lpm97/BA_MagicTrick/6_Fotos/PXL_20210323_134111129.jpg

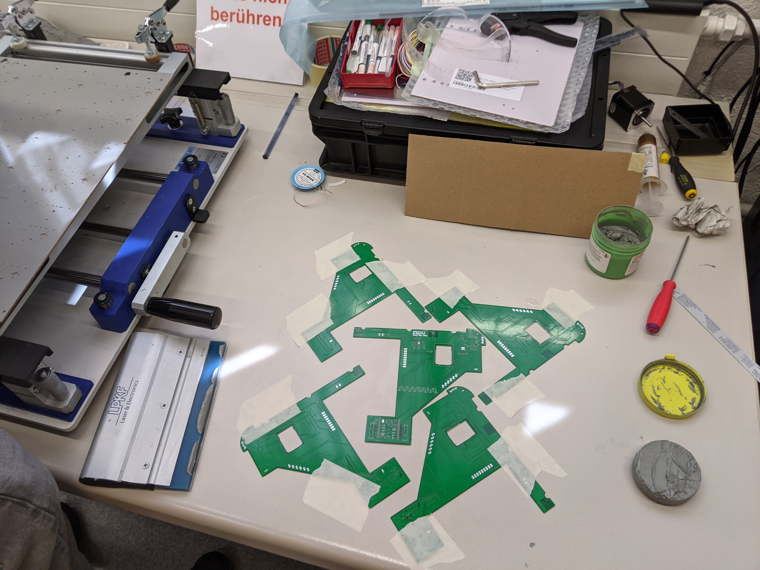
6_Fotos/PXL_20210323_134111129.jpg
