lpm97/BA_MagicTrick/6_Fotos/20210529_131418.jpg

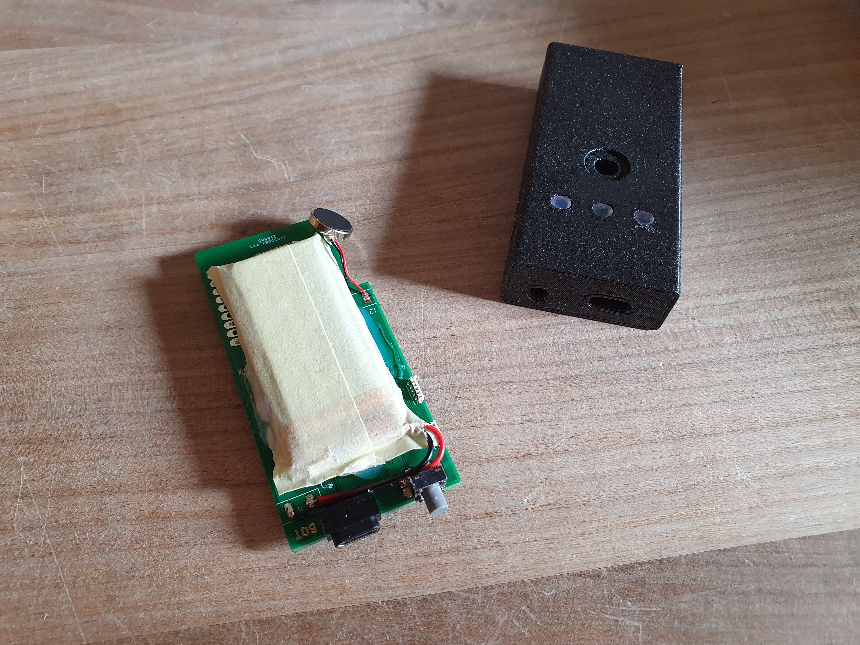
6_Fotos/20210529_131418.jpg
