lpm97/BA_MagicTrick/Ordnerstruktur.pdf

Ordnerstruktur

### Ordnerstruktur

### 0 BA wuem 05 Bericht

### 1 Reader

CAD-Files

Eagle-Projekt

Reader Code

### 2 Whiteboard

CAD-Files

Eagle-Projekt

WB2 Code

### 3 Puzzlerahmen

CAD-Files

Eagle-Projekt

Puzzle Code

### 4 Fernbedienung

CAD-Files

Eagle-Projekt

Remote Code

### 5 Eagle Library

Step-Files

### 6 Fotos

### 7 Bestellungen

11.06.2021 / Marco Mathys, Louis Muntwyler | 1 / 1
