lpm97/BA_MagicTrick/7_Bestellungen/4_Bestellung_BA_Magic_DigiKey_03_25.pdf

ARTIKELNUMMER | BEZEICHNUNG | Anzahl Einzelpreis
336-1160-1-ND | IC USB-TO-UART BRIDGE 28VQFN | 3 | 2.97
1144-1320-ND | SOLENOID PULL PULSE 5V | 1 | 9.14
1543-1001-ND | RFID TAG R/W 860-960MHZ INLAY | 25 | 0.35
1543-1002-ND | RFID TAG R/W 860-960MHZ INLAY | 25 | 0.35
1543-1011-ND | RFID TAG R/W 860-960MHZ INLAY | 25 | 0.35
1460-1159-ND | STEPPER MOTOR DRIVER BRD TMC2100 | 2 | 7.18
| | | 58.66
