lpm97/BA_MagicTrick/7_Bestellungen/5_Bestellung_BA_Magic_Conrad_04_13.pdf

ARTIKELNUMMER | BEZEICHNUNG | Anzahl Einzelpreis
802243954 - 62 | Pololu DRV8834 Low-Voltage Stepper Motortreiber Carrier | 4 | 5.66

22.64
