lpm97/BA_MagicTrick/2_Whiteboard/Eagle-Projekt/Bestückung_WB2.pdf

U5

# TCS40DPR

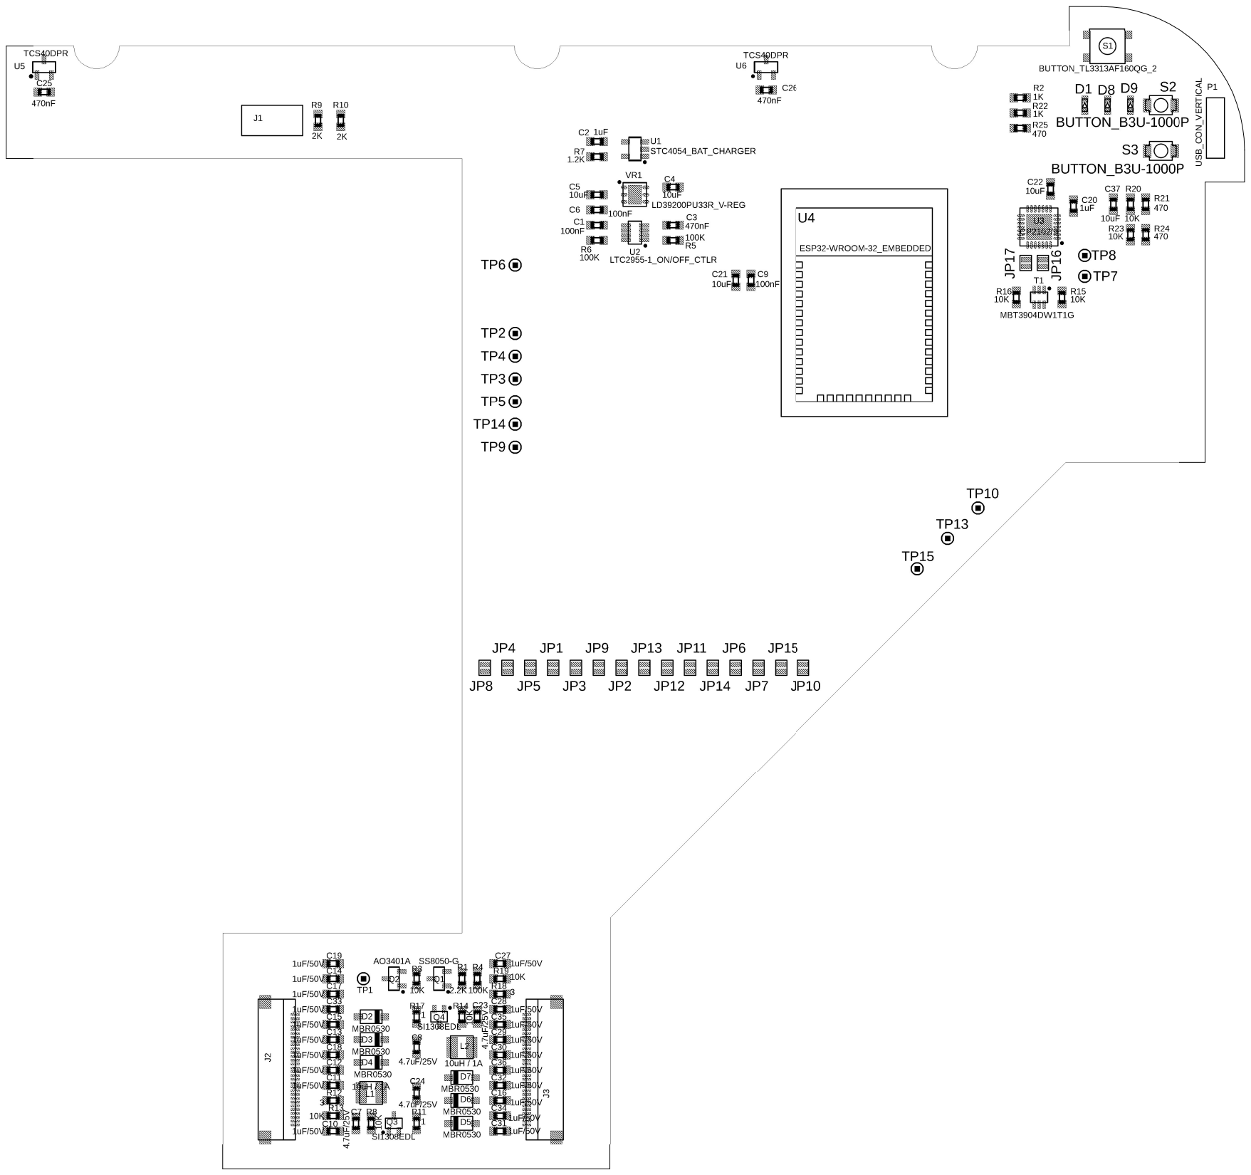
[picture p3: page 1]

P1 4.7uF/25V

470nF | USB_CON_VERTICAL
