lpm97/BA_MagicTrick/7_Bestellungen/8_Bestellung_BA_Magic_JLCPCB_05_05.pdf

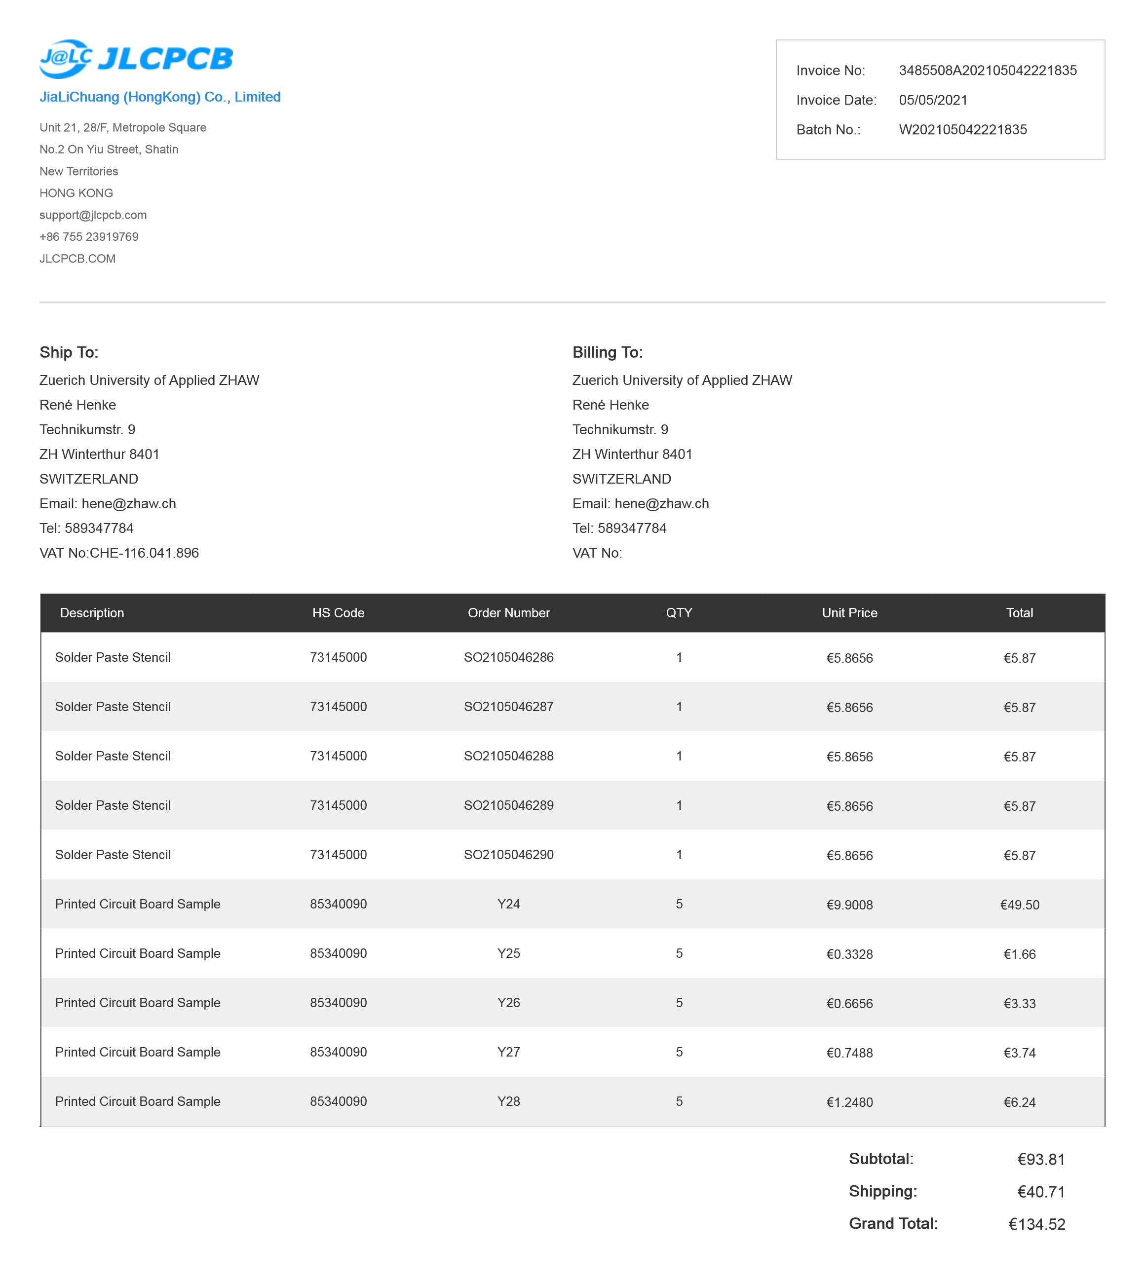
[picture p4: page 1]
