lpm97/BA_MagicTrick/6_Fotos/20210429_133818.jpg

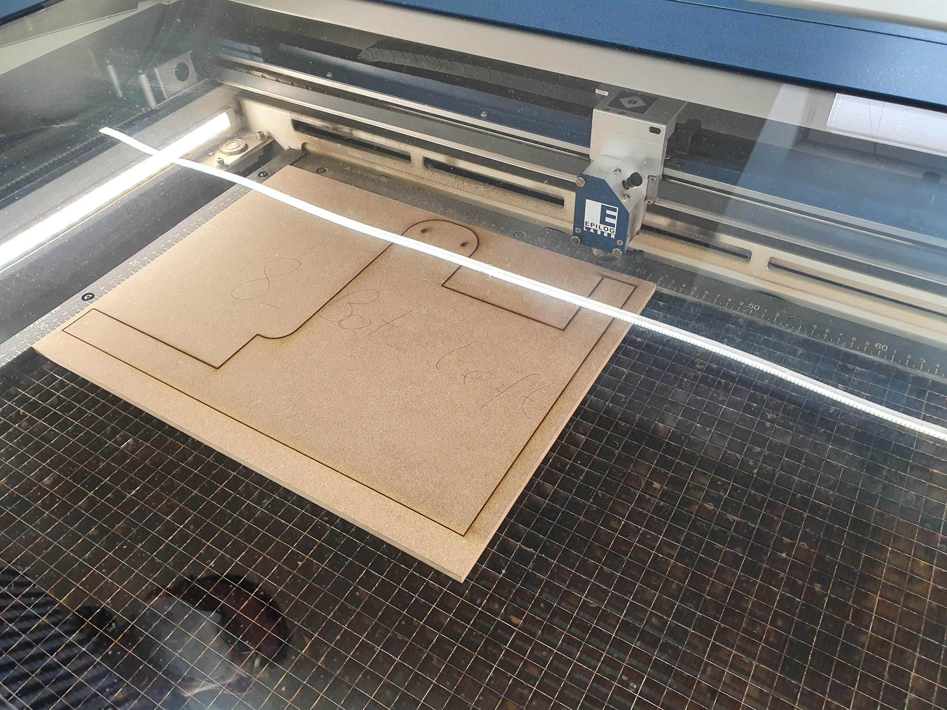
6_Fotos/20210429_133818.jpg
