lpm97/BA_MagicTrick/6_Fotos/20210510_140635.jpg

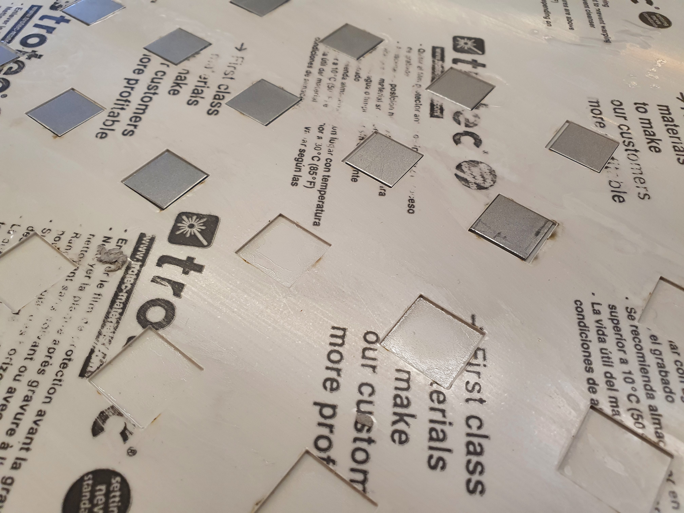
6_Fotos/20210510_140635.jpg
