lpm97/BA_MagicTrick/6_Fotos/20210518_130427.jpg

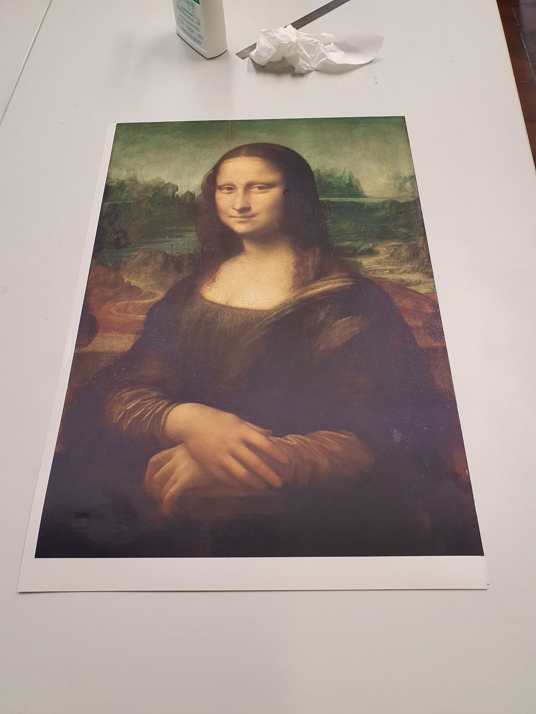
6_Fotos/20210518_130427.jpg
