lpm97/BA_MagicTrick/6_Fotos/20210529_162816 (2).jpg

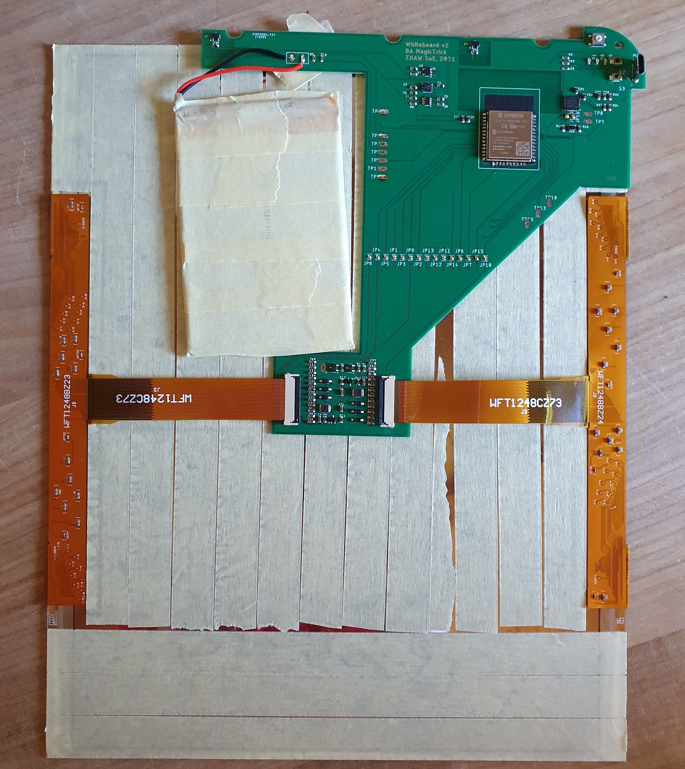
6_Fotos/20210529_162816 (2).jpg
