lpm97/BA_MagicTrick/6_Fotos/20210606_123722.jpg

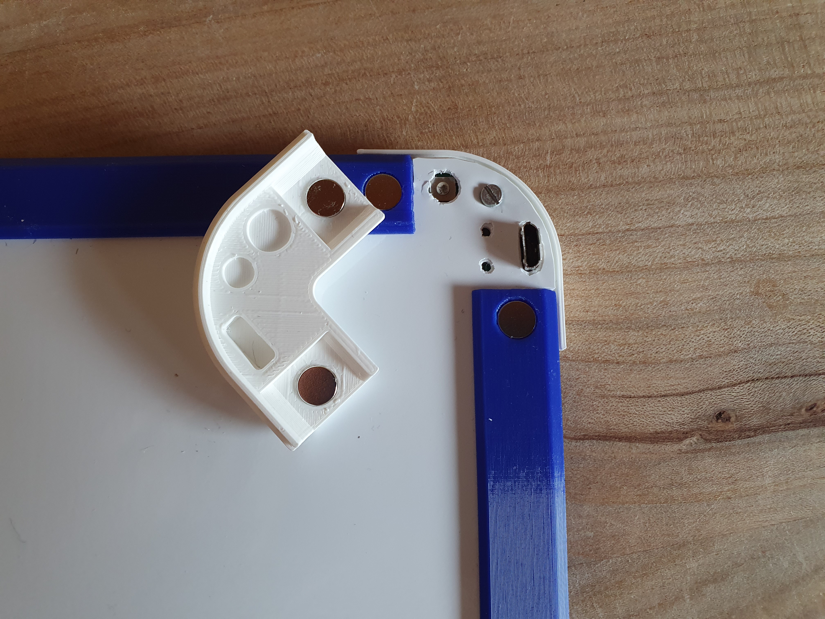
6_Fotos/20210606_123722.jpg
