lpm97/BA_MagicTrick/6_Fotos/20210608_213959.jpg

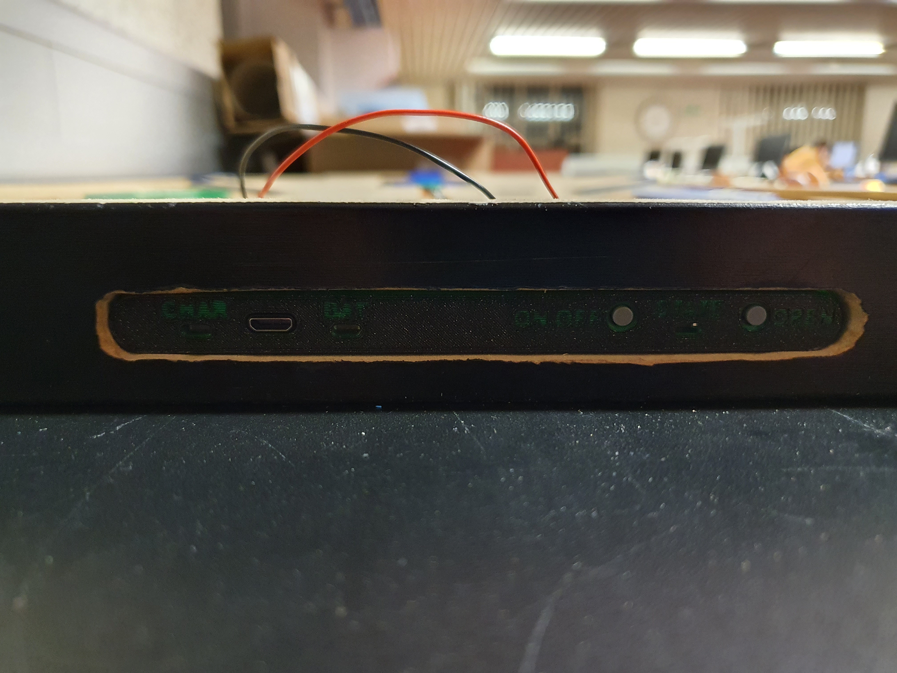
6_Fotos/20210608_213959.jpg
