lpm97/BA_MagicTrick/6_Fotos/20210609_110846.jpg

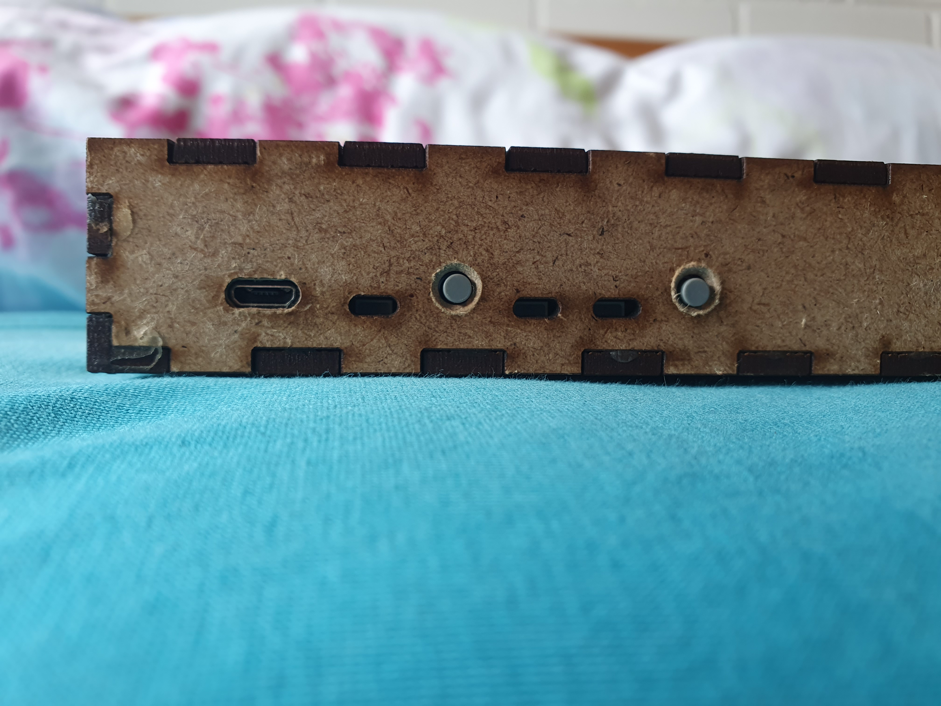
6_Fotos/20210609_110846.jpg
