lpm97/BA_MagicTrick/6_Fotos/20210609_110910.jpg

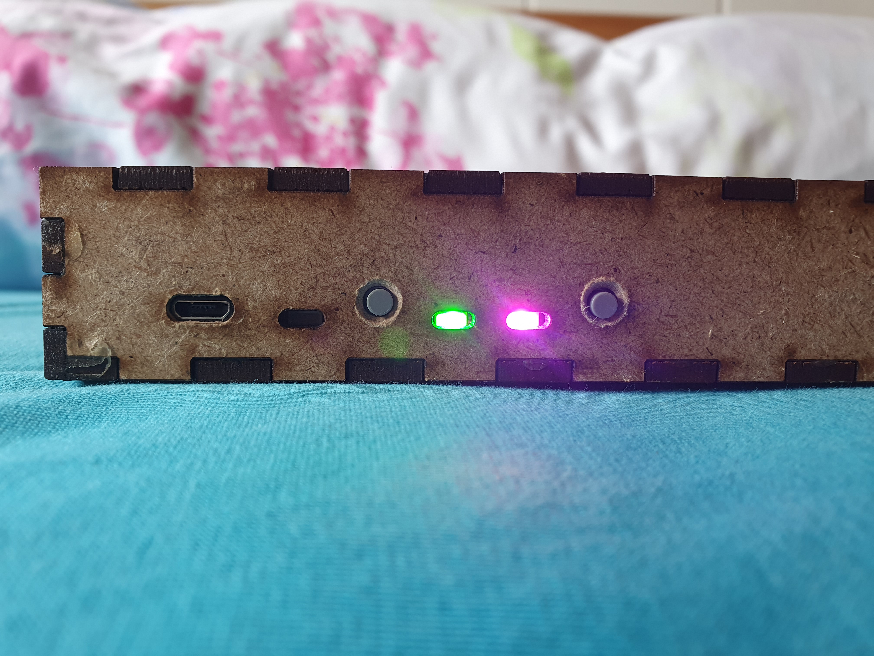
6_Fotos/20210609_110910.jpg
