lpm97/BA_MagicTrick/6_Fotos/PXL_20210330_091742719.jpg

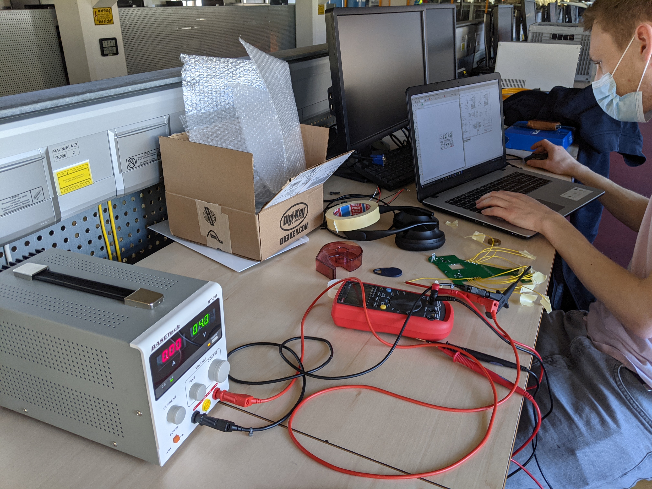
6_Fotos/PXL_20210330_091742719.jpg
