lpm97/BA_MagicTrick/6_Fotos/PXL_20210408_143214023.jpg

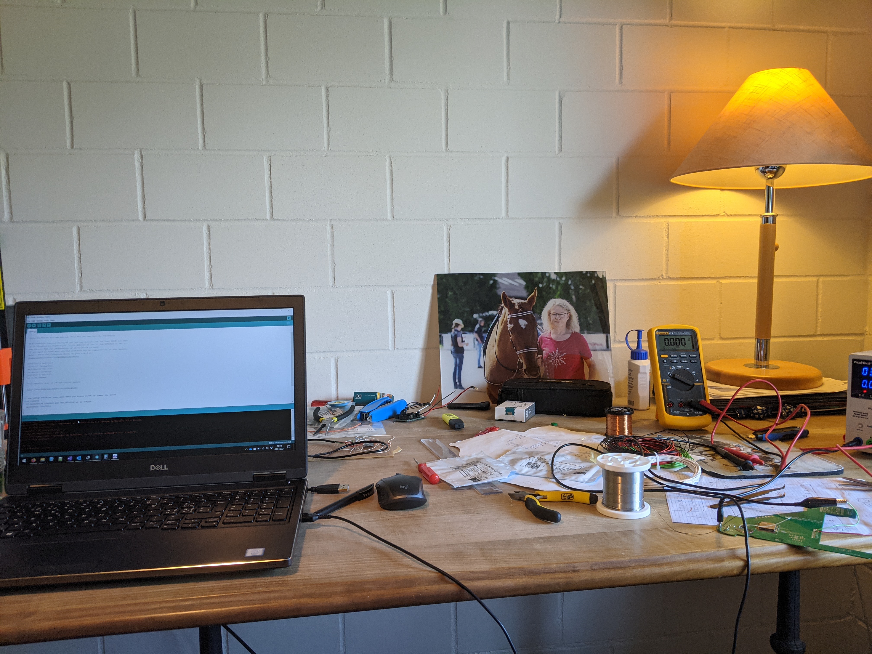
6_Fotos/PXL_20210408_143214023.jpg
