lpm97/BA_MagicTrick/6_Fotos/PXL_20210414_161440249.jpg

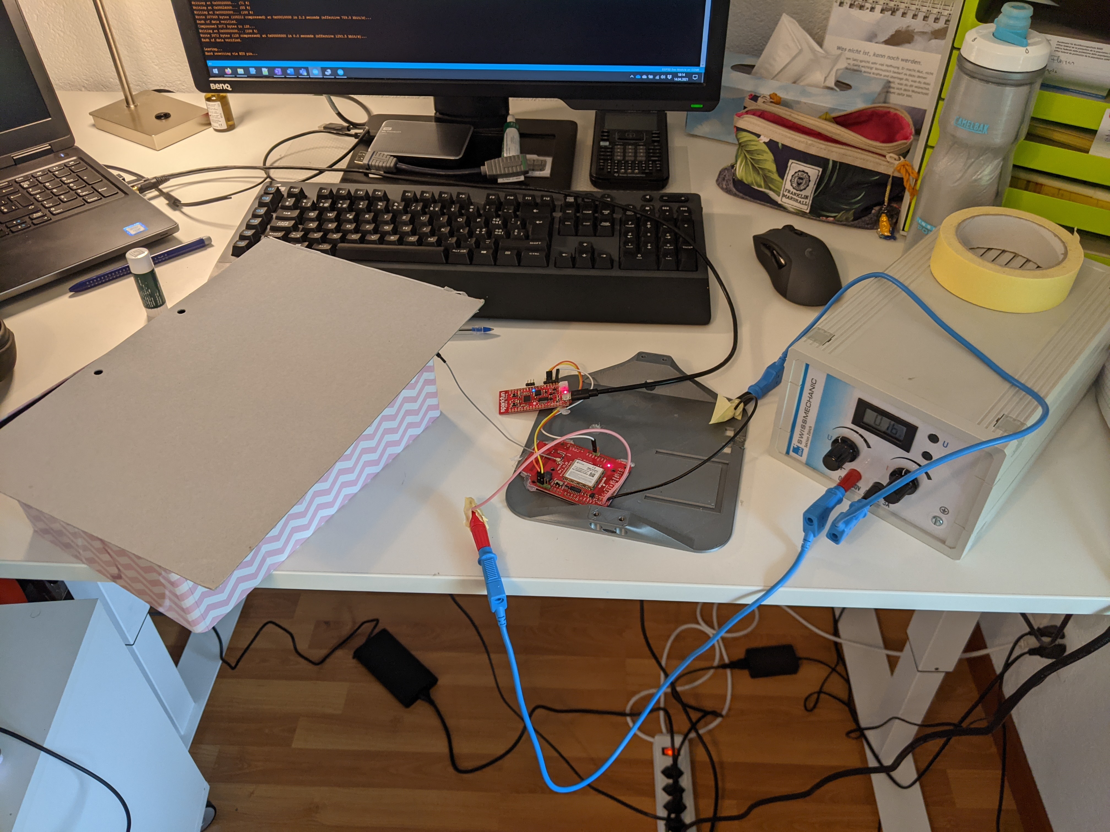
6_Fotos/PXL_20210414_161440249.jpg
