lpm97/BA_MagicTrick/6_Fotos/PXL_20210429_111400722.jpg

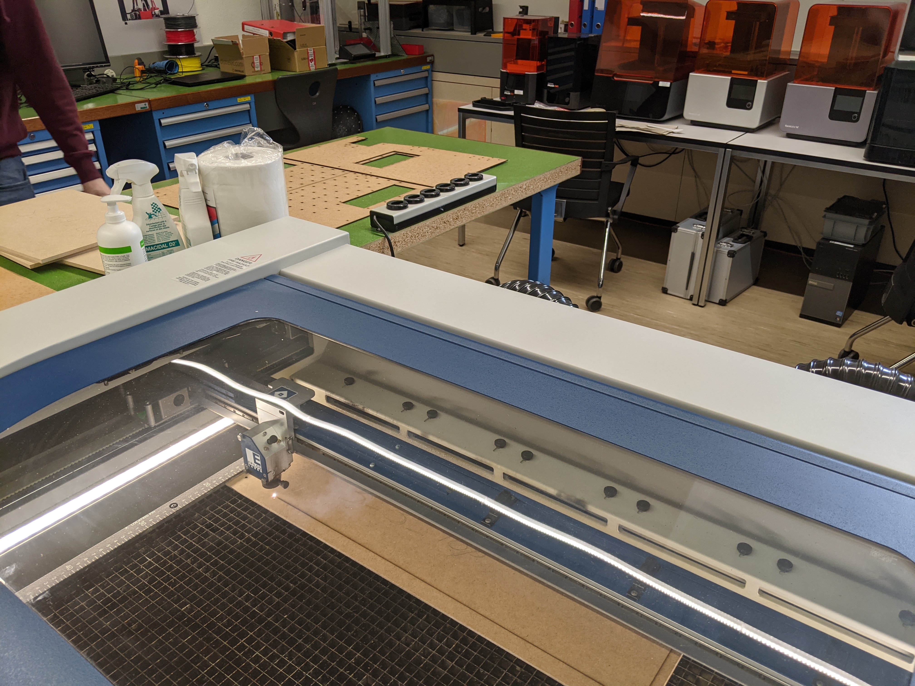
6_Fotos/PXL_20210429_111400722.jpg
