lpm97/BA_MagicTrick/2_Whiteboard/CAD-Files/BA_WB2_Assembly v29.stl

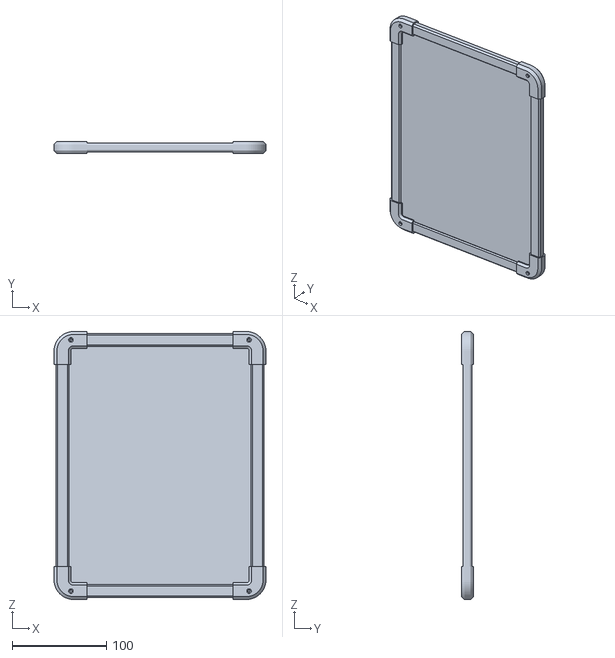
[picture p39: CAD file, 2021-06-11]
2_Whiteboard/CAD-Files/BA_WB2_Assembly v29.stl
225.2 x 13.0 x 284.7
