lpm97/BA_MagicTrick/5_Eagle_Library/Step-Files/LED_RGB_ASMB-TTF2-0B20B.step

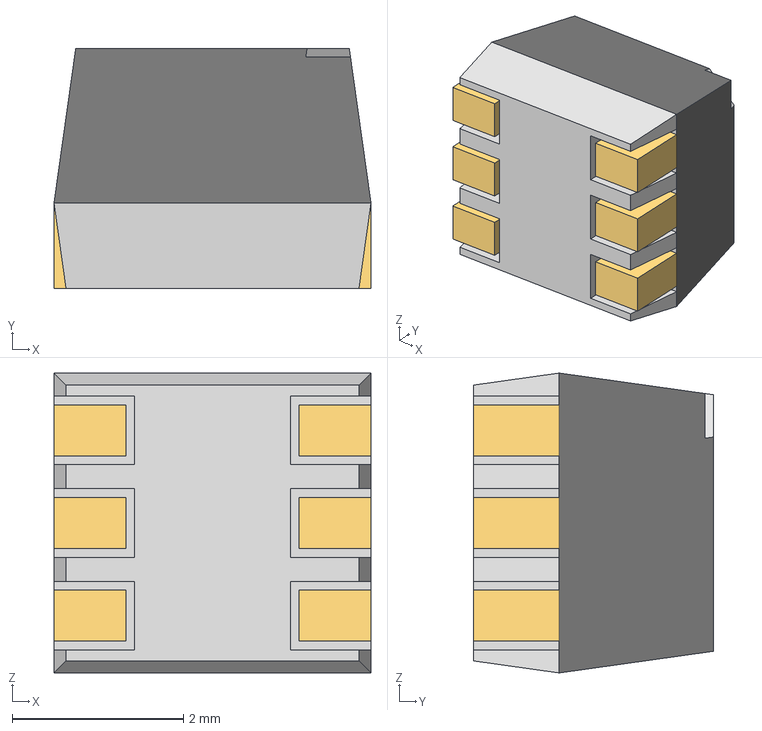
[picture p40: CAD file, 2021-06-11]
5_Eagle_Library/Step-Files/LED_RGB_ASMB-TTF2-0B20B.step
3.70 x 2.80 x 3.50 mm
