lpm97/BA_MagicTrick/3_Puzzlerahmen/CAD-Files/BA_Puzzle_Gear_Oeffnung v17.stl

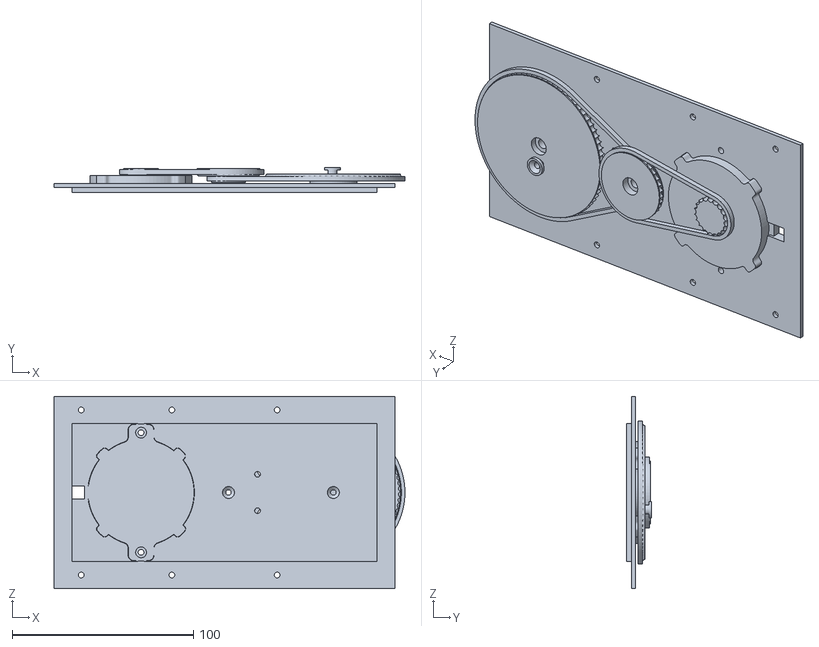
[picture p41: CAD file, 2021-06-11]
3_Puzzlerahmen/CAD-Files/BA_Puzzle_Gear_Oeffnung v17.stl
193.5 x 14.0 x 106.0
