lpm97/BA_MagicTrick/4_Fernbedienung/CAD-Files/BA_RemoteControl_Housing v5.stl

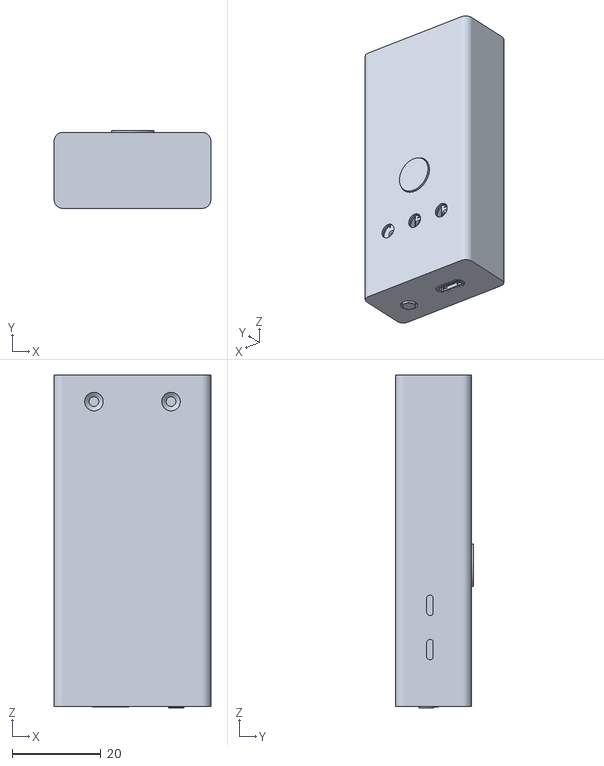
[picture p42: CAD file, 2021-06-11]
4_Fernbedienung/CAD-Files/BA_RemoteControl_Housing v5.stl
35.4 x 17.6 x 75.2
