lpm97/BA_MagicTrick/5_Eagle_Library/Step-Files/USB_Con_90_ZX62WRD-B-5PC.stp

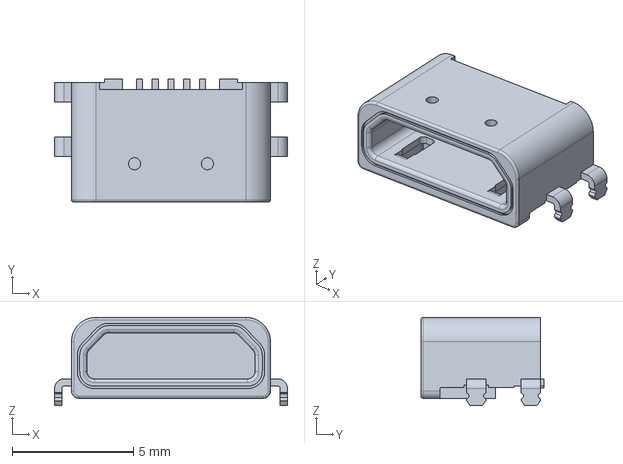
[picture p43: CAD file, 2021-06-11]
5_Eagle_Library/Step-Files/USB_Con_90_ZX62WRD-B-5PC.stp
9.60 x 5.09 x 3.63 mm
