lpm97/BA_MagicTrick/2_Whiteboard/CAD-Files/BA_WB2_PCB v3.stl

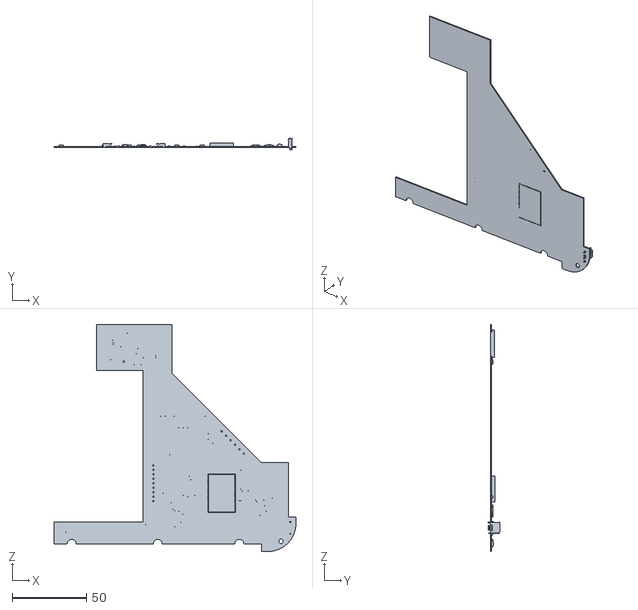
[picture p44: CAD file, 2021-06-11]
2_Whiteboard/CAD-Files/BA_WB2_PCB v3.stl
163.1 x 7.91 x 153.0
