lpm97/BA_MagicTrick/3_Puzzlerahmen/CAD-Files/BA_Puzzle_Seilwinde2 v18.stl

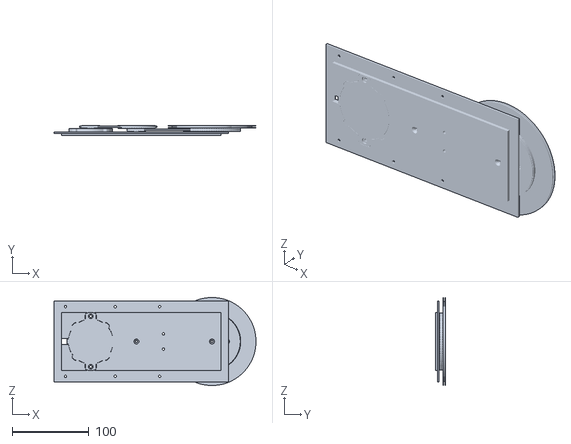
[picture p45: CAD file, 2021-06-11]
3_Puzzlerahmen/CAD-Files/BA_Puzzle_Seilwinde2 v18.stl
263.9 x 13.4 x 115.0
