lpm97/BA_MagicTrick/4_Fernbedienung/CAD-Files/RemoteControl_PCB v7.stl

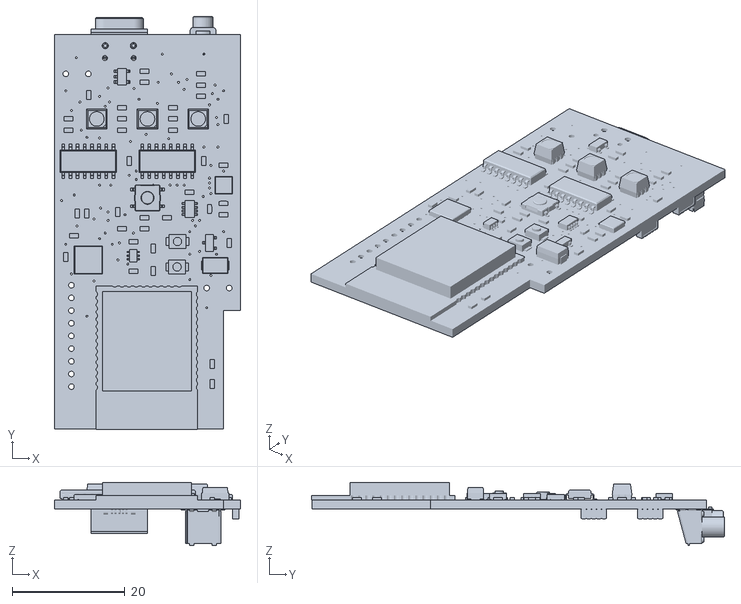
[picture p46: CAD file, 2021-06-11]
4_Fernbedienung/CAD-Files/RemoteControl_PCB v7.stl
33.0 x 73.3 x 11.2
