lpm97/BA_MagicTrick/5_Eagle_Library/Step-Files/Dubox14P_90_Male.stp

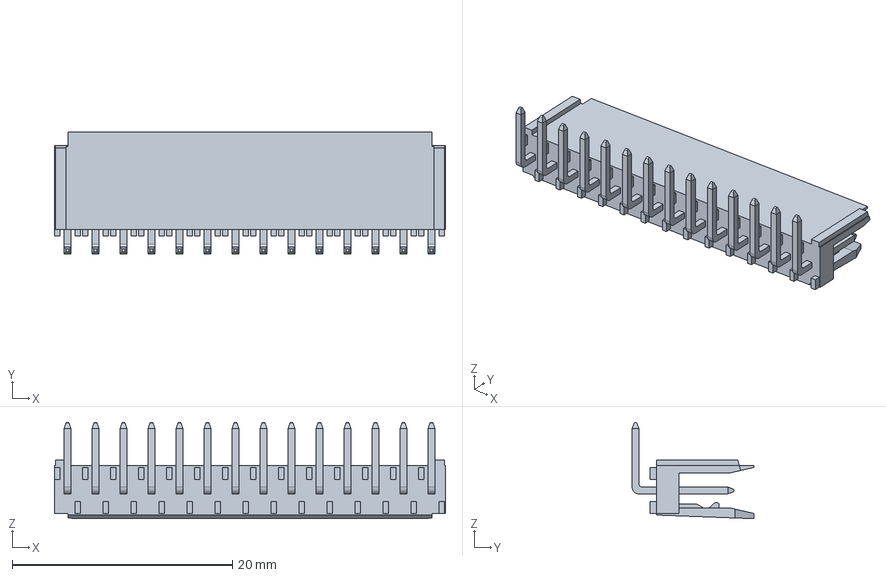
[picture p47: CAD file, 2021-06-11]
5_Eagle_Library/Step-Files/Dubox14P_90_Male.stp
35.5 x 11.0 x 8.74 mm
