lpm97/BA_MagicTrick/2_Whiteboard/CAD-Files/BA_WB2_Edge_bot v12.stl

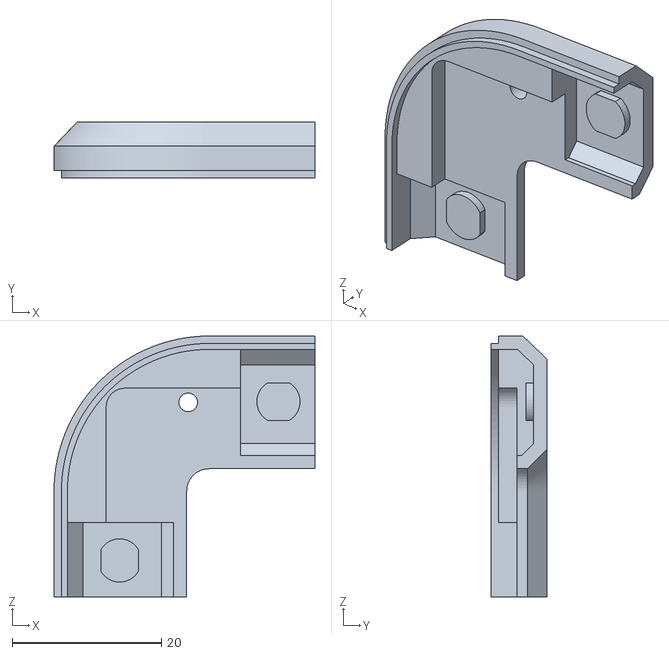
[picture p48: CAD file, 2021-06-11]
2_Whiteboard/CAD-Files/BA_WB2_Edge_bot v12.stl
35.0 x 7.50 x 35.0
