lpm97/BA_MagicTrick/3_Puzzlerahmen/CAD-Files/BA_Puzzle_CableOutput2 v16.stl

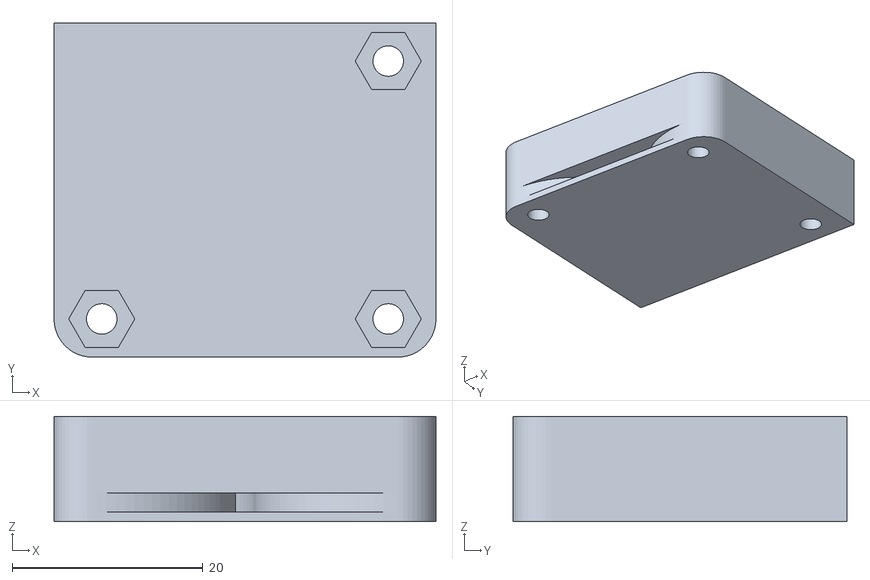
[picture p49: CAD file, 2021-06-11]
3_Puzzlerahmen/CAD-Files/BA_Puzzle_CableOutput2 v16.stl
40.0 x 35.0 x 11.0
