lpm97/BA_MagicTrick/5_Eagle_Library/Step-Files/Cap_0603.stp

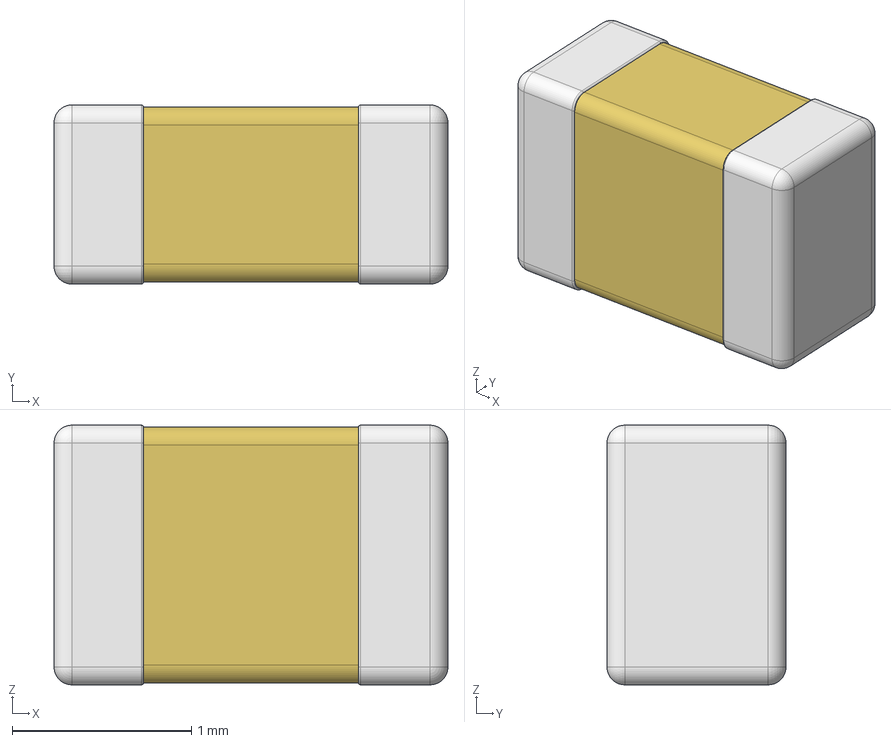
[picture p50: CAD file, 2021-06-11]
5_Eagle_Library/Step-Files/Cap_0603.stp
2.20 x 1.00 x 1.45 mm
