lpm97/BA_MagicTrick/2_Whiteboard/CAD-Files/BA_WB2_Display14.48.stl

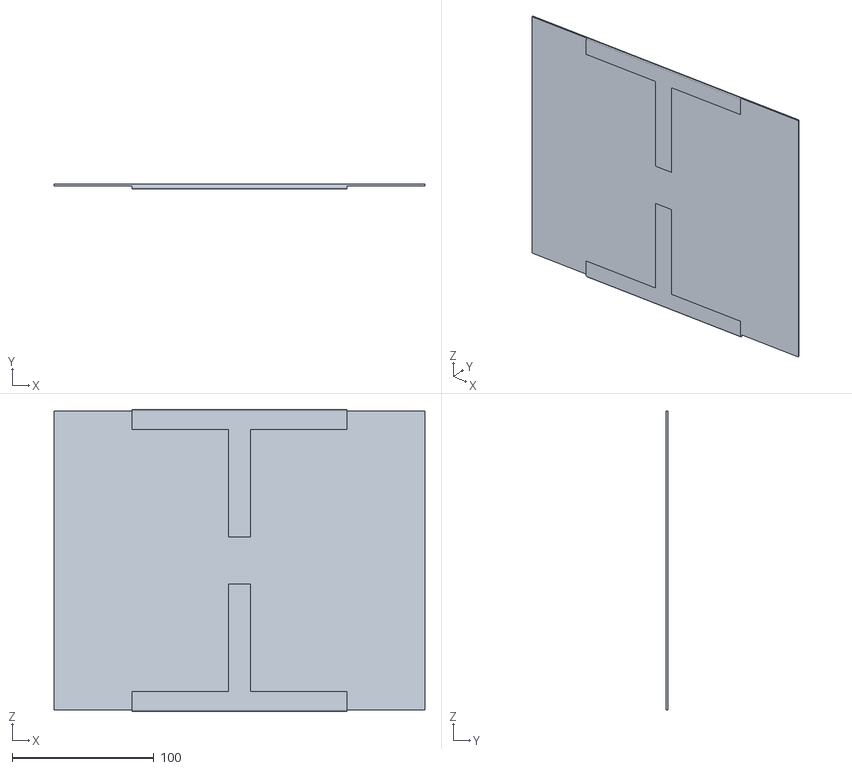
[picture p51: CAD file, 2021-06-11]
2_Whiteboard/CAD-Files/BA_WB2_Display14.48.stl
261.5 x 3.20 x 213.2
