lpm97/BA_MagicTrick/3_Puzzlerahmen/CAD-Files/BA_Puzzle_Umlenkrolle2 v18.stl

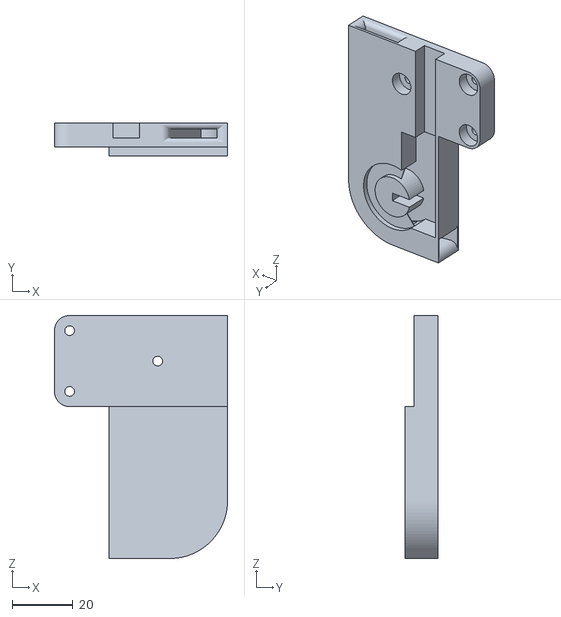
[picture p52: CAD file, 2021-06-11]
3_Puzzlerahmen/CAD-Files/BA_Puzzle_Umlenkrolle2 v18.stl
57.0 x 11.0 x 80.0
