lpm97/BA_MagicTrick/5_Eagle_Library/Step-Files/USB_Con_90_UJ2.step

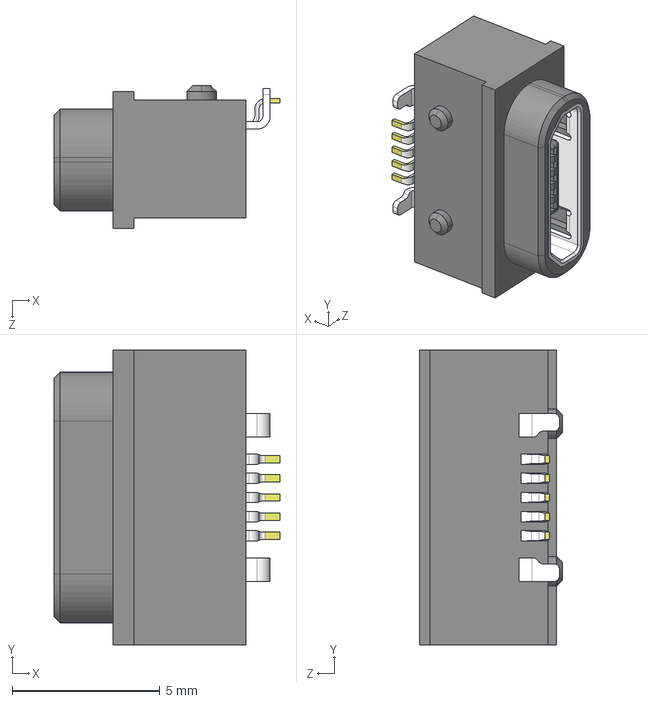
[picture p53: CAD file, 2021-06-11]
5_Eagle_Library/Step-Files/USB_Con_90_UJ2.step
7.65 x 10.0 x 4.85 mm
