lpm97/BA_MagicTrick/2_Whiteboard/CAD-Files/BA_WB2_Edge_Int_Top v21.stl

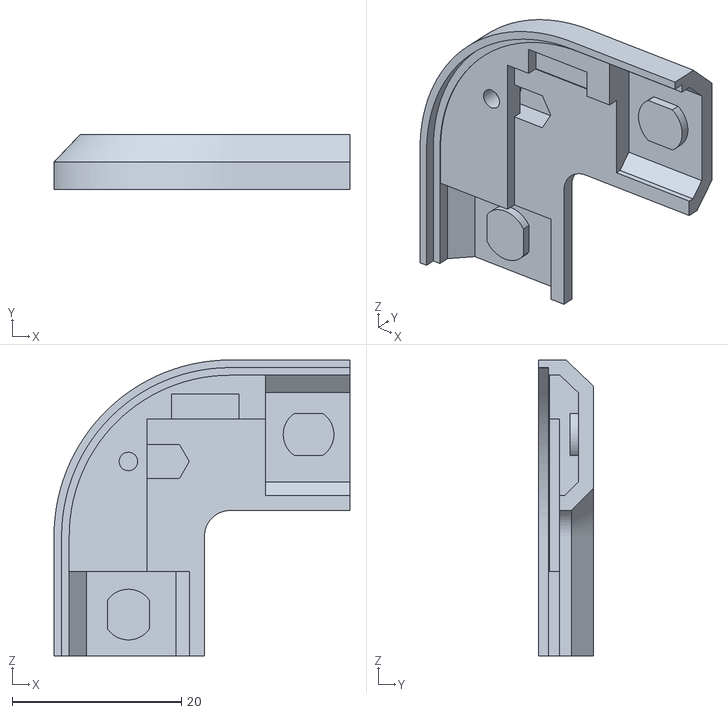
[picture p54: CAD file, 2021-06-11]
2_Whiteboard/CAD-Files/BA_WB2_Edge_Int_Top v21.stl
35.0 x 6.50 x 35.0
