lpm97/BA_MagicTrick/3_Puzzlerahmen/CAD-Files/BA_Puzzle_Tilt2 v27.stl

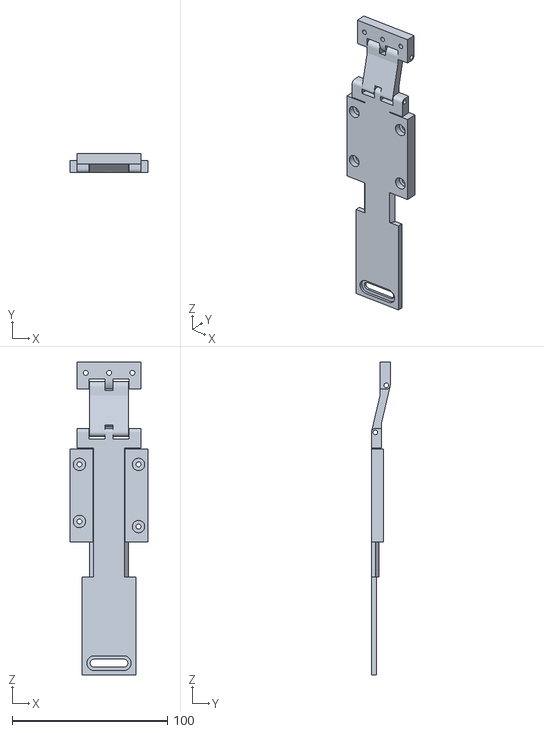
[picture p55: CAD file, 2021-06-11]
3_Puzzlerahmen/CAD-Files/BA_Puzzle_Tilt2 v27.stl
50.0 x 12.3 x 201.3
