lpm97/BA_MagicTrick/5_Eagle_Library/Step-Files/srn3015-100m_induction.stp

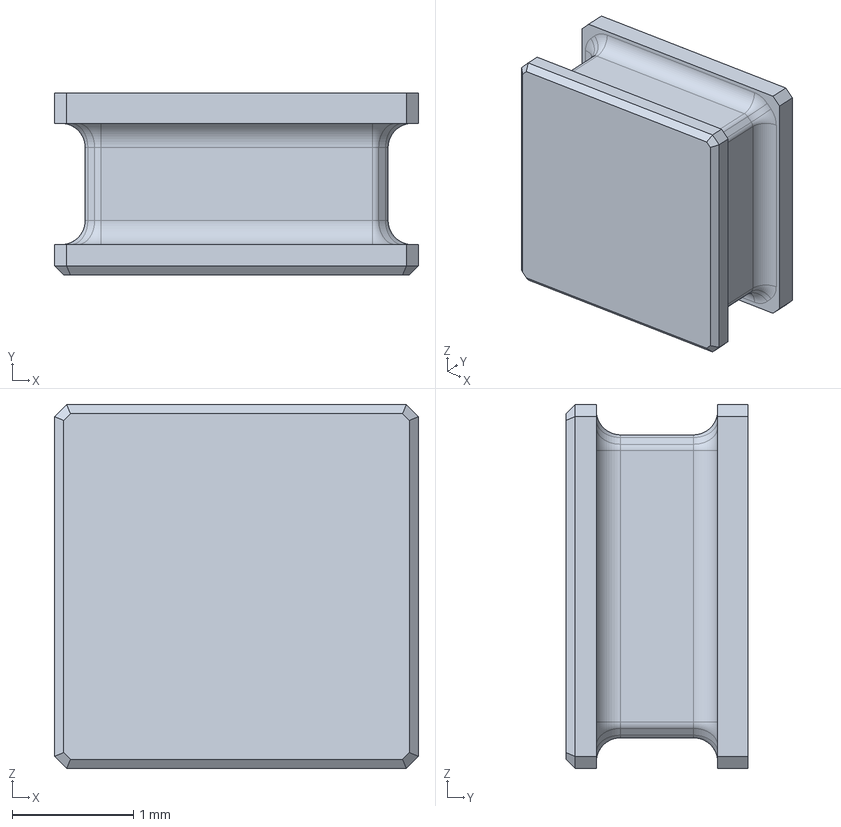
[picture p56: CAD file, 2021-06-11]
5_Eagle_Library/Step-Files/srn3015-100m_induction.stp
3.00 x 1.50 x 3.00 mm
