lpm97/BA_MagicTrick/2_Whiteboard/CAD-Files/BA_WB2_Side_Right v4.stl

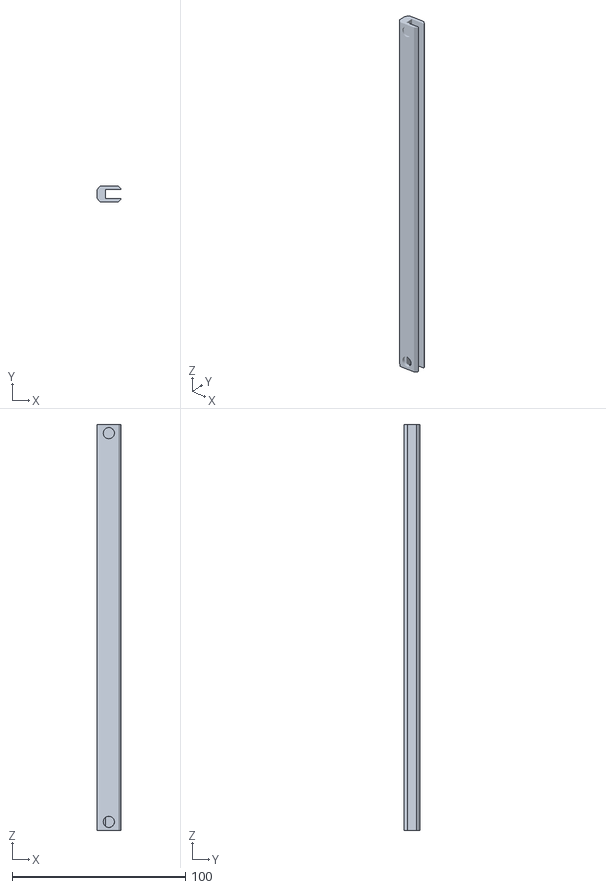
[picture p57: CAD file, 2021-06-11]
2_Whiteboard/CAD-Files/BA_WB2_Side_Right v4.stl
14.0 x 9.20 x 234.5
