lpm97/BA_MagicTrick/3_Puzzlerahmen/CAD-Files/BA_Puzzle_Backmount v7.stl

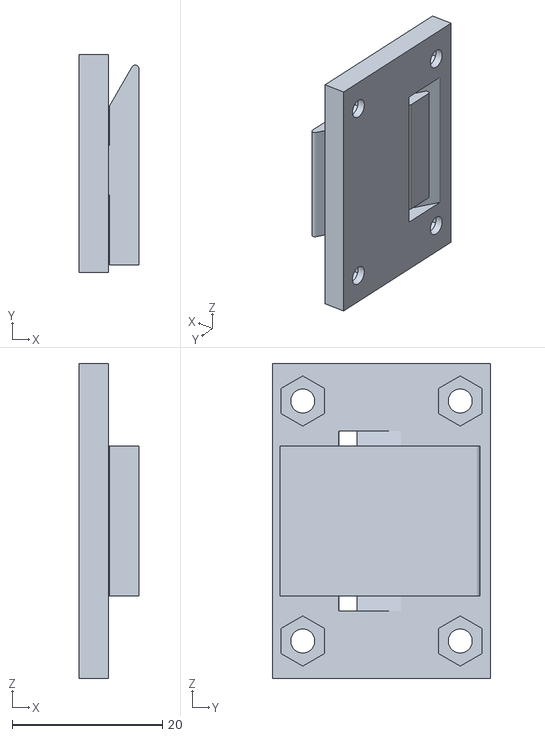
[picture p58: CAD file, 2021-06-11]
3_Puzzlerahmen/CAD-Files/BA_Puzzle_Backmount v7.stl
8.00 x 29.0 x 42.0
