lpm97/BA_MagicTrick/5_Eagle_Library/Step-Files/Dubox12P_90_Male.stp

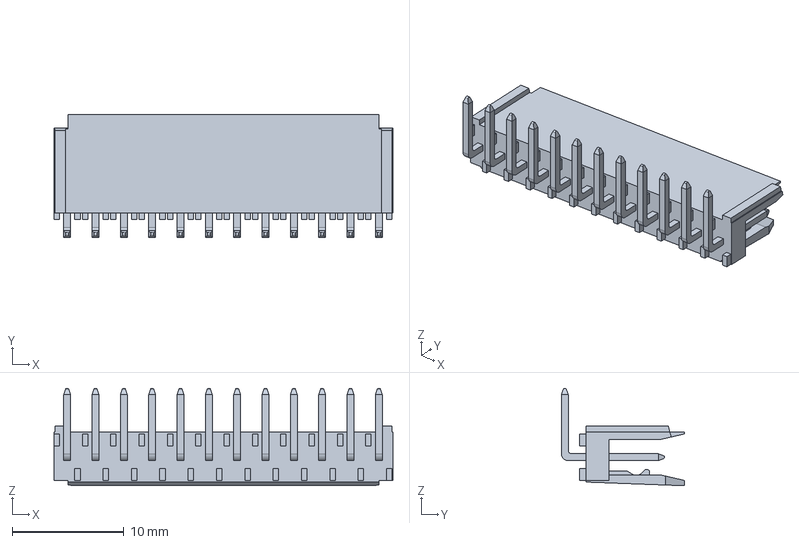
[picture p59: CAD file, 2021-06-11]
5_Eagle_Library/Step-Files/Dubox12P_90_Male.stp
30.4 x 11.0 x 8.74 mm
