lpm97/BA_MagicTrick/2_Whiteboard/CAD-Files/BA_WB2_Backcover v72.stl

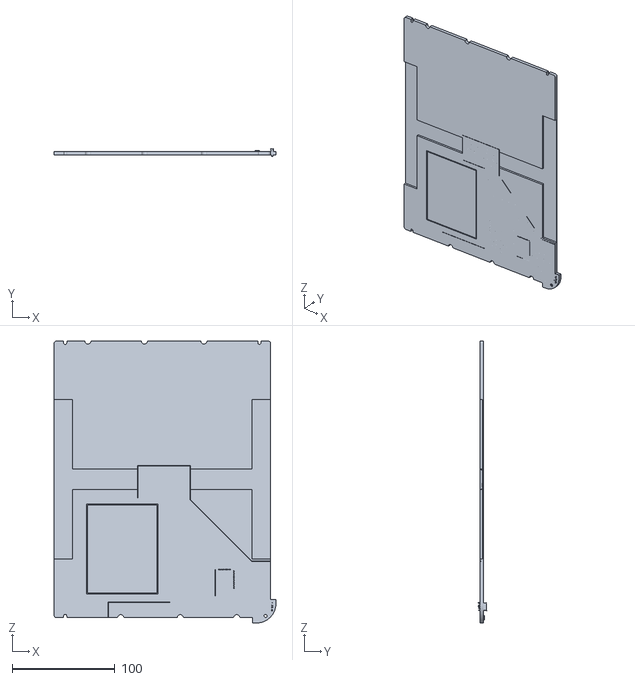
[picture p60: CAD file, 2021-06-11]
2_Whiteboard/CAD-Files/BA_WB2_Backcover v72.stl
216.2 x 7.91 x 274.7
