lpm97/BA_MagicTrick/3_Puzzlerahmen/CAD-Files/BA_Puzzle_Picker_Final v5.stl

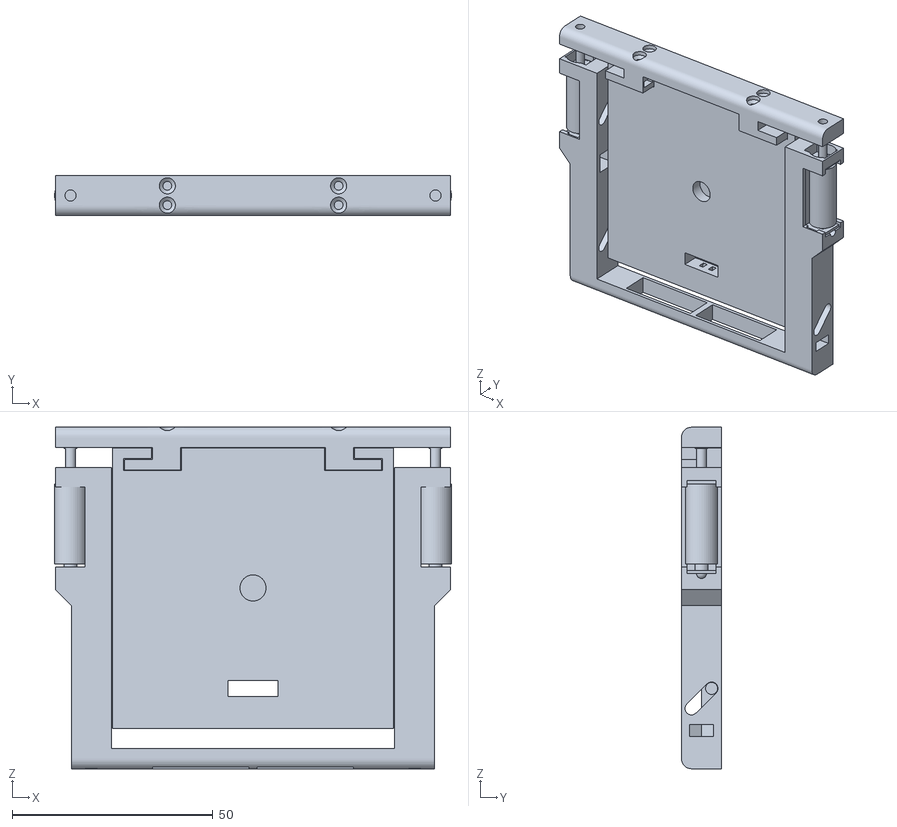
[picture p61: CAD file, 2021-06-11]
3_Puzzlerahmen/CAD-Files/BA_Puzzle_Picker_Final v5.stl
98.8 x 10.0 x 85.0
