lpm97/BA_MagicTrick/3_Puzzlerahmen/CAD-Files/BA_Puzzle_Interface v1.stl

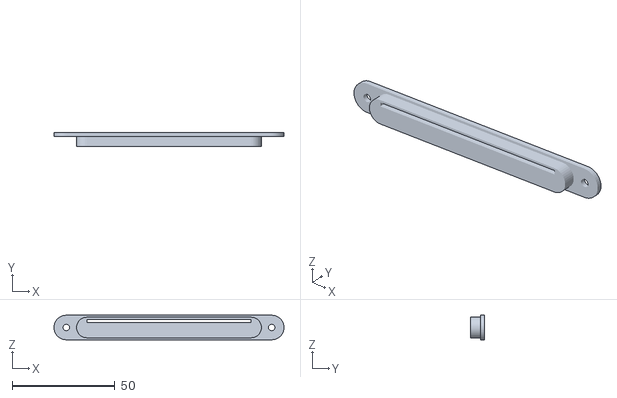
[picture p64: CAD file, 2021-06-11]
3_Puzzlerahmen/CAD-Files/BA_Puzzle_Interface v1.stl
112.0 x 7.00 x 12.0
