lpm97/BA_MagicTrick/5_Eagle_Library/Step-Files/BA_EAGLE_M6E-Nano_1 v2.step

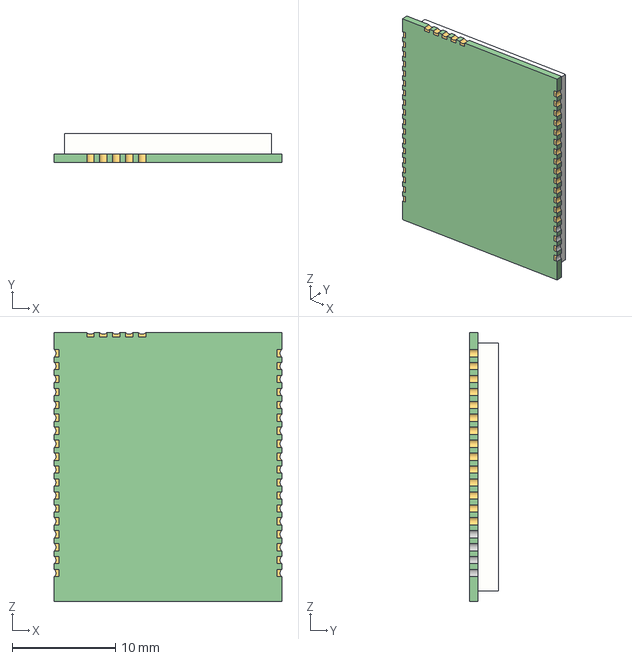
[picture p65: CAD file, 2021-06-11]
5_Eagle_Library/Step-Files/BA_EAGLE_M6E-Nano_1 v2.step
22.0 x 2.80 x 26.0 mm
