lpm97/BA_MagicTrick/2_Whiteboard/CAD-Files/BA_WB2_Side_Bot v6.stl

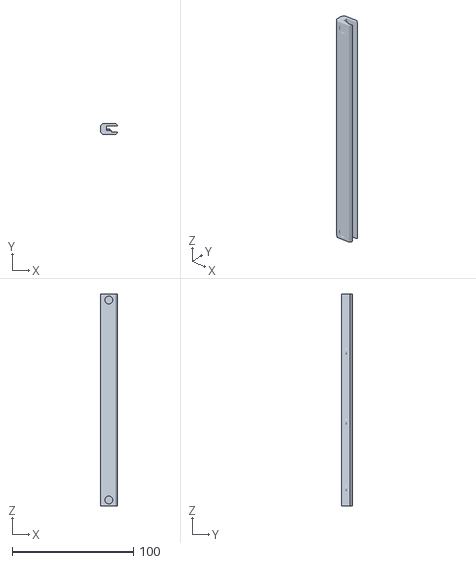
[picture p66: CAD file, 2021-06-11]
2_Whiteboard/CAD-Files/BA_WB2_Side_Bot v6.stl
14.0 x 9.20 x 175.0
