lpm97/BA_MagicTrick/3_Puzzlerahmen/CAD-Files/BA_Puzzle_Hinge3.stl

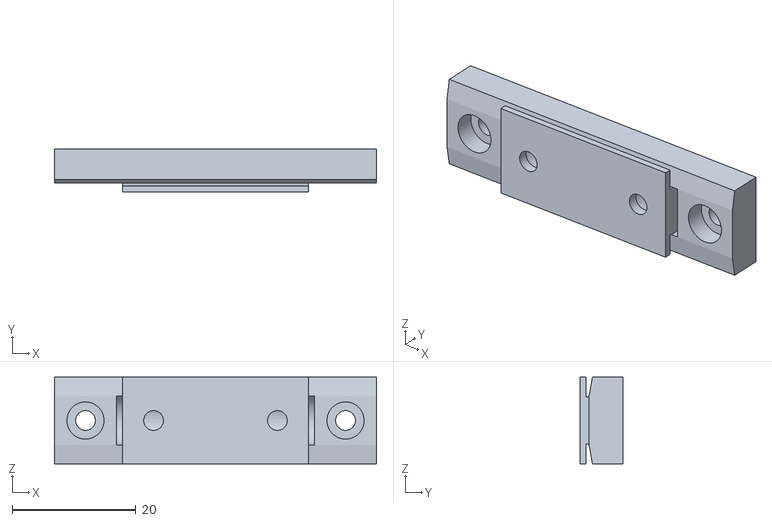
[picture p67: CAD file, 2021-06-11]
3_Puzzlerahmen/CAD-Files/BA_Puzzle_Hinge3.stl
52.0 x 7.00 x 14.0
