lpm97/BA_MagicTrick/5_Eagle_Library/Step-Files/CONSMA020.062-G--3DModel-STEP-56544.STEP

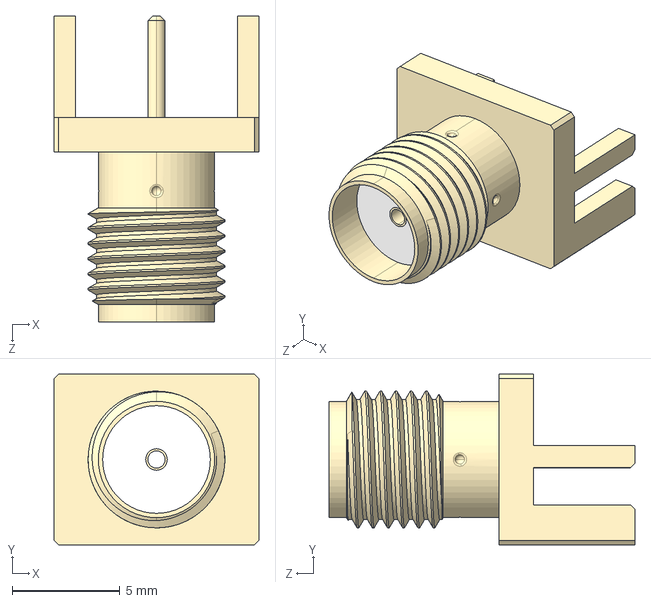
[picture p68: CAD file, 2021-06-11]
5_Eagle_Library/Step-Files/CONSMA020.062-G--3DModel-STEP-56544.STEP
9.52 x 7.92 x 14.2 mm
