lpm97/BA_MagicTrick/2_Whiteboard/CAD-Files/BA_WB2_Edge_top v23.stl

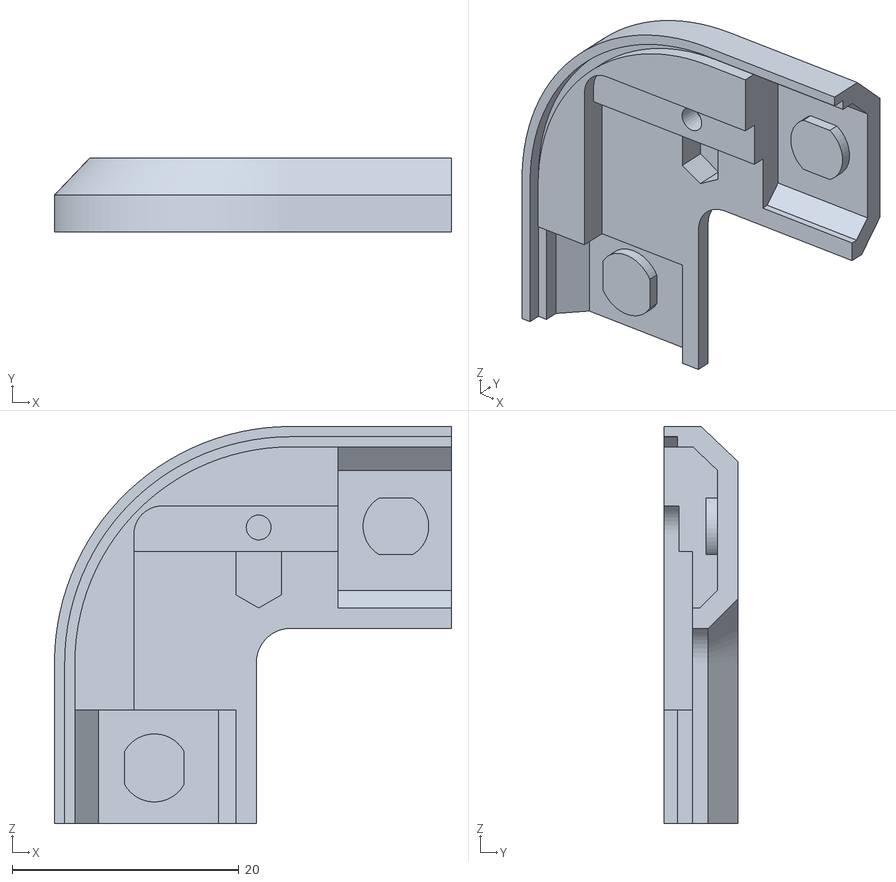
[picture p69: CAD file, 2021-06-11]
2_Whiteboard/CAD-Files/BA_WB2_Edge_top v23.stl
35.0 x 6.50 x 35.0
