lpm97/BA_MagicTrick/5_Eagle_Library/Step-Files/xf2m-3015-1a_Con30P.stp

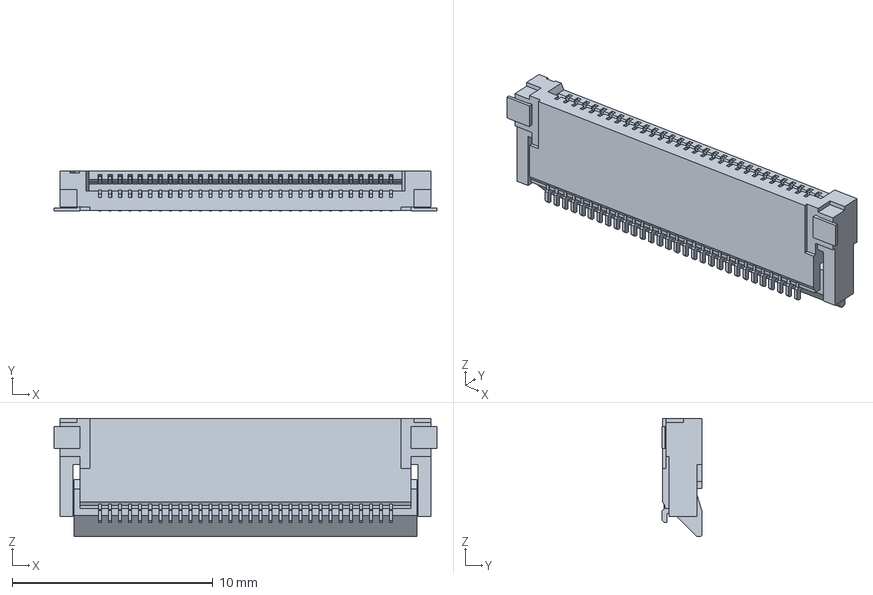
[picture p70: CAD file, 2021-06-11]
5_Eagle_Library/Step-Files/xf2m-3015-1a_Con30P.stp
19.1 x 2.00 x 5.90 mm
