lpm97/BA_MagicTrick/5_Eagle_Library/Step-Files/0603_single_LED.stp

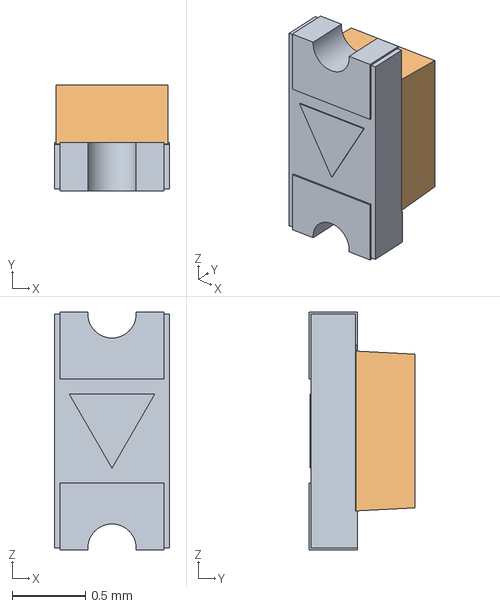
[picture p71: CAD file, 2021-06-11]
5_Eagle_Library/Step-Files/0603_single_LED.stp
0.787 x 0.724 x 1.63 mm
