lpm97/BA_MagicTrick/5_Eagle_Library/Step-Files/BA_EAGLE_ESP32_1 v1.step

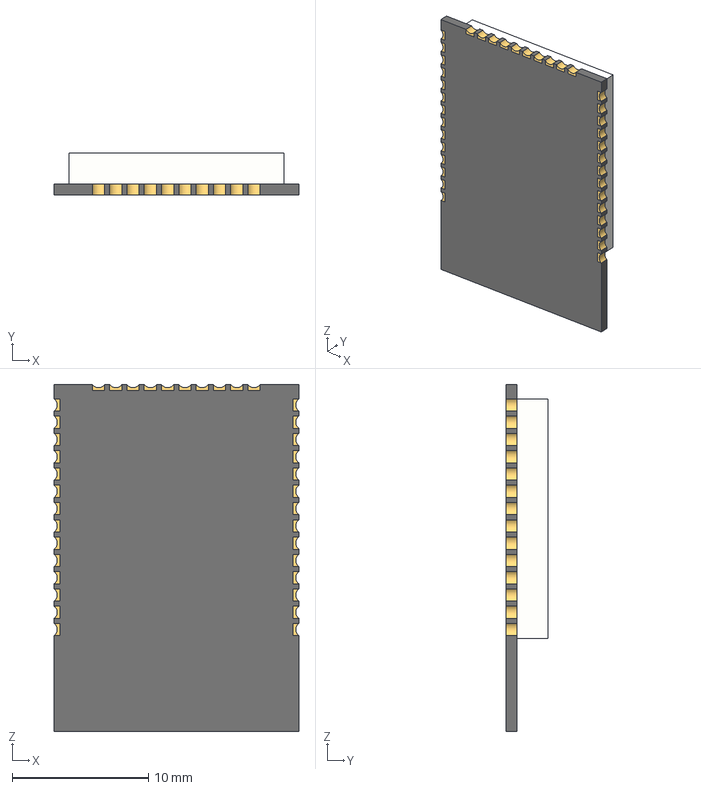
[picture p72: CAD file, 2021-06-11]
5_Eagle_Library/Step-Files/BA_EAGLE_ESP32_1 v1.step
18.0 x 3.10 x 25.5 mm
