lpm97/BA_MagicTrick/5_Eagle_Library/Step-Files/TL3313AFxxxQG_Button.stp

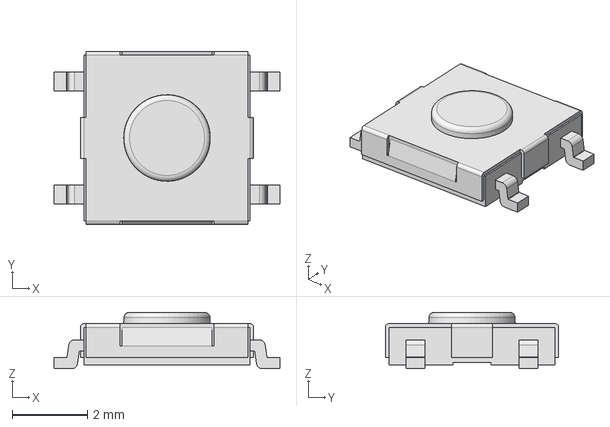
[picture p73: CAD file, 2021-06-11]
5_Eagle_Library/Step-Files/TL3313AFxxxQG_Button.stp
6.00 x 4.60 x 1.50 mm
