lpm97/BA_MagicTrick/5_Eagle_Library/Step-Files/Res_0603.stp

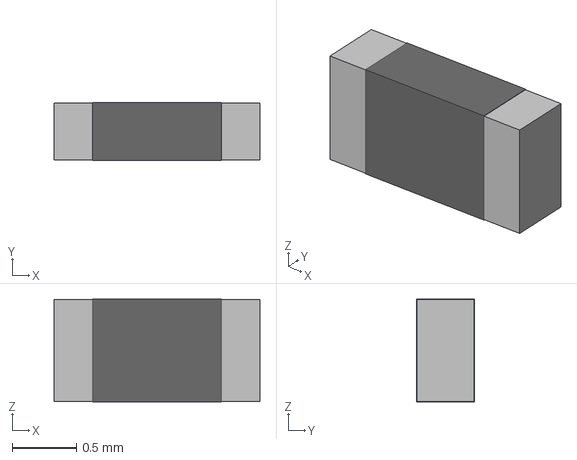
[picture p74: CAD file, 2021-06-11]
5_Eagle_Library/Step-Files/Res_0603.stp
1.60 x 0.45 x 0.8 mm
