lpm97/BA_MagicTrick/5_Eagle_Library/Step-Files/LED_RGB_90.step

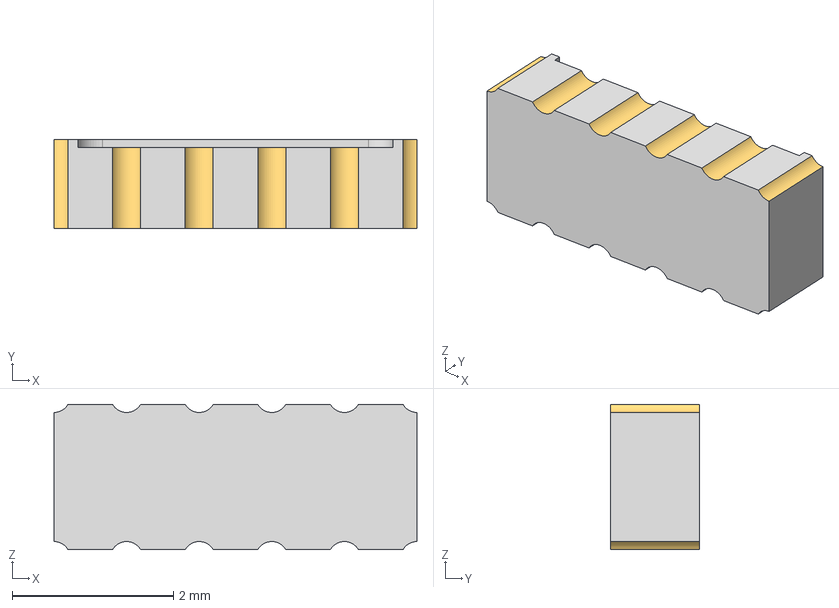
[picture p75: CAD file, 2021-06-11]
5_Eagle_Library/Step-Files/LED_RGB_90.step
4.50 x 1.10 x 1.80 mm
