lpm97/BA_MagicTrick/5_Eagle_Library/Step-Files/LED_RGB.step

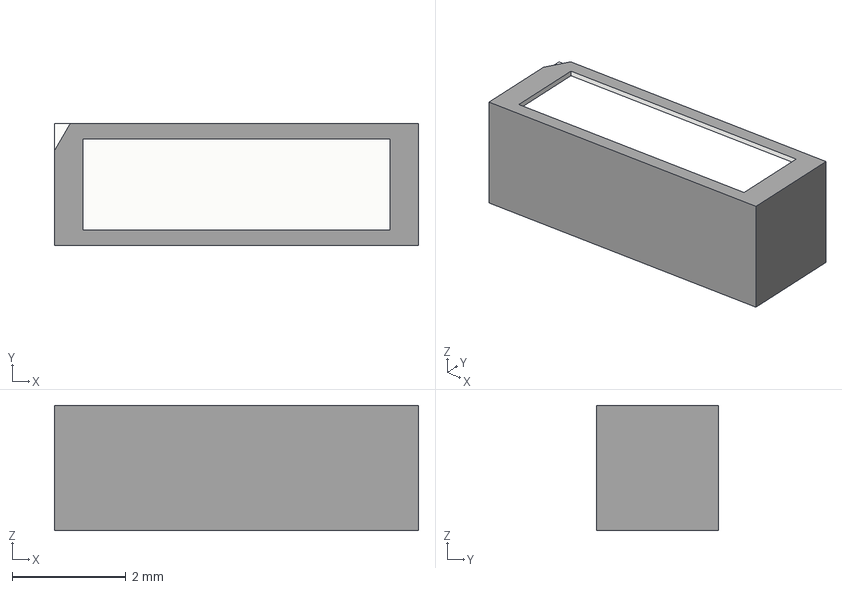
[picture p76: CAD file, 2021-06-11]
5_Eagle_Library/Step-Files/LED_RGB.step
6.40 x 2.15 x 2.20 mm
