lpm97/BA_MagicTrick/5_Eagle_Library/Step-Files/USB3131-30-0230-A_USB_Con.stp

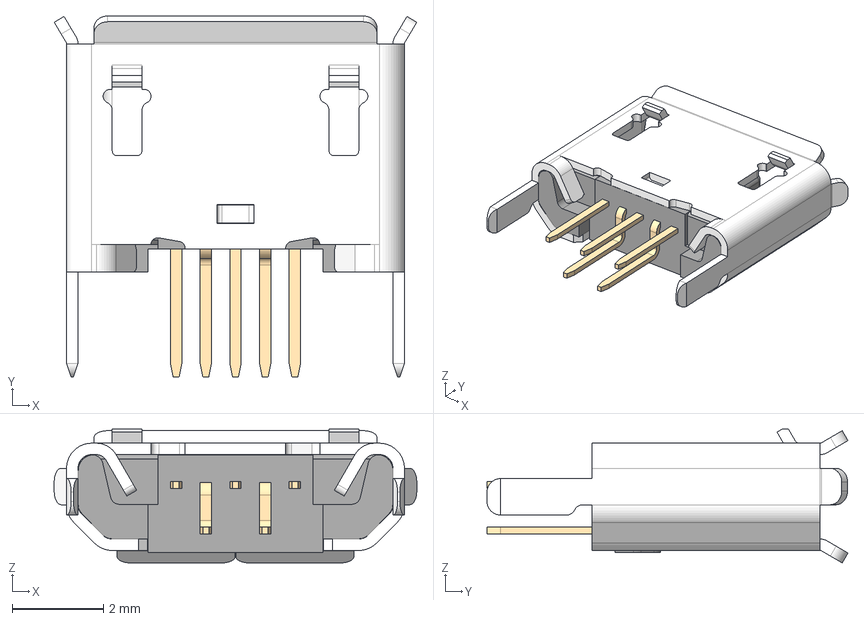
[picture p77: CAD file, 2021-06-11]
5_Eagle_Library/Step-Files/USB3131-30-0230-A_USB_Con.stp
7.94 x 7.91 x 2.93 mm
