lpm97/BA_MagicTrick/5_Eagle_Library/Step-Files/PB_90_TL3360CFxxxQ.stp

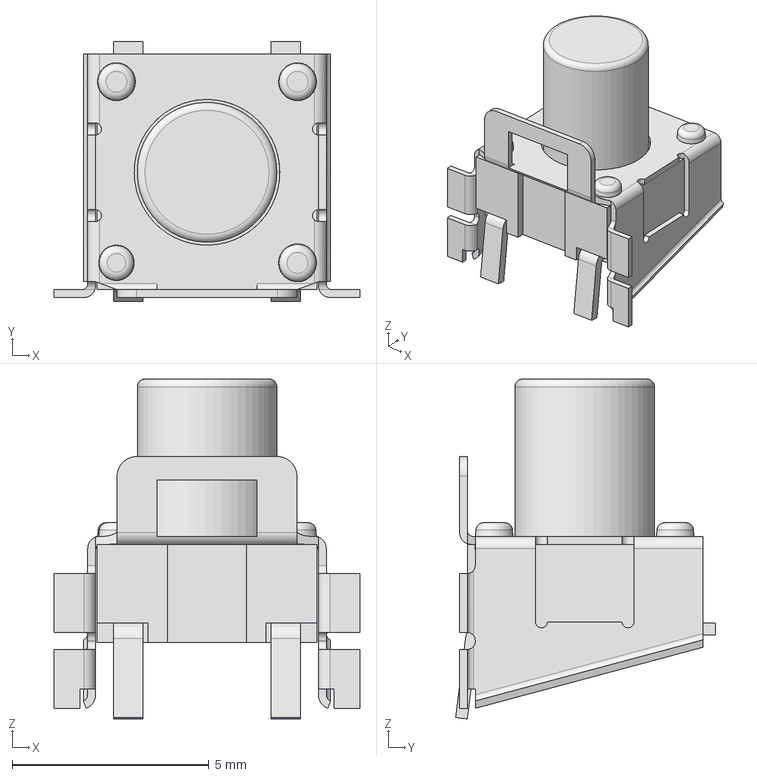
[picture p78: CAD file, 2021-06-11]
5_Eagle_Library/Step-Files/PB_90_TL3360CFxxxQ.stp
7.77 x 6.60 x 8.64 mm
