lpm97/BA_MagicTrick/5_Eagle_Library/Step-Files/b3u-1000p_Button.stp

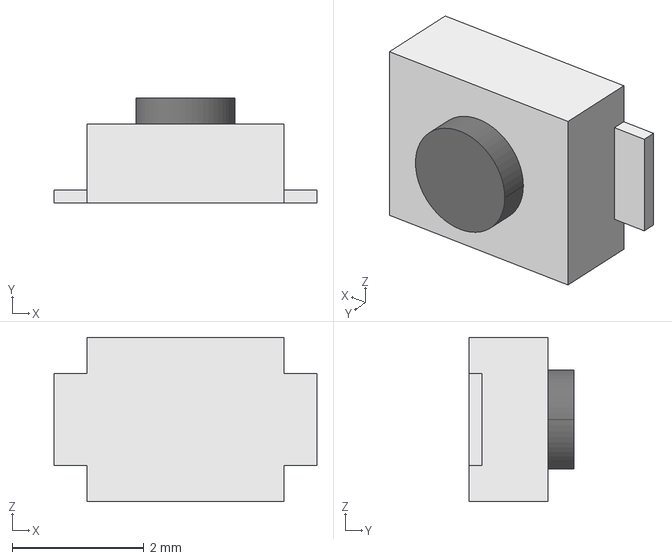
[picture p79: CAD file, 2021-06-11]
5_Eagle_Library/Step-Files/b3u-1000p_Button.stp
4.00 x 1.60 x 2.50 mm
