lpm97/BA_MagicTrick/5_Eagle_Library/Step-Files/CONSMA013.062-G--3DModel-STEP-56544.STEP

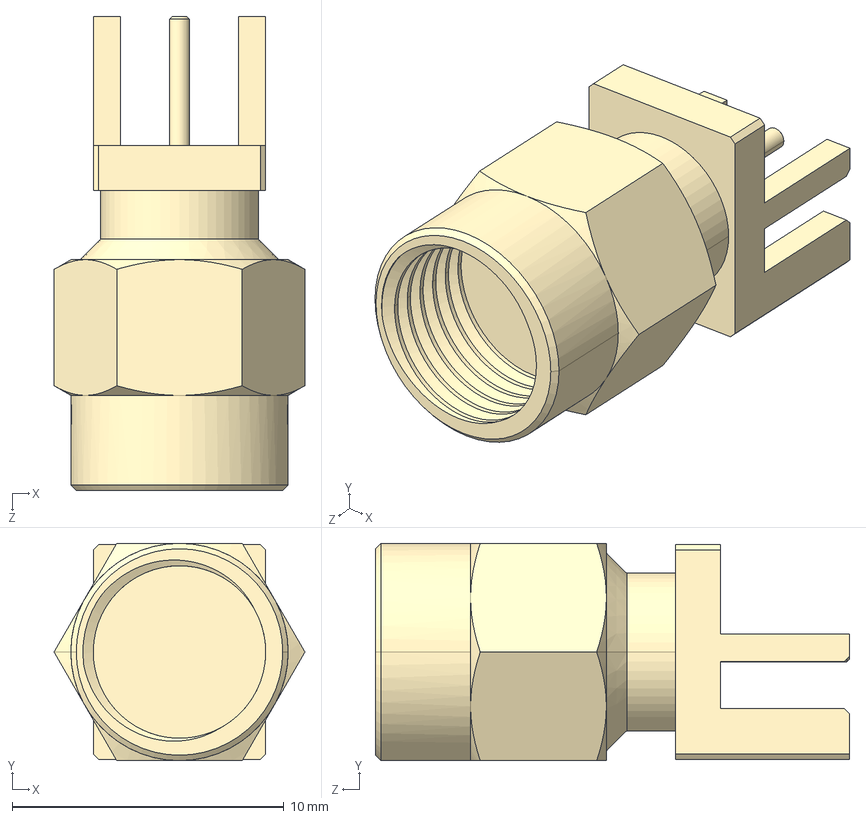
[picture p80: CAD file, 2021-06-11]
5_Eagle_Library/Step-Files/CONSMA013.062-G--3DModel-STEP-56544.STEP
9.24 x 8.00 x 17.5 mm
