lpm97/BA_MagicTrick/(list of files, cad)

Other CAD files:
2_Whiteboard/CAD-Files/BA_WB2_Side_Top v5.stl
2_Whiteboard/CAD-Files/BA_WB2_Side_Left v5.stl
