lpm97/BA_MagicTrick/1_Reader/Eagle-Projekt/Schema_Reader.pdf

A

A

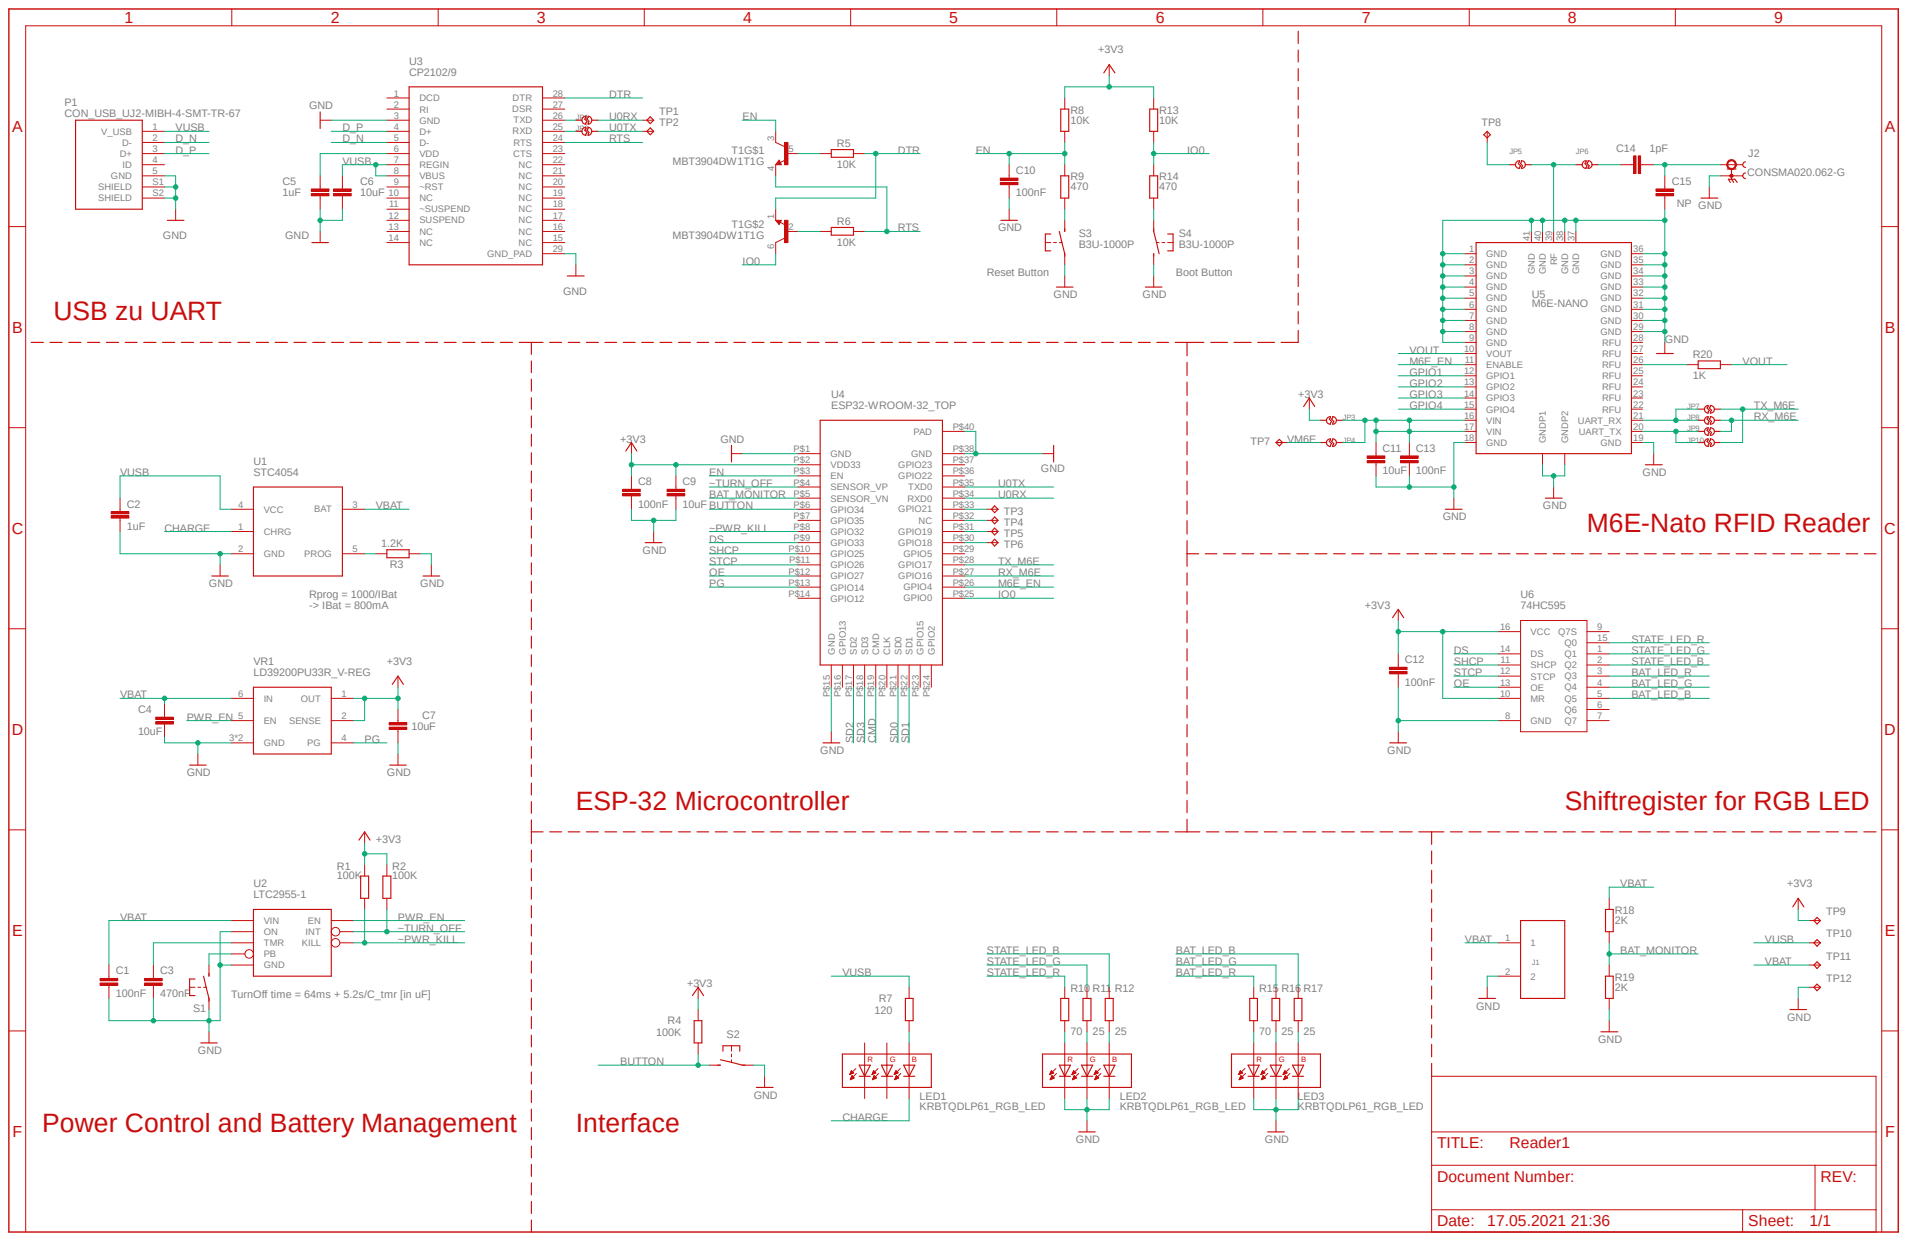
[picture p81: page 1]

Shiftregister for RGB LED

TurnOff time = 64ms + 5.2s/C_tmr [in uF]

Power Control and Battery Management

Document Number: | REV:

Date: 17.05.2021 21:36 | Sheet: 1/1
