lpm97/BA_MagicTrick/2_Whiteboard/Eagle-Projekt/Schema_WB2.pdf

# CS_M1 IO²

# E-Paper Driver

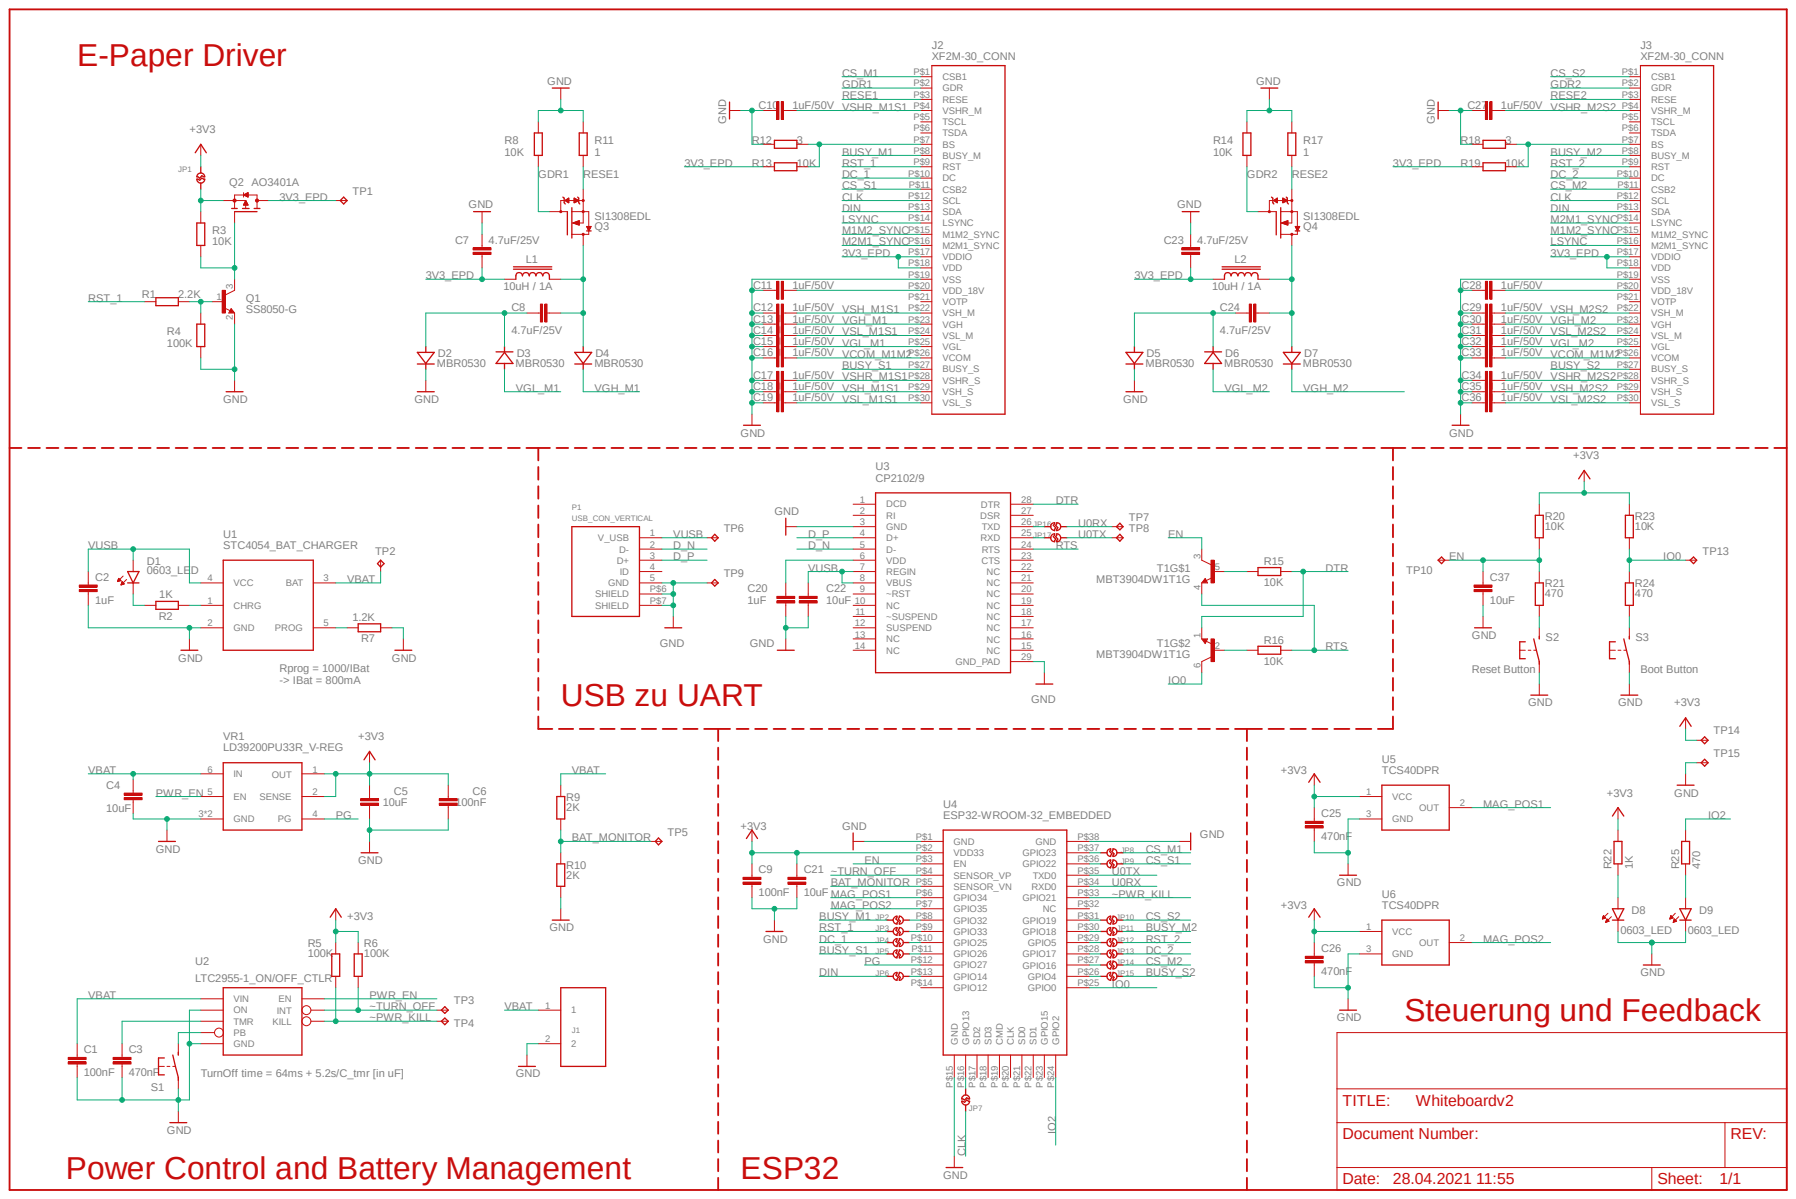
[picture p82: page 1]

TurnOff time = 64ms + 5.2s/C_tmr [in uF]
