lpm97/BA_MagicTrick/3_Puzzlerahmen/Eagle-Projekt/Schema_Puzzle_Controller.pdf

# R8 R⁴ R⁵

# R22 R²⁰ R²¹

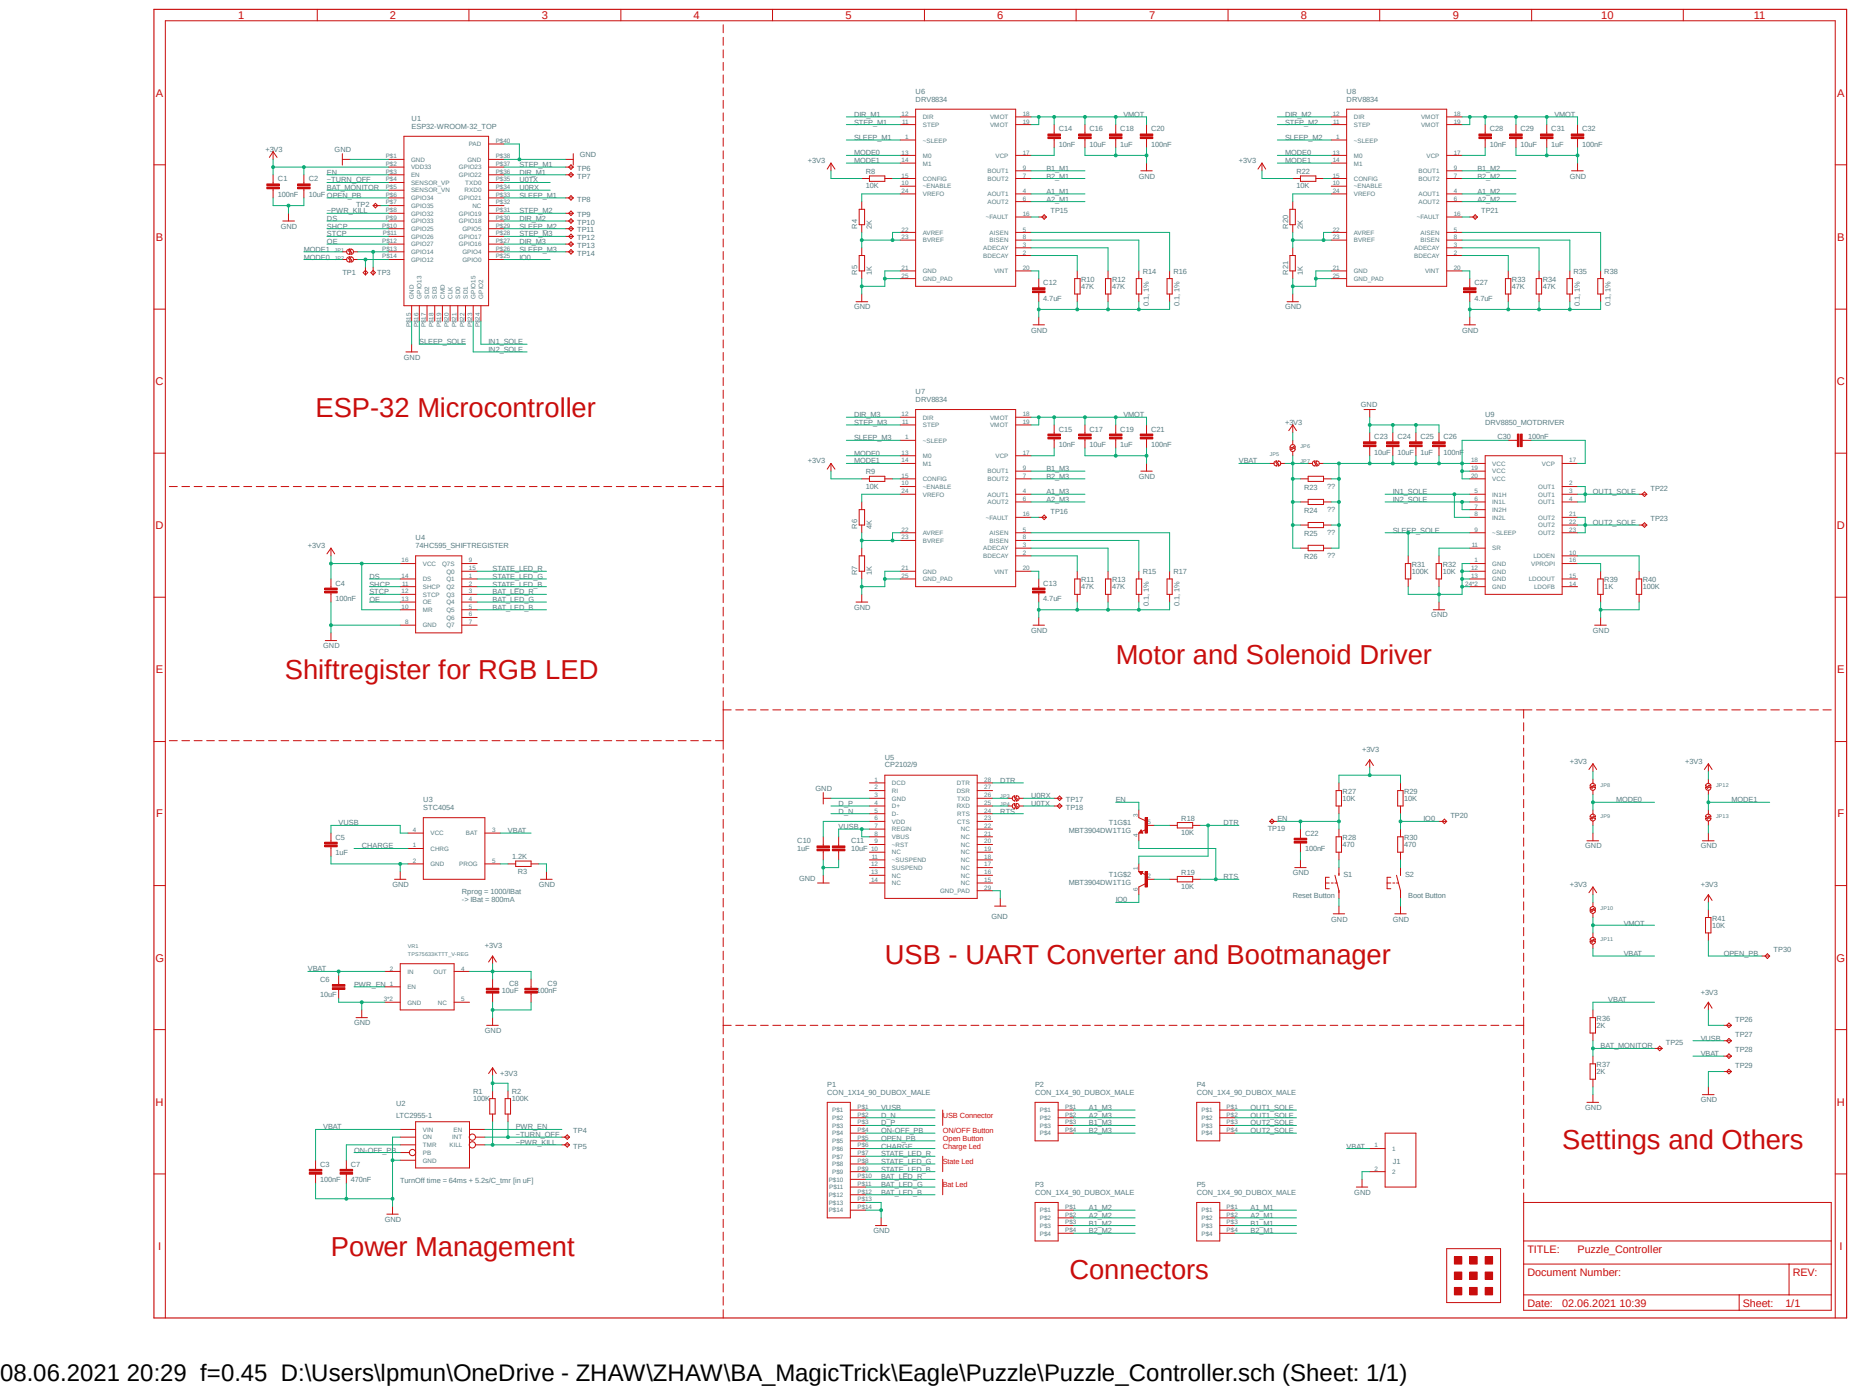
[picture p83: page 1]

Motor and Solenoid Driver

GND
Shiftregister for RGB LED

USB - UART Converter and Bootmanager

TurnOff time = 64ms + 5.2s/C_tmr [in uF]

Document Number: | REV:

Date: 02.06.2021 10:39 | Sheet: 1/1

08.06.2021 20:29 f=0.45 D:\Users\lpmun\OneDrive - ZHAW\ZHAW\BA_MagicTrick\Eagle\Puzzle\Puzzle_Controller.sch (Sheet: 1/1)
