lpm97/BA_MagicTrick/4_Fernbedienung/Eagle-Projekt/Schema_Remote.pdf

# +3V3 KRBTQDLP⁶¹_RGB_LED KRBTQDLP61_RGB_LED

A

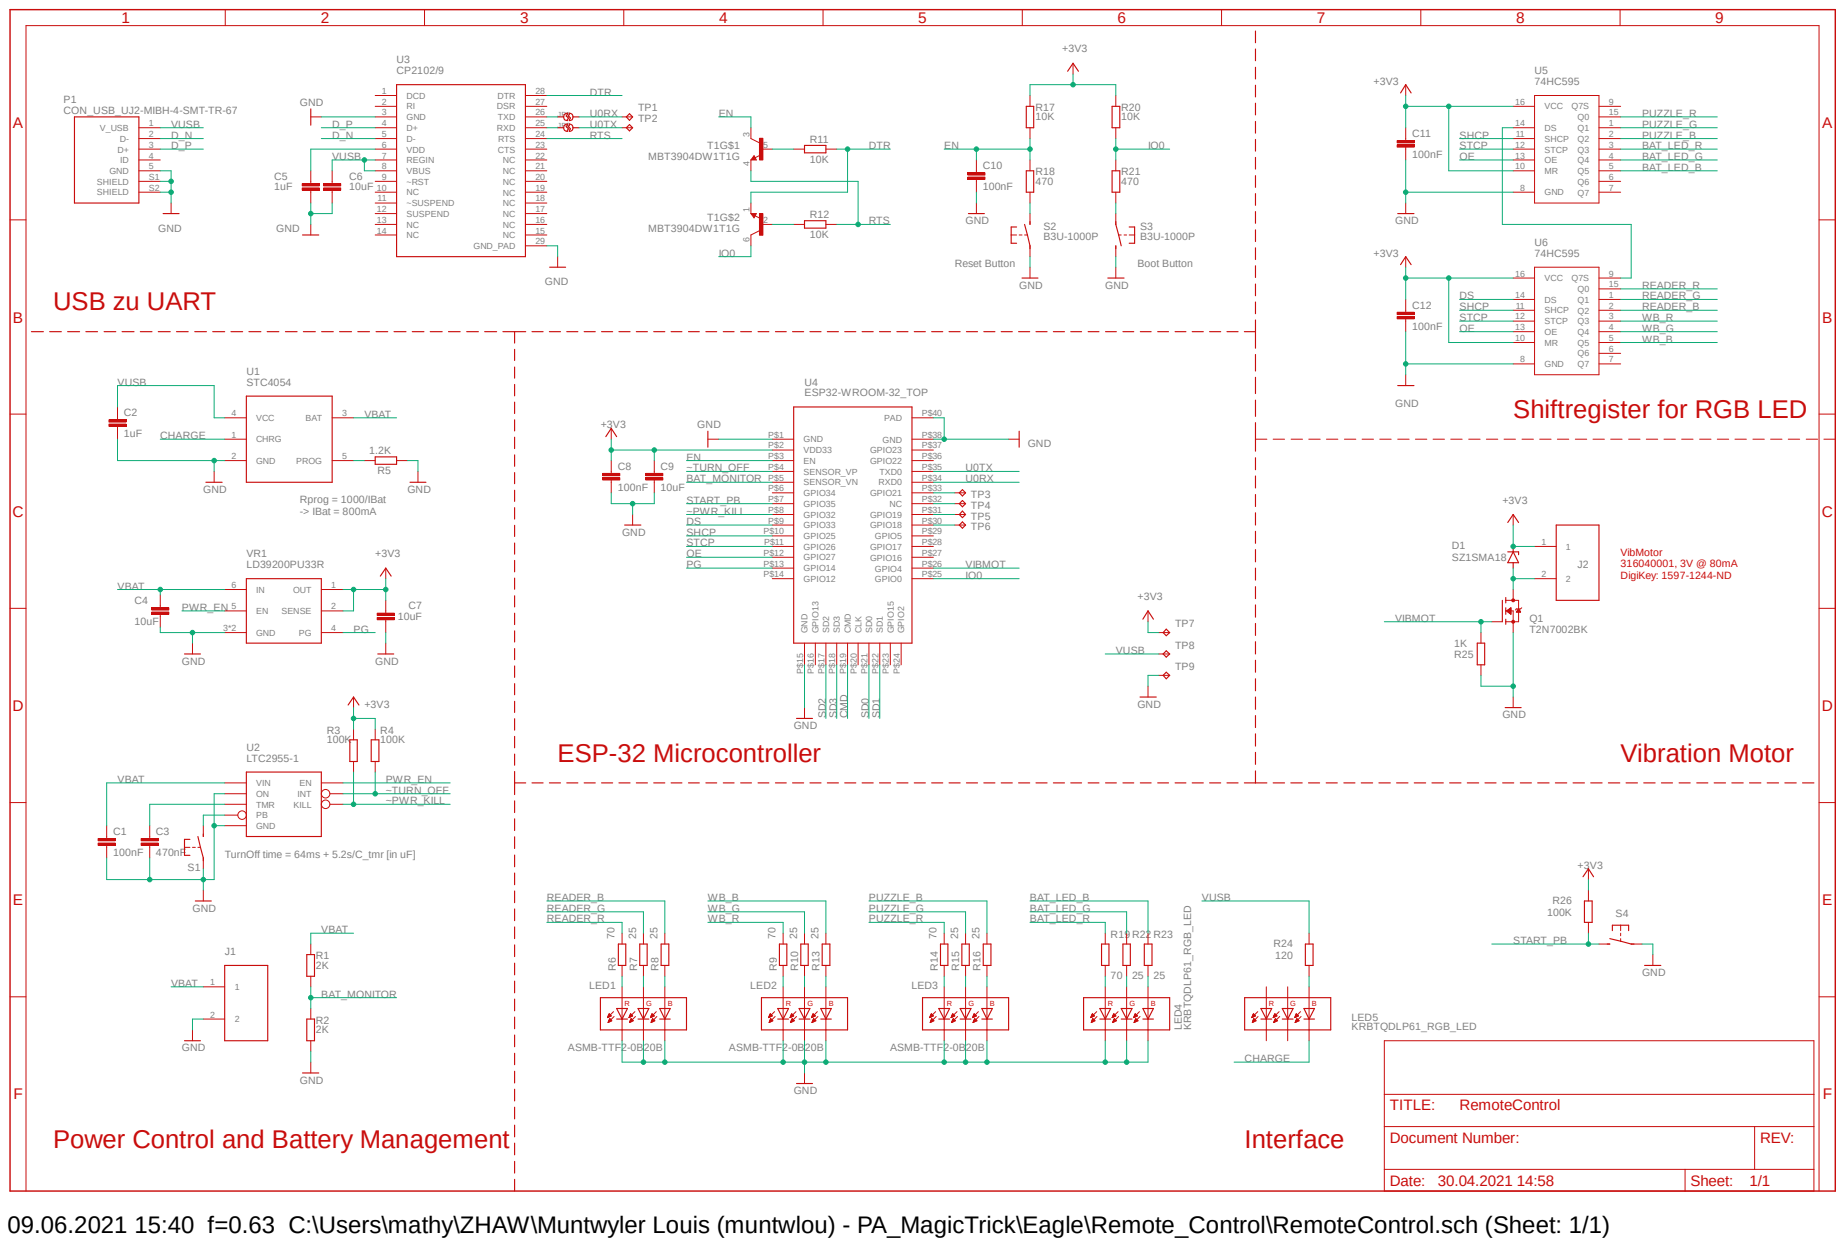
[picture p84: page 1]

Shiftregister for RGB LED

TurnOff time = 64ms + 5.2s/C_tmr [in uF]

Power Control and Battery Management

Date: Sheet: | REV: TITLE: Document Number:

09.06.2021 15:40 f=0.63 C:\Users\mathy\ZHAW\Muntwyler Louis (muntwlou) - PA_MagicTrick\Eagle\Remote_Control\RemoteControl.sch (Sheet: 1/1)
