lpm97/BA_MagicTrick/7_Bestellungen/3_Bestellung_BA_Magic_Ebay_03_20.pdf

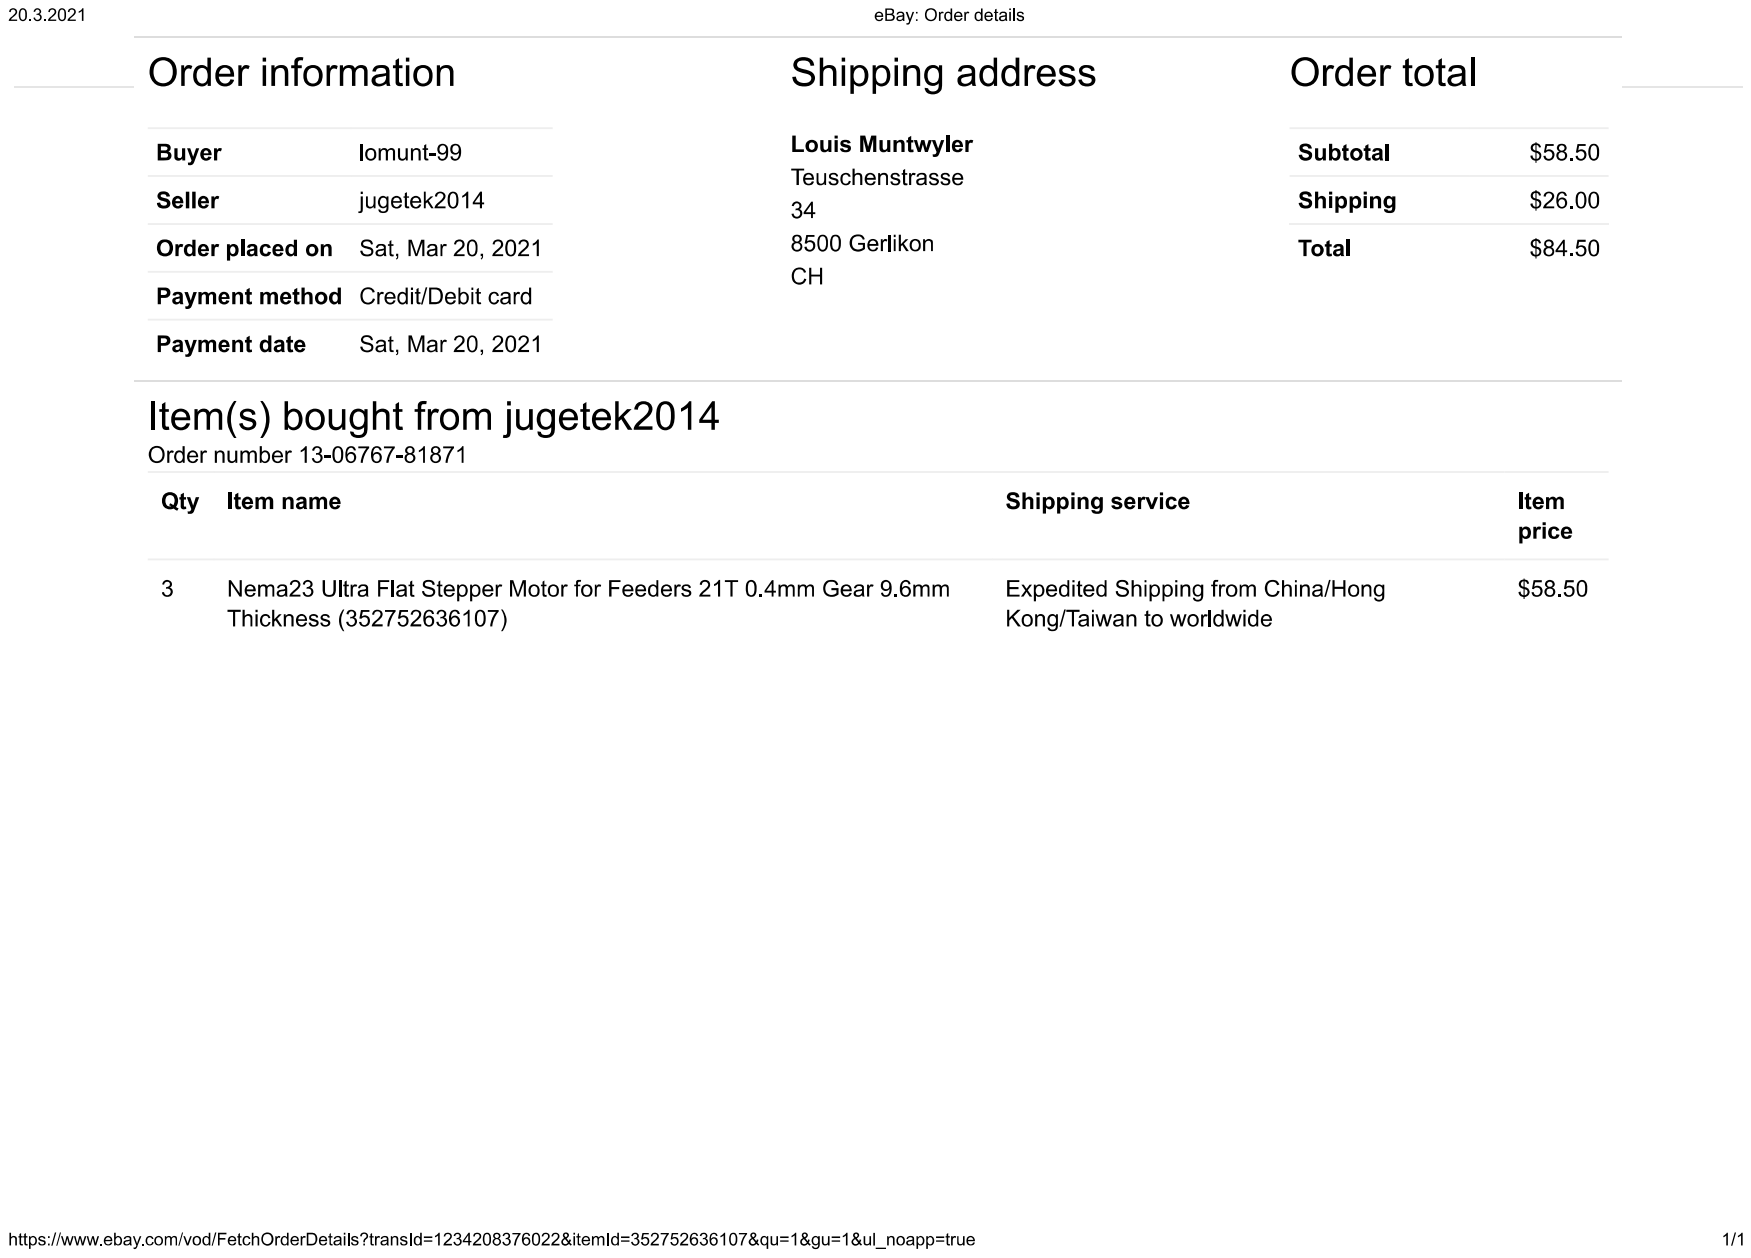
[picture p85: page 1]
