lpm97/BA_MagicTrick/1_Reader/Eagle-Projekt/Bestückung_Reader.pdf

# U4 U⁵

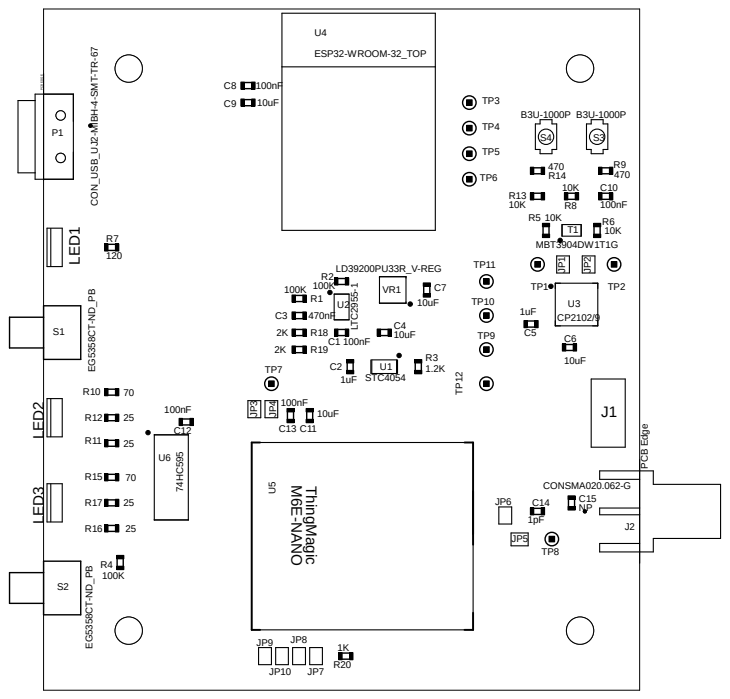
[picture p86: page 1]

100nF CON_USB_UJ2⁻MIBH⁻⁴⁻SMT⁻TR⁻⁶⁷
