lpm97/BA_MagicTrick/3_Puzzlerahmen/Eagle-Projekt/Bestückung_Puzzle_Controller_v1.pdf

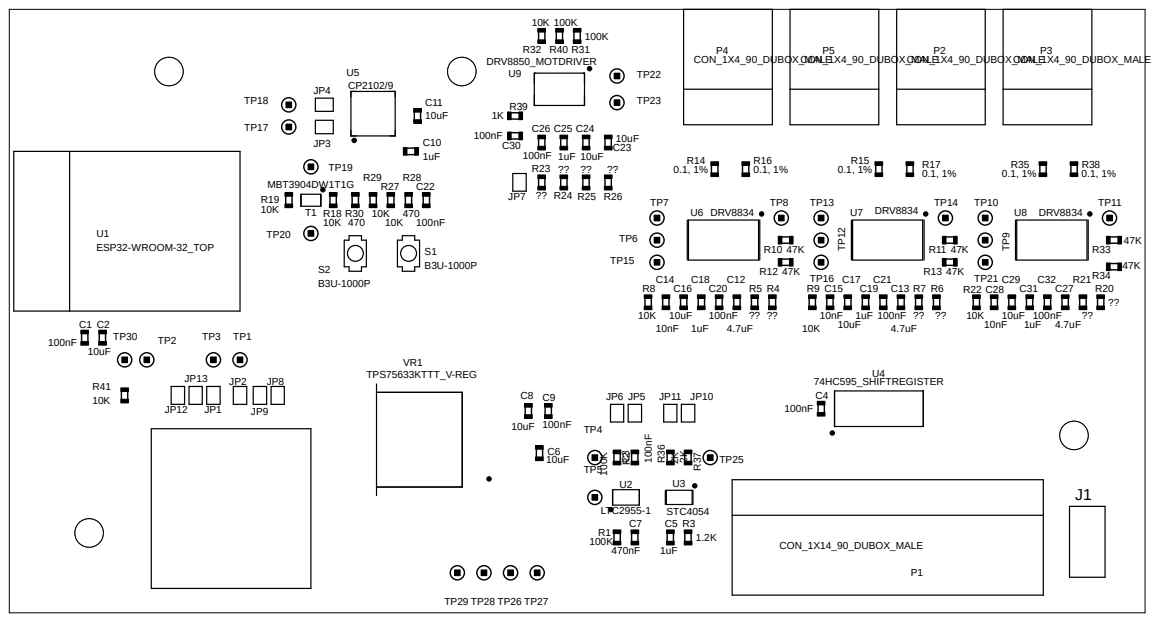
[picture p87: page 1]
