lpm97/BA_MagicTrick/3_Puzzlerahmen/Eagle-Projekt/Schema_Puzzle_Interface.pdf

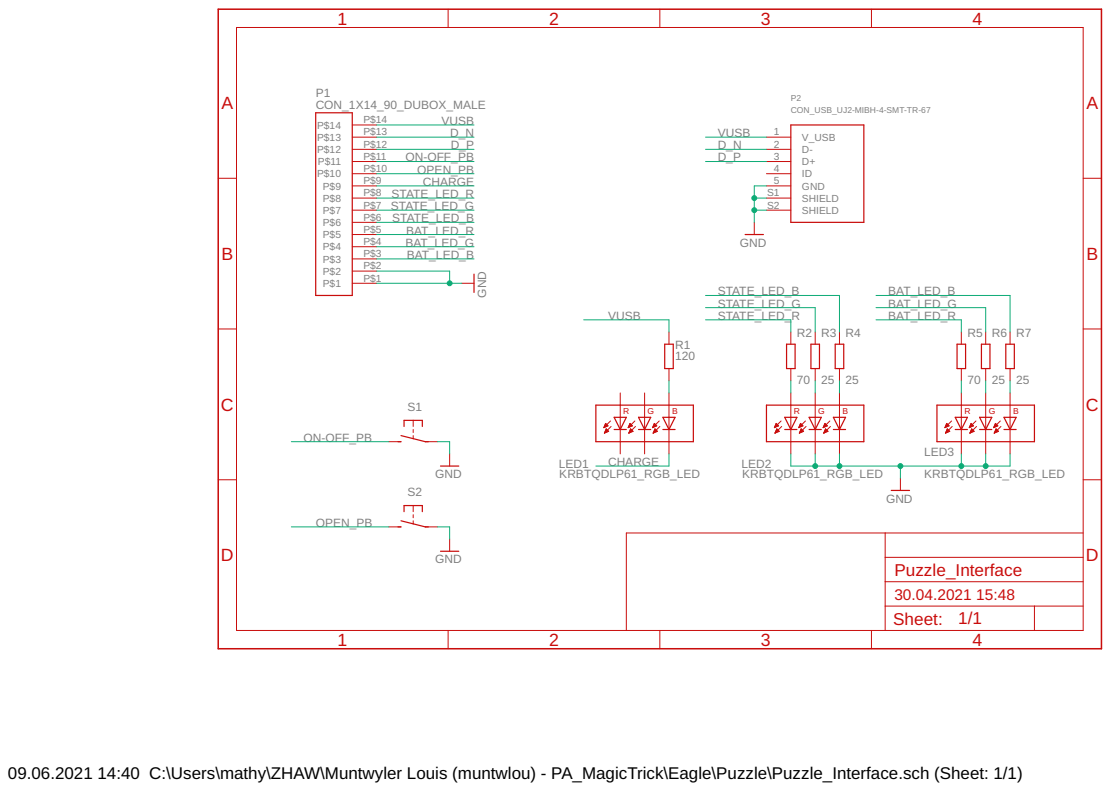
[picture p88: page 1]

09.06.2021 14:40 C:\Users\mathy\ZHAW\Muntwyler Louis (muntwlou) - PA_MagicTrick\Eagle\Puzzle\Puzzle_Interface.sch (Sheet: 1/1)
