lpm97/BA_MagicTrick/4_Fernbedienung/Eagle-Projekt/Bestückung_Remote.pdf

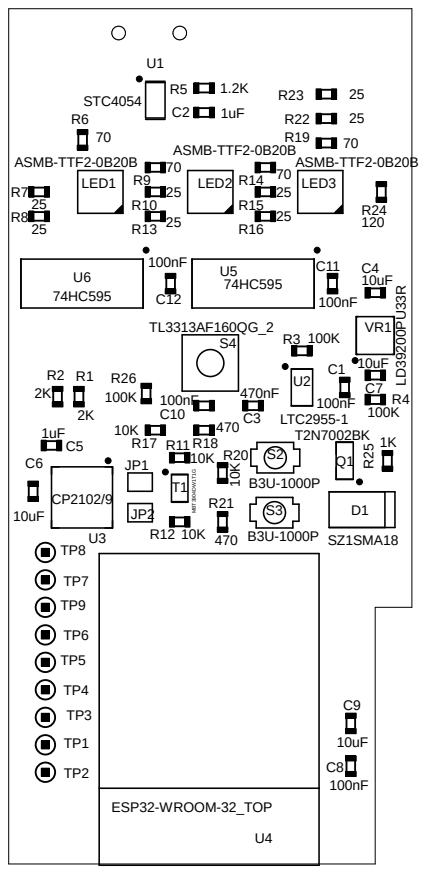
[picture p89: page 1]
