lpm97/BA_MagicTrick/3_Puzzlerahmen/Eagle-Projekt/Puzzle_Interface.brd

## EAGLE design 3_Puzzlerahmen/Eagle-Projekt/Puzzle_Interface.brd (2021-06-11)

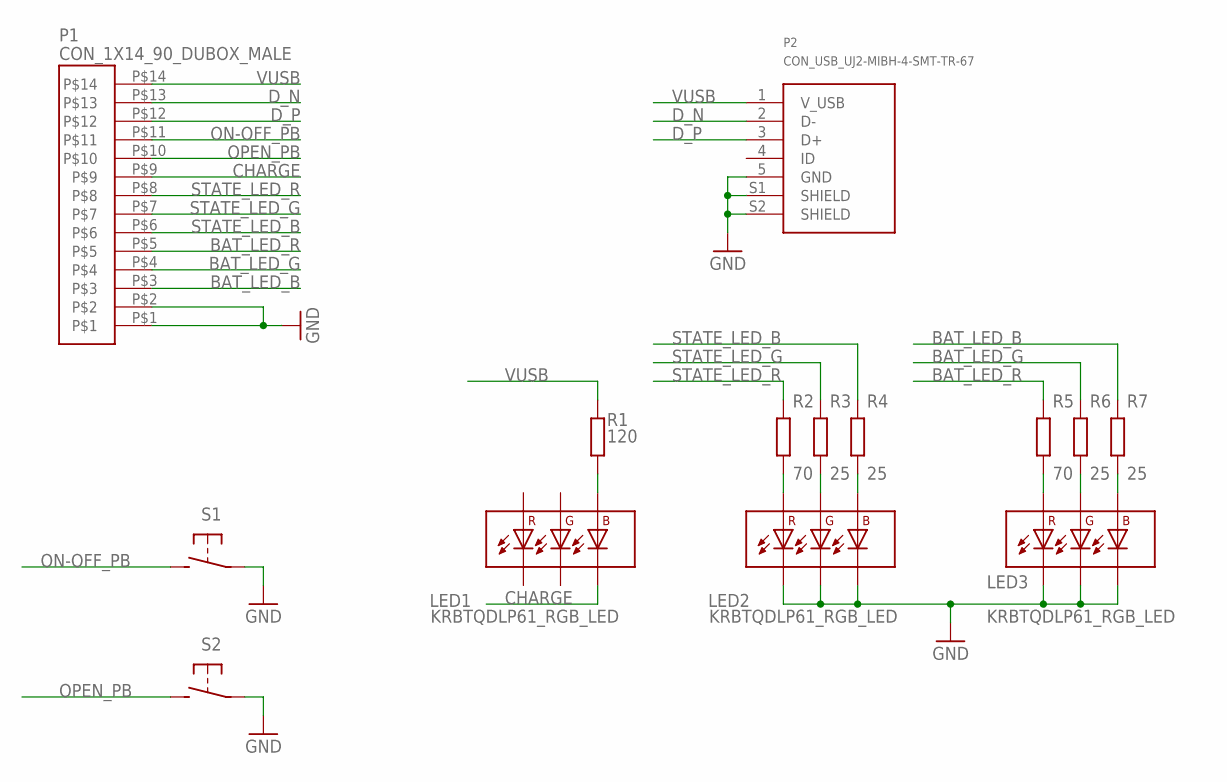
[picture p90: schematic Puzzle_Interface.sch]

Parts:
LED1, LED2, LED3: KRBTQDLP61_RGB_LED
P1: CON_1X14_90_DUBOX_MALE
P2: CON_USB_UJ2-MIBH-4-SMT-TR-67
R1: 120; 0603
R2, R5: 70; 0603
R3, R4, R6, R7: 25; 0603
S1, S2: EG5358CT-ND_PB

Connections:
BAT_LED_B: P1.P$3, R7.2
BAT_LED_G: P1.P$4, R6.2
BAT_LED_R: P1.P$5, R5.2
CHARGE: LED1.P$4 (BC), P1.P$9
D_N: P1.P$13, P2.2 (D-)
D_P: P1.P$12, P2.3 (D+)
GND: LED2.P$3 (GC), LED2.P$4 (BC), LED2.P$6 (RC), LED3.P$3 (GC), LED3.P$4 (BC), LED3.P$6 (RC), P1.P$1, P1.P$2, P2.5 (GND), P2.S1 (SHIELD), P2.S2 (SHIELD), S1.1, S1.S1, S1.S2, S2.1, S2.S1, S2.S2
unnamed: LED1.P$2 (BA), R1.1
unnamed: LED2.P$5 (RA), R2.1
unnamed: LED2.P$1 (GA), R3.1
unnamed: LED2.P$2 (BA), R4.1
unnamed: LED3.P$5 (RA), R5.1
unnamed: LED3.P$1 (GA), R6.1
unnamed: LED3.P$2 (BA), R7.1
ON-OFF_PB: P1.P$11, S1.2 (S)
OPEN_PB: P1.P$10, S2.2 (S)
STATE_LED_B: P1.P$6, R4.2
STATE_LED_G: P1.P$7, R3.2
STATE_LED_R: P1.P$8, R2.2
VUSB: P1.P$14, P2.1 (V_USB), R1.2

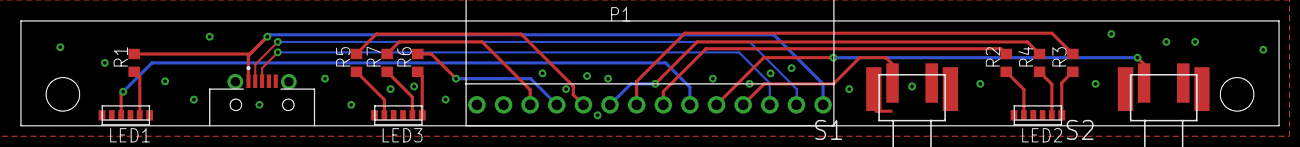
[picture p91: board Puzzle_Interface.brd from above]

Board: 2 copper layers, 120.0 x 10.0 mm, 14 parts (0 on the bottom side), 20 nets.
