lpm97/BA_MagicTrick/1_Reader/Eagle-Projekt/Reader1.brd

## EAGLE design 1_Reader/Eagle-Projekt/Reader1.brd (2021-06-11)

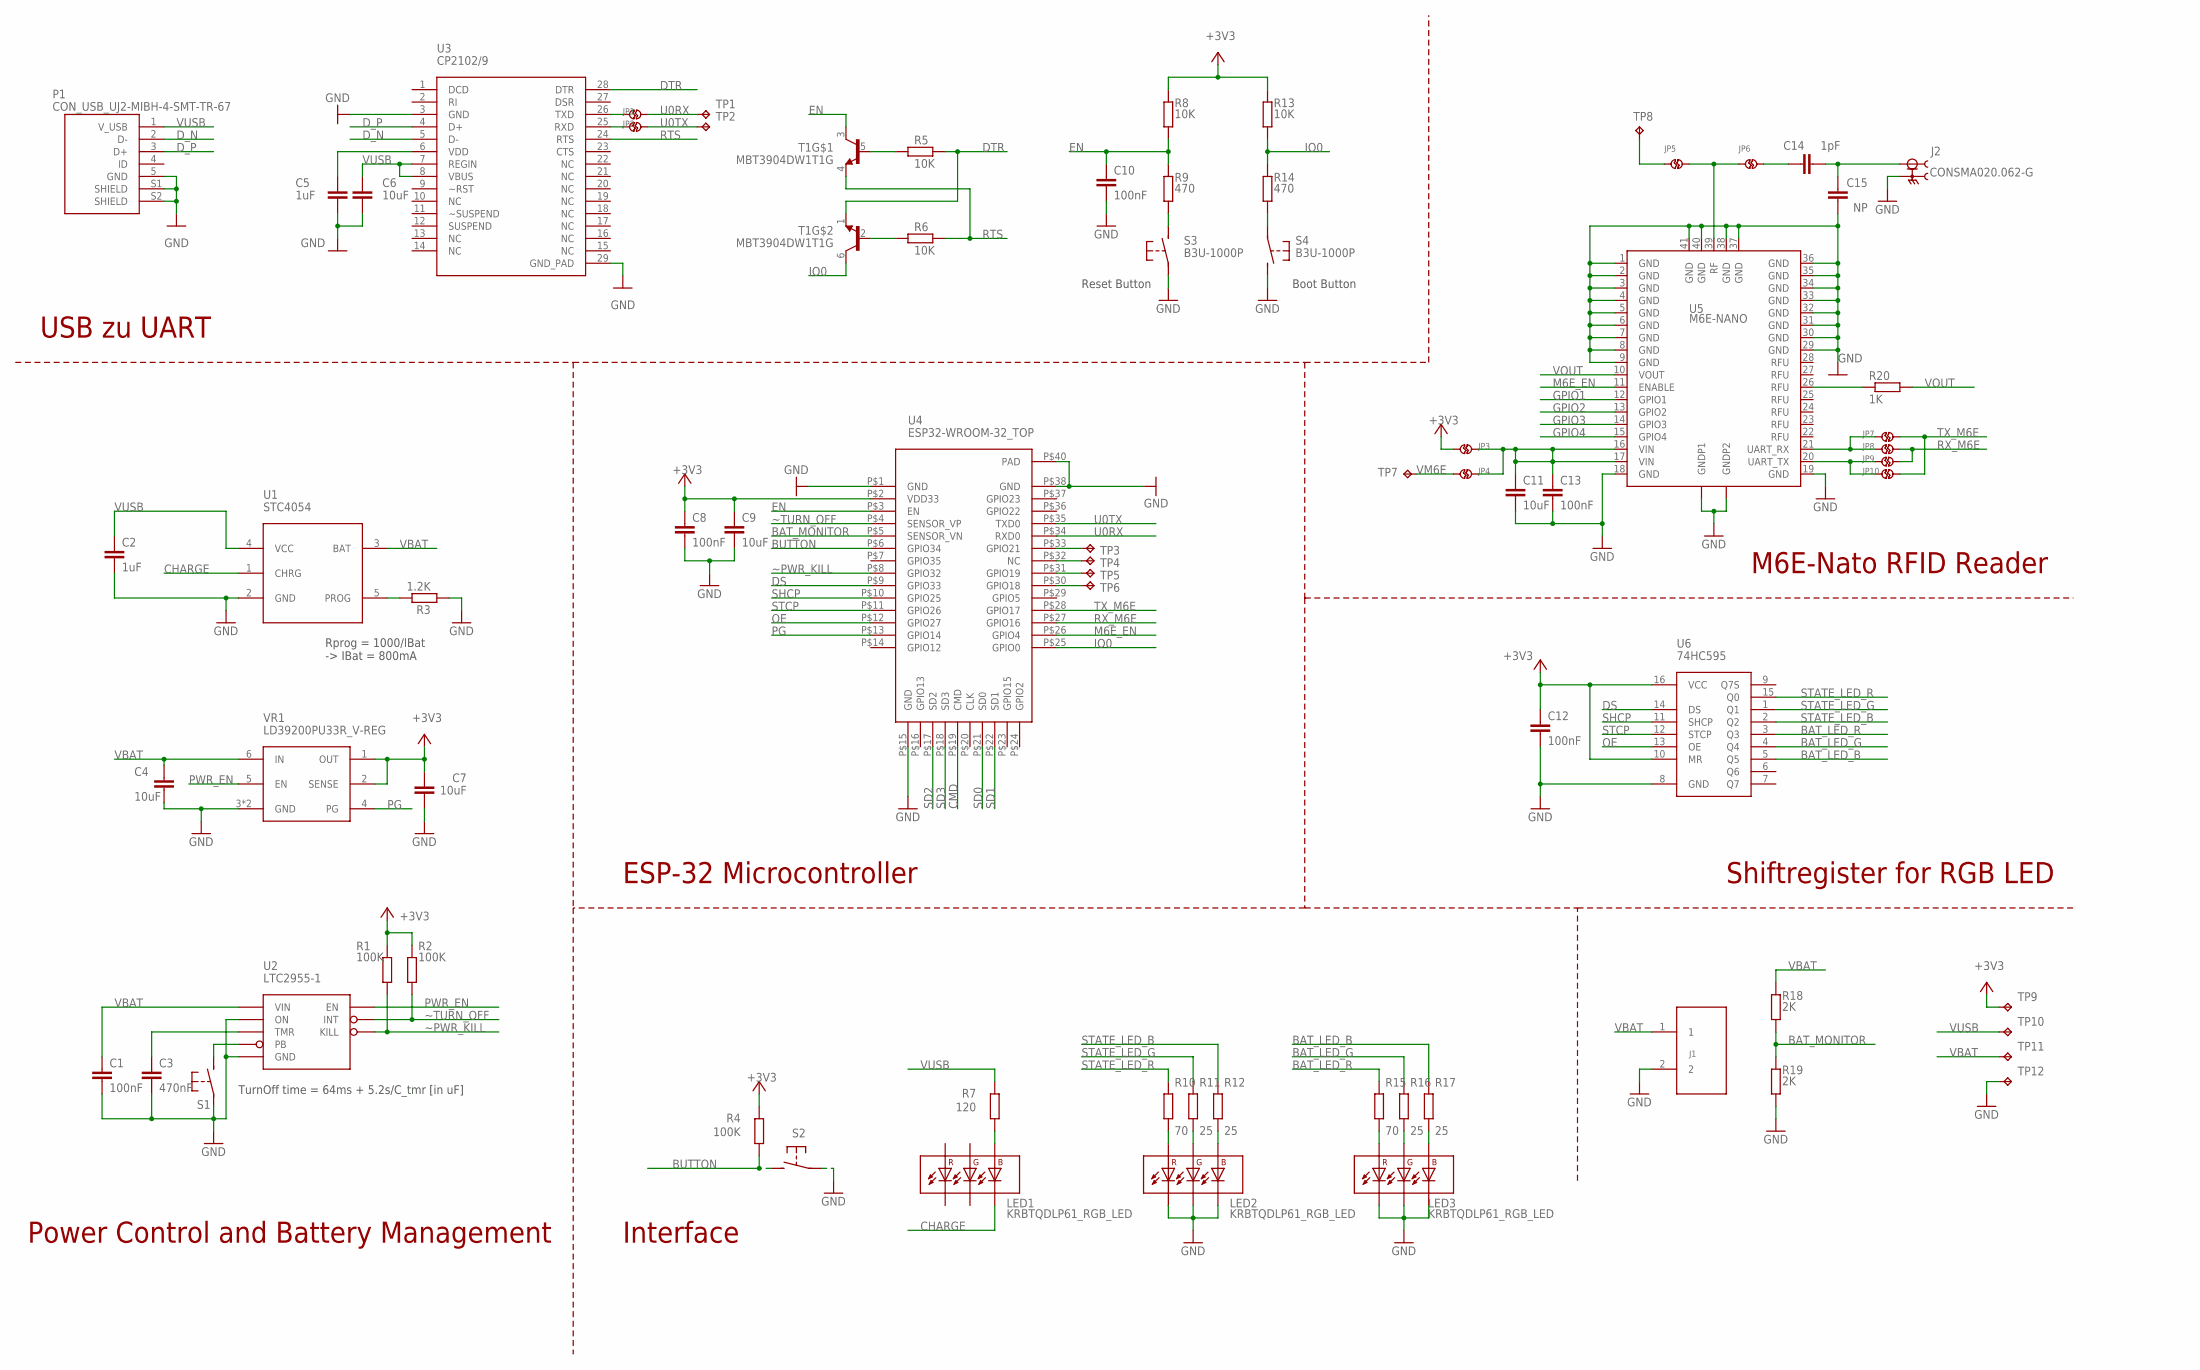
[picture p92: schematic Reader1.sch]

Parts:
C1, C8, C10, C12, C13: 100nF; 0603
C2, C5: 1uF; 0603
C3: 470nF; 0603
C4, C6, C7, C9, C11: 10uF; 0603
C14: 1pF; 0603
C15: NP; 0603
J1: CON_2
J2: CONSMA020.062-G; LINX_CONSMA020.062-G
JP1, JP2, JP3, JP4, JP5, JP6, JP7, JP8, JP9, JP10: SOLDER_JUMPER
LED1, LED2, LED3: KRBTQDLP61_RGB_LED
P1: CON_USB_UJ2-MIBH-4-SMT-TR-67
R1, R2, R4: 100K; 0603
R3: 1.2K; 0603
R5, R6, R8, R13: 10K; 0603
R7: 120; 0603
R9, R14: 470; 0603
R10, R15: 70; 0603
R11, R12, R16, R17: 25; 0603
R18, R19: 2K; 0603
R20: 1K; 0603
S1, S2: EG5358CT-ND_PB
S3, S4: B3U-1000P
T1: MBT3904DW1T1G; SOT23-6
TP1, TP2, TP3, TP4, TP5, TP6, TP7, TP8, TP9, TP10, TP11, TP12: TP; TEST_PAD
U1: STC4054; TSOT23-5L
U2: LTC2955-1; SOT23-8
U3: CP2102/9; QFN-28
U4: ESP32-WROOM-32_TOP
U5: M6E-NANO
U6: 74HC595; SOIC-16
VR1: LD39200PU33R_V-REG; DFN-6

Connections:
+3V3: C7.2, C8.1, C9.1, C12.1, JP3.P$1, R1.1, R2.1, R4.2, R8.2, R13.2, TP9.TP, U4.P$2 (VDD33), U6.10 (MR), U6.16 (VCC), VR1.1 (OUT), VR1.2 (SENSE)
BAT_LED_B: R17.2, U6.5 (Q5)
BAT_LED_G: R16.2, U6.4 (Q4)
BAT_LED_R: R15.2, U6.3 (Q3)
BAT_MONITOR: R18.2, R19.1, U4.P$5 (SENSOR_VN)
BUTTON: R4.1, S2.2 (S), U4.P$6 (GPIO34)
CHARGE: LED1.P$4 (BC), U1.1 (CHRG)
CMD: U4.P$19 (CMD)
DS: U4.P$9 (GPIO33), U6.14 (DS)
DTR: R5.1, T1.1 (E), U3.28 (DTR)
D_N: P1.2 (D-), U3.5 (D-)
D_P: P1.3 (D+), U3.4 (D+)
EN: C10.1, R8.1, R9.2, T1.3 (C), U4.P$3 (EN)
GND: C1.2, C2.2, C3.2, C4.2, C5.2, C6.2, C7.1, C8.2, C9.2, C10.2, C11.2, C12.2, C13.2, C15.1, J1.2, J2.S1 (2), J2.S2 (2), J2.S3 (2), J2.S4 (2), LED2.P$3 (GC), LED2.P$4 (BC), LED2.P$6 (RC), LED3.P$3 (GC), LED3.P$4 (BC), LED3.P$6 (RC), P1.5 (GND), P1.S1 (SHIELD), P1.S2 (SHIELD), R3.1, R19.2, S1.1, S1.S1, S1.S2, S2.1, S2.S1, S2.S2, S3.P$1, S4.P$2 (S), TP12.TP, U1.2 (GND), U2.1 (ON), U2.4 (GND), U3.3 (GND), U3.29 (GND_PAD), U4.P$1 (GND), U4.P$15 (GND), U4.P$38 (GND), U4.P$40 (PAD), U5.1 (GND), U5.2 (GND), U5.3 (GND), U5.4 (GND), U5.5 (GND), U5.6 (GND), U5.7 (GND), U5.8 (GND), U5.9 (GND), U5.18 (GND), U5.19 (GND), U5.29 (GND), U5.30 (GND), U5.31 (GND), U5.32 (GND), U5.33 (GND), U5.34 (GND), U5.35 (GND), U5.36 (GND), U5.37 (GND), U5.38 (GND), U5.40 (GND), U5.41 (GND), U5.GND_PAD1 (GNDP1), U5.GND_PAD2 (GNDP2), U6.8 (GND), VR1.3 (GND), VR1.7 (GND)
GPIO1: U5.12 (GPIO1)
GPIO2: U5.13 (GPIO2)
GPIO3: U5.14 (GPIO3)
GPIO4: U5.15 (GPIO4)
IO0: R13.1, R14.2, T1.6 (C), U4.P$25 (GPIO0)
M6E_EN: U4.P$26 (GPIO4), U5.11 (ENABLE)
unnamed: R20.1, U5.26 (RFU)
unnamed: JP5.P$2, JP6.P$1, U5.39 (RF)
unnamed: C14.1, JP6.P$2
unnamed: C14.2, C15.2, J2.1
unnamed: JP5.P$1, TP8.TP
unnamed: R5.2, T1.5 (B)
unnamed: R6.2, T1.2 (B)
unnamed: C5.1, U3.6 (VDD)
unnamed: LED3.P$5 (RA), R15.1
unnamed: R9.1, S3.P$2 (S)
unnamed: R14.1, S4.P$1
unnamed: C11.1, C13.1, JP3.P$2, JP4.P$2, U5.16 (VIN), U5.17 (VIN)
unnamed: LED2.P$5 (RA), R10.1
unnamed: LED1.P$2 (BA), R7.1
unnamed: LED2.P$1 (GA), R11.1
unnamed: LED2.P$2 (BA), R12.1
unnamed: LED3.P$1 (GA), R16.1
unnamed: R3.2, U1.5 (PROG)
unnamed: JP1.P$1, U3.26 (TXD)
unnamed: LED3.P$2 (BA), R17.1
unnamed: JP2.P$1, U3.25 (RXD)
unnamed: S1.2 (S), U2.5 (PB)
unnamed: TP5.TP, U4.P$31 (GPIO19)
unnamed: C3.1, U2.3 (TMR)
unnamed: TP6.TP, U4.P$30 (GPIO18)
unnamed: TP3.TP, U4.P$33 (GPIO21)
unnamed: TP4.TP, U4.P$32 (NC)
OE: U4.P$12 (GPIO27), U6.13 (OE)
PG: U4.P$13 (GPIO14), VR1.4 (PG)
PWR_EN: U2.7 (EN), VR1.5 (EN)
RTS: R6.1, T1.4 (E), U3.24 (RTS)
RXI: JP7.P$1, JP8.P$1, U5.21 (UART_RX)
RX_M6E: JP8.P$2, JP9.P$2, U4.P$27 (GPIO16)
SD0: U4.P$21 (SD0)
SD1: U4.P$22 (SD1)
SD2: U4.P$17 (SD2)
SD3: U4.P$18 (SD3)
SHCP: U4.P$10 (GPIO25), U6.11 (SHCP)
STATE_LED_B: R12.2, U6.2 (Q2)
STATE_LED_G: R11.2, U6.1 (Q1)
STATE_LED_R: R10.2, U6.15 (Q0)
STCP: U4.P$11 (GPIO26), U6.12 (STCP)
TXO: JP9.P$1, JP10.P$1, U5.20 (UART_TX)
TX_M6E: JP7.P$2, JP10.P$2, U4.P$28 (GPIO17)
U0RX: JP1.P$2, TP1.TP, U4.P$34 (RXD0)
U0TX: JP2.P$2, TP2.TP, U4.P$35 (TXD0)
VBAT: C1.1, C4.1, J1.1, R18.1, TP11.TP, U1.3 (BAT), U2.6 (VIN), VR1.6 (IN)
VM6E: JP4.P$1, TP7.TP
VOUT: R20.2, U5.10 (VOUT)
VUSB: C2.1, C6.1, P1.1 (V_USB), R7.2, TP10.TP, U1.4 (VCC), U3.7 (REGIN), U3.8 (VBUS)
~PWR_KILL: R1.2, U2.2 (KILL), U4.P$8 (GPIO32)
~TURN_OFF: R2.2, U2.8 (INT), U4.P$4 (SENSOR_VP)

Notes on the sheet:
Rprog = 1000/IBat -> IBat = 800mA
TurnOff time = 64ms + 5.2s/C_tmr [in uF]
Reset Button
Boot Button
Power Control and Battery Management
ESP-32 Microcontroller
USB zu UART
Interface
Shiftregister for RGB LED
M6E-Nato RFID Reader

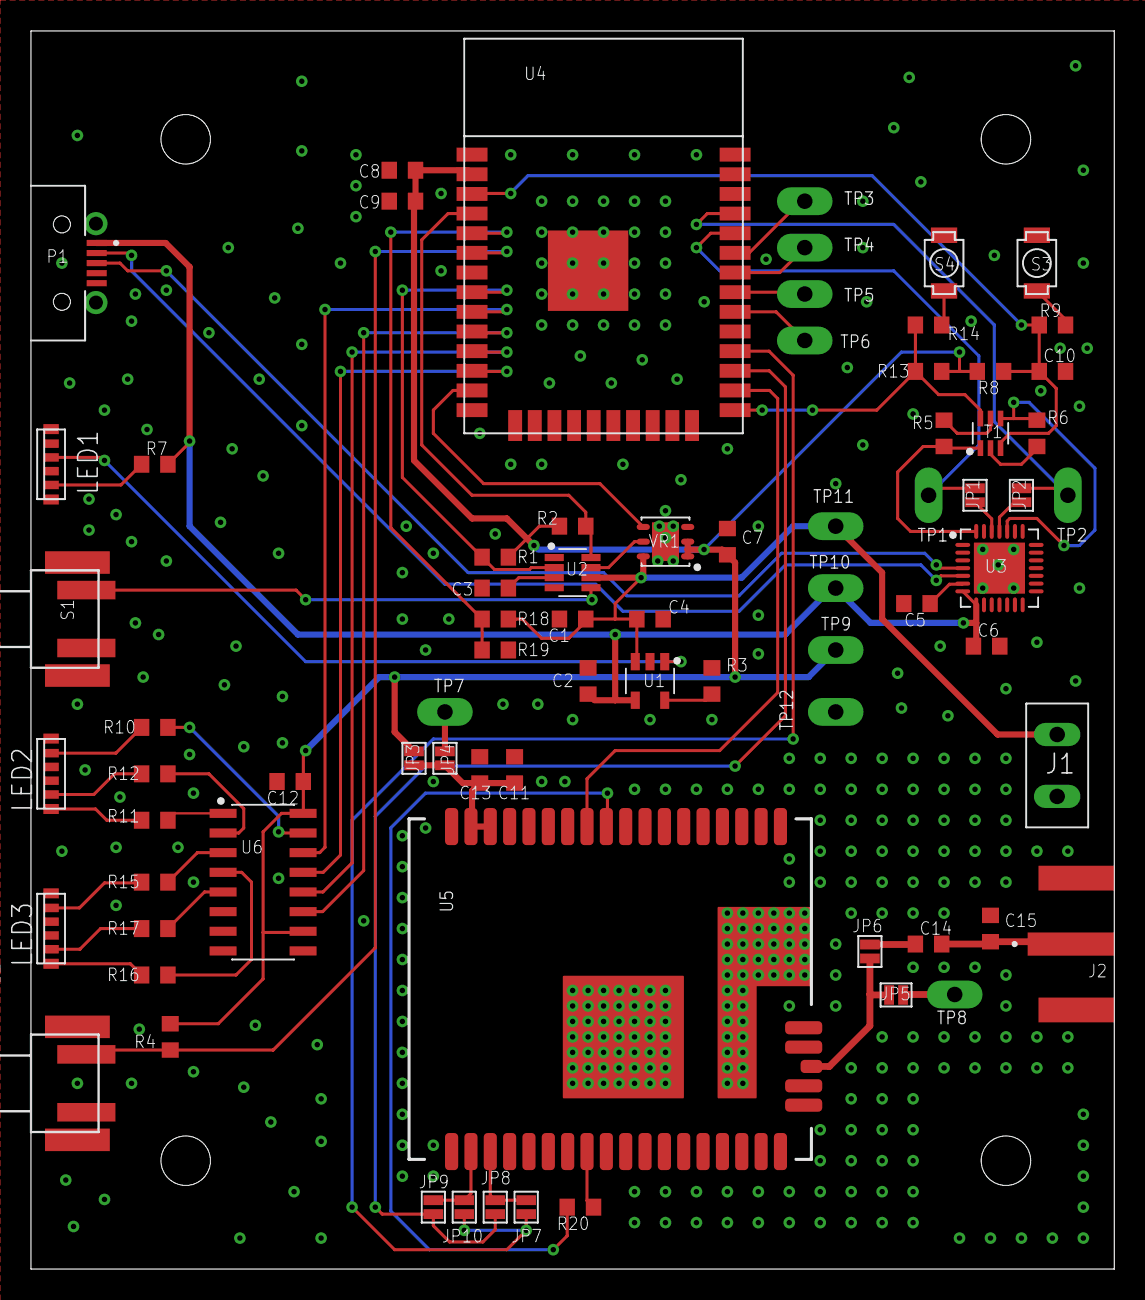
[picture p93: board Reader1.brd from above]

Board: 2 copper layers, 70.0 x 80.0 mm, 75 parts (0 on the bottom side), 63 nets.
