lpm97/BA_MagicTrick/3_Puzzlerahmen/Eagle-Projekt/Puzzle_Controller.brd

## EAGLE design 3_Puzzlerahmen/Eagle-Projekt/Puzzle_Controller.brd (2021-06-11)

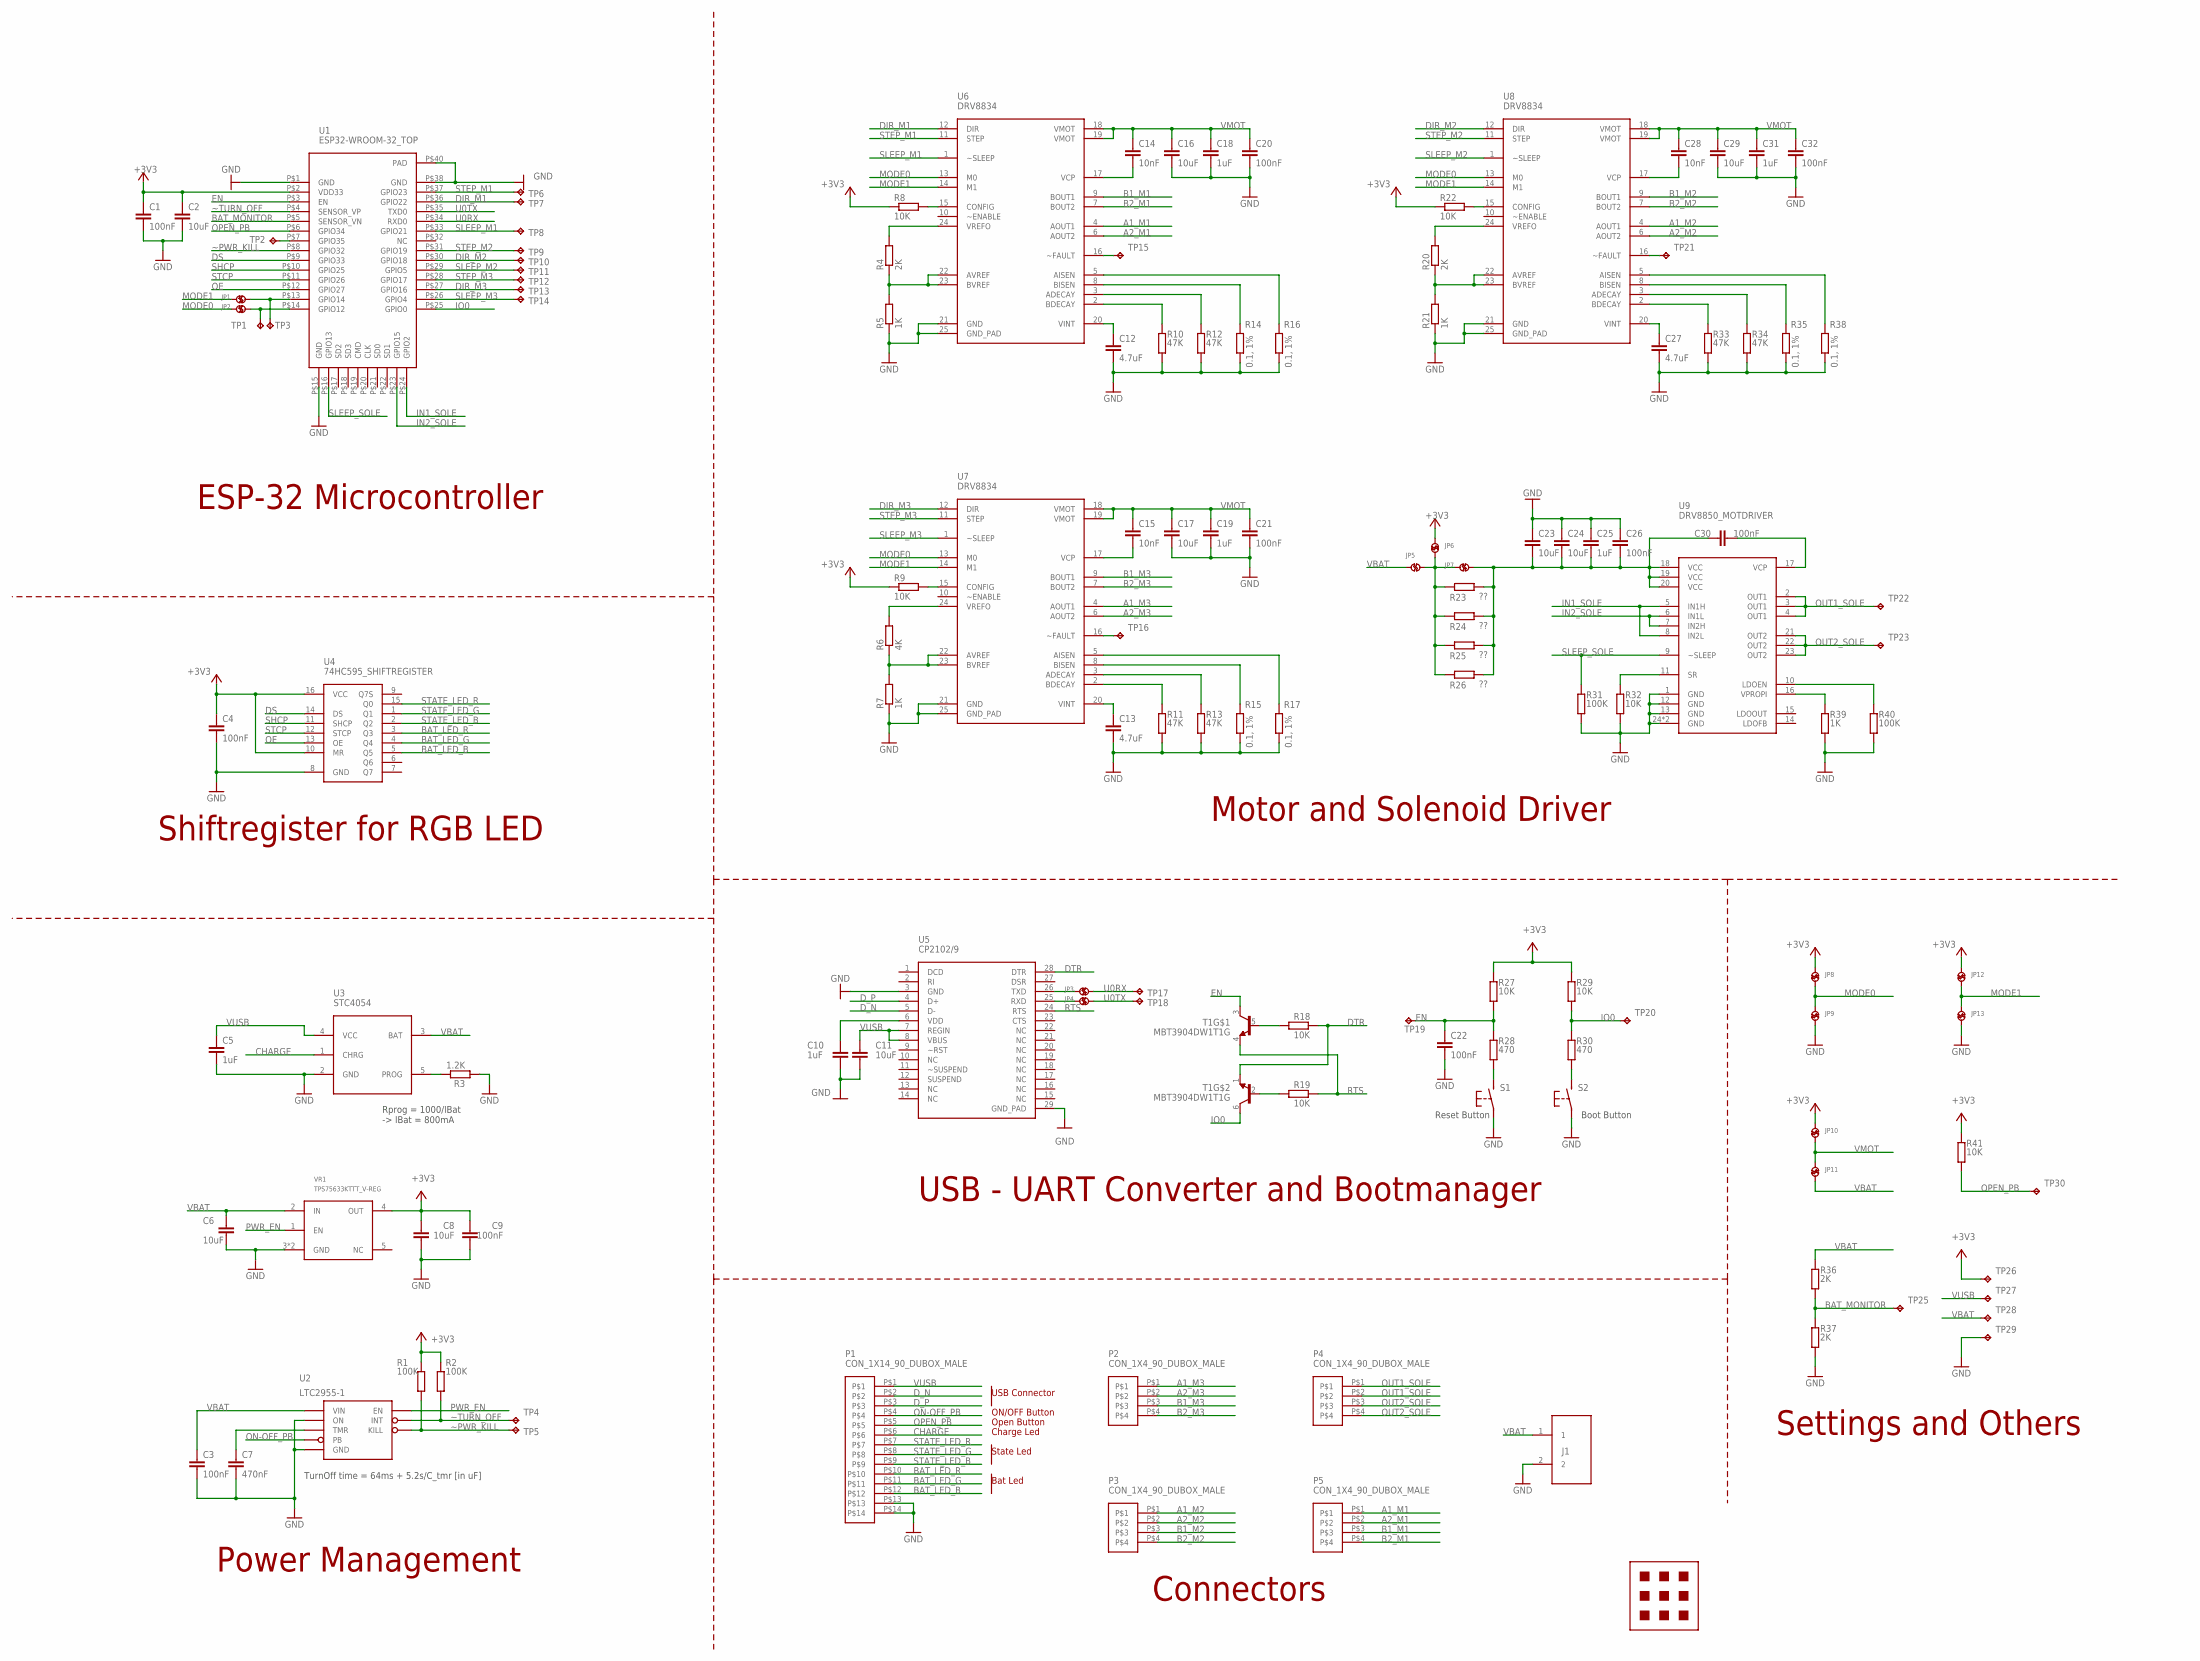
[picture p94: schematic Puzzle_Controller.sch]

Parts:
C1, C3, C4, C9, C20, C21, C22, C26, C30, C32: 100nF; 0603
C2, C6, C8, C11, C16, C17, C23, C24, C29: 10uF; 0603
C5, C10, C18, C19, C25, C31: 1uF; 0603
C7: 470nF; 0603
C12, C13, C27: 4.7uF; 0603
C14, C15, C28: 10nF; 0603
J1: CON_2
JP1, JP2, JP3, JP4, JP5, JP6, JP7, JP8, JP9, JP10, JP11, JP12, JP13: SOLDER_JUMPER
MEC1: FREESTYLE_PAD
P1: CON_1X14_90_DUBOX_MALE
P2, P3, P4, P5: CON_1X4_90_DUBOX_MALE
R1, R2, R31, R40: 100K; 0603
R3: 1.2K; 0603
R4, R20, R36, R37: 2K; 0603
R5, R7, R21, R39: 1K; 0603
R6: 4K; 0603
R8, R9, R18, R19, R22, R27, R29, R32, R41: 10K; 0603
R10, R11, R12, R13, R33, R34: 47K; 0603
R14, R15, R16, R17, R35, R38: 0.1, 1%; 0603
R23, R24, R25, R26: ??; 0603
R28, R30: 470; 0603
S1, S2: B3U-1000P
T1: MBT3904DW1T1G; SOT23-6
TP1, TP2, TP3, TP4, TP5, TP6, TP7, TP8, TP9, TP10, TP11, TP12, TP13, TP14, TP15, TP16, TP17, TP18, TP19, TP20, TP21, TP22, TP23, TP25, TP26, TP27, TP28, TP29, TP30: TP; TEST_PAD
U1: ESP32-WROOM-32_TOP
U2: LTC2955-1; SOT23-8
U3: STC4054; TSOT23-5L
U4: 74HC595_SHIFTREGISTER; SOIC-16
U5: CP2102/9; QFN-28
U6, U7, U8: DRV8834; TSSOP-24
U9: DRV8850_MOTDRIVER; QFN-24
VR1: TPS75633KTTT_V-REG

Connections:
+3V3: C1.1, C2.1, C4.1, C8.2, C9.2, JP6.P$2, JP8.P$1, JP10.P$1, JP12.P$1, R1.1, R2.1, R8.1, R9.1, R22.1, R27.2, R29.2, R41.2, TP26.TP, U1.P$2 (VDD33), U4.10 (MR), U4.16 (VCC), VR1.4 (OUT)
A1_M1: P5.P$1, U6.4 (AOUT1)
A1_M2: P3.P$1, U8.4 (AOUT1)
A1_M3: P2.P$1, U7.4 (AOUT1)
A2_M1: P5.P$2, U6.6 (AOUT2)
A2_M2: P3.P$2, U8.6 (AOUT2)
A2_M3: P2.P$2, U7.6 (AOUT2)
B1_M1: P5.P$3, U6.9 (BOUT1)
B1_M2: P3.P$3, U8.9 (BOUT1)
B1_M3: P2.P$3, U7.9 (BOUT1)
B2_M1: P5.P$4, U6.7 (BOUT2)
B2_M2: P3.P$4, U8.7 (BOUT2)
B2_M3: P2.P$4, U7.7 (BOUT2)
BAT_LED_B: P1.P$12, U4.5 (Q5)
BAT_LED_G: P1.P$11, U4.4 (Q4)
BAT_LED_R: P1.P$10, U4.3 (Q3)
BAT_MONITOR: R36.2, R37.1, TP25.TP, U1.P$5 (SENSOR_VN)
CHARGE: P1.P$6, U3.1 (CHRG)
DIR_M1: TP7.TP, U1.P$36 (GPIO22), U6.12 (DIR)
DIR_M2: TP10.TP, U1.P$30 (GPIO18), U8.12 (DIR)
DIR_M3: TP13.TP, U1.P$27 (GPIO16), U7.12 (DIR)
DS: U1.P$9 (GPIO33), U4.14 (DS)
DTR: R18.1, T1.1 (E), U5.28 (DTR)
D_N: P1.P$2, U5.5 (D-)
D_P: P1.P$3, U5.4 (D+)
EN: C22.1, R27.1, R28.2, T1.3 (C), TP19.TP, U1.P$3 (EN)
GND: C1.2, C2.2, C3.2, C4.2, C5.2, C6.2, C7.2, C8.1, C9.1, C10.2, C11.2, C12.2, C13.2, C16.2, C17.2, C18.2, C19.2, C20.2, C21.2, C22.2, C23.1, C24.1, C25.1, C26.1, C27.2, C29.2, C31.2, C32.2, J1.2, JP9.P$2, JP13.P$2, P1.P$13, P1.P$14, R3.1, R5.1, R7.1, R10.1, R11.1, R12.1, R13.1, R14.1, R15.1, R16.1, R17.1, R21.1, R31.1, R32.1, R33.1, R34.1, R35.1, R37.2, R38.1, R39.1, R40.1, S1.P$1, S2.P$1, TP29.TP, U1.P$1 (GND), U1.P$15 (GND), U1.P$38 (GND), U1.P$40 (PAD), U2.1 (ON), U2.4 (GND), U3.2 (GND), U4.8 (GND), U5.3 (GND), U5.29 (GND_PAD), U6.21 (GND), U6.25 (GND_PAD), U7.21 (GND), U7.25 (GND_PAD), U8.21 (GND), U8.25 (GND_PAD), U9.1 (GND), U9.12 (GND), U9.13 (GND), U9.24 (GND), U9.25 (GND), VR1.3 (GND), VR1.6 (GND)
IN1_SOLE: U1.P$24 (GPIO2), U9.5 (IN1H), U9.8 (IN2L)
IN2_SOLE: U1.P$23 (GPIO15), U9.6 (IN1L), U9.7 (IN2H)
IO0: R29.1, R30.2, T1.6 (C), TP20.TP, U1.P$25 (GPIO0)
MODE0: JP2.P$1, JP8.P$2, JP9.P$1, U6.13 (M0), U7.13 (M0), U8.13 (M0)
MODE1: JP1.P$1, JP12.P$2, JP13.P$1, U6.14 (M1), U7.14 (M1), U8.14 (M1)
unnamed: R28.1, S1.P$2 (S)
unnamed: R8.2, U6.15 (CONFIG)
unnamed: R30.1, S2.P$2 (S)
unnamed: R18.2, T1.5 (B)
unnamed: R19.2, T1.2 (B)
unnamed: C10.1, U5.6 (VDD)
unnamed: R4.1, R5.2, U6.22 (AVREF), U6.23 (BVREF)
unnamed: R4.2, U6.24 (VREFO)
unnamed: C14.2, U6.17 (VCP)
unnamed: C12.1, U6.20 (VINT)
unnamed: JP3.P$1, U5.26 (TXD)
unnamed: R10.2, U6.2 (BDECAY)
unnamed: R12.2, U6.3 (ADECAY)
unnamed: R14.2, U6.8 (BISEN)
unnamed: R16.2, U6.5 (AISEN)
unnamed: JP5.P$1, JP6.P$1, JP7.P$1, R23.1, R24.1, R25.1, R26.1
unnamed: TP15.TP, U6.16 (~FAULT)
unnamed: JP4.P$1, U5.25 (RXD)
unnamed: R3.2, U3.5 (PROG)
unnamed: TP2.TP, U1.P$7 (GPIO35)
unnamed: R22.2, U8.15 (CONFIG)
unnamed: C23.2, C24.2, C25.2, C26.2, C30.1, JP7.P$2, R23.2, R24.2, R25.2, R26.2, U9.18 (VCC), U9.19 (VCC), U9.20 (VCC)
unnamed: JP1.P$2, TP3.TP, U1.P$13 (GPIO14)
unnamed: C7.1, U2.3 (TMR)
unnamed: R20.1, R21.2, U8.22 (AVREF), U8.23 (BVREF)
unnamed: R20.2, U8.24 (VREFO)
unnamed: C28.2, U8.17 (VCP)
unnamed: TP21.TP, U8.16 (~FAULT)
unnamed: C27.1, U8.20 (VINT)
unnamed: R33.2, U8.2 (BDECAY)
unnamed: R34.2, U8.3 (ADECAY)
unnamed: R35.2, U8.8 (BISEN)
unnamed: R38.2, U8.5 (AISEN)
unnamed: R9.2, U7.15 (CONFIG)
unnamed: R6.1, R7.2, U7.22 (AVREF), U7.23 (BVREF)
unnamed: R6.2, U7.24 (VREFO)
unnamed: C15.2, U7.17 (VCP)
unnamed: TP16.TP, U7.16 (~FAULT)
unnamed: C13.1, U7.20 (VINT)
unnamed: R11.2, U7.2 (BDECAY)
unnamed: R13.2, U7.3 (ADECAY)
unnamed: R15.2, U7.8 (BISEN)
unnamed: R17.2, U7.5 (AISEN)
unnamed: R39.2, U9.16 (VPROPI)
unnamed: R32.2, U9.11 (SR)
unnamed: C30.2, U9.17 (VCP)
unnamed: R40.2, U9.10 (LDOEN)
unnamed: JP2.P$2, TP1.TP, U1.P$14 (GPIO12)
OE: U1.P$12 (GPIO27), U4.13 (OE)
ON-OFF_PB: P1.P$4, U2.5 (PB)
OPEN_PB: P1.P$5, R41.1, TP30.TP, U1.P$6 (GPIO34)
OUT1_SOLE: P4.P$1, P4.P$2, TP22.TP, U9.2 (OUT1), U9.3 (OUT1), U9.4 (OUT1)
OUT2_SOLE: P4.P$3, P4.P$4, TP23.TP, U9.21 (OUT2), U9.22 (OUT2), U9.23 (OUT2)
PWR_EN: U2.7 (EN), VR1.1 (EN)
RTS: R19.1, T1.4 (E), U5.24 (RTS)
SHCP: U1.P$10 (GPIO25), U4.11 (SHCP)
SLEEP_M1: TP8.TP, U1.P$33 (GPIO21), U6.1 (~SLEEP)
SLEEP_M2: TP11.TP, U1.P$29 (GPIO5), U8.1 (~SLEEP)
SLEEP_M3: TP14.TP, U1.P$26 (GPIO4), U7.1 (~SLEEP)
SLEEP_SOLE: R31.2, U1.P$16 (GPIO13), U9.9 (~SLEEP)
STATE_LED_B: P1.P$9, U4.2 (Q2)
STATE_LED_G: P1.P$8, U4.1 (Q1)
STATE_LED_R: P1.P$7, U4.15 (Q0)
STCP: U1.P$11 (GPIO26), U4.12 (STCP)
STEP_M1: TP6.TP, U1.P$37 (GPIO23), U6.11 (STEP)
STEP_M2: TP9.TP, U1.P$31 (GPIO19), U8.11 (STEP)
STEP_M3: TP12.TP, U1.P$28 (GPIO17), U7.11 (STEP)
U0RX: JP3.P$2, TP17.TP, U1.P$34 (RXD0)
U0TX: JP4.P$2, TP18.TP, U1.P$35 (TXD0)
VBAT: C3.1, C6.1, J1.1, JP5.P$2, JP11.P$2, R36.1, TP28.TP, U2.6 (VIN), U3.3 (BAT), VR1.2 (IN)
VMOT: C14.1, C15.1, C16.1, C17.1, C18.1, C19.1, C20.1, C21.1, C28.1, C29.1, C31.1, C32.1, JP10.P$2, JP11.P$1, U6.18 (VMOT), U6.19 (VMOT), U7.18 (VMOT), U7.19 (VMOT), U8.18 (VMOT), U8.19 (VMOT)
VUSB: C5.1, C11.1, P1.P$1, TP27.TP, U3.4 (VCC), U5.7 (REGIN), U5.8 (VBUS)
~PWR_KILL: R1.2, TP5.TP, U1.P$8 (GPIO32), U2.2 (KILL)
~TURN_OFF: R2.2, TP4.TP, U1.P$4 (SENSOR_VP), U2.8 (INT)

Notes on the sheet:
Reset Button
Boot Button
Rprog = 1000/IBat -> IBat = 800mA
TurnOff time = 64ms + 5.2s/C_tmr [in uF]
Charge Led
State Led
ON/OFF Button
Open Button
Bat Led
USB Connector
ESP-32 Microcontroller
Shiftregister for RGB LED
Power Management
Connectors
USB - UART Converter and Bootmanager
Settings and Others
Motor and Solenoid Driver

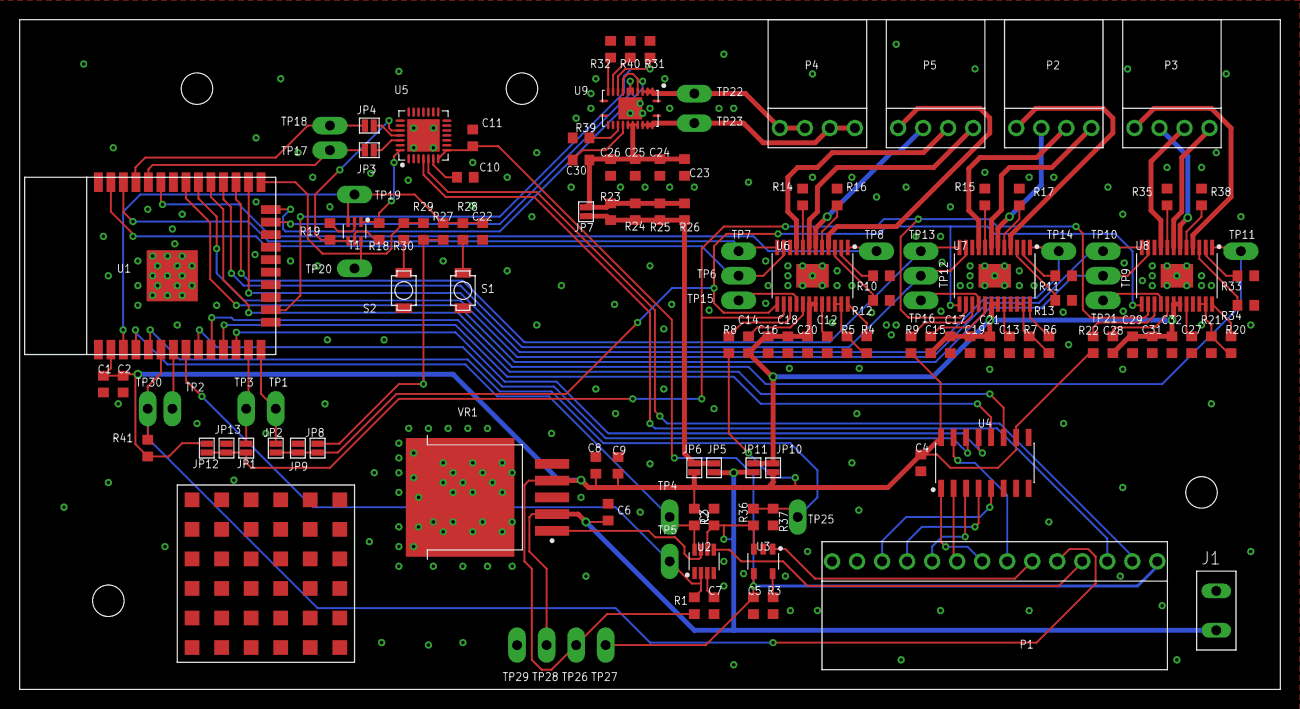
[picture p95: board Puzzle_Controller.brd from above]

Board: 2 copper layers, 128.0 x 68.0 mm, 135 parts (0 on the bottom side), 106 nets.
