lpm97/BA_MagicTrick/4_Fernbedienung/Eagle-Projekt/RemoteControl.brd

## EAGLE design 4_Fernbedienung/Eagle-Projekt/RemoteControl.brd (2021-06-11)

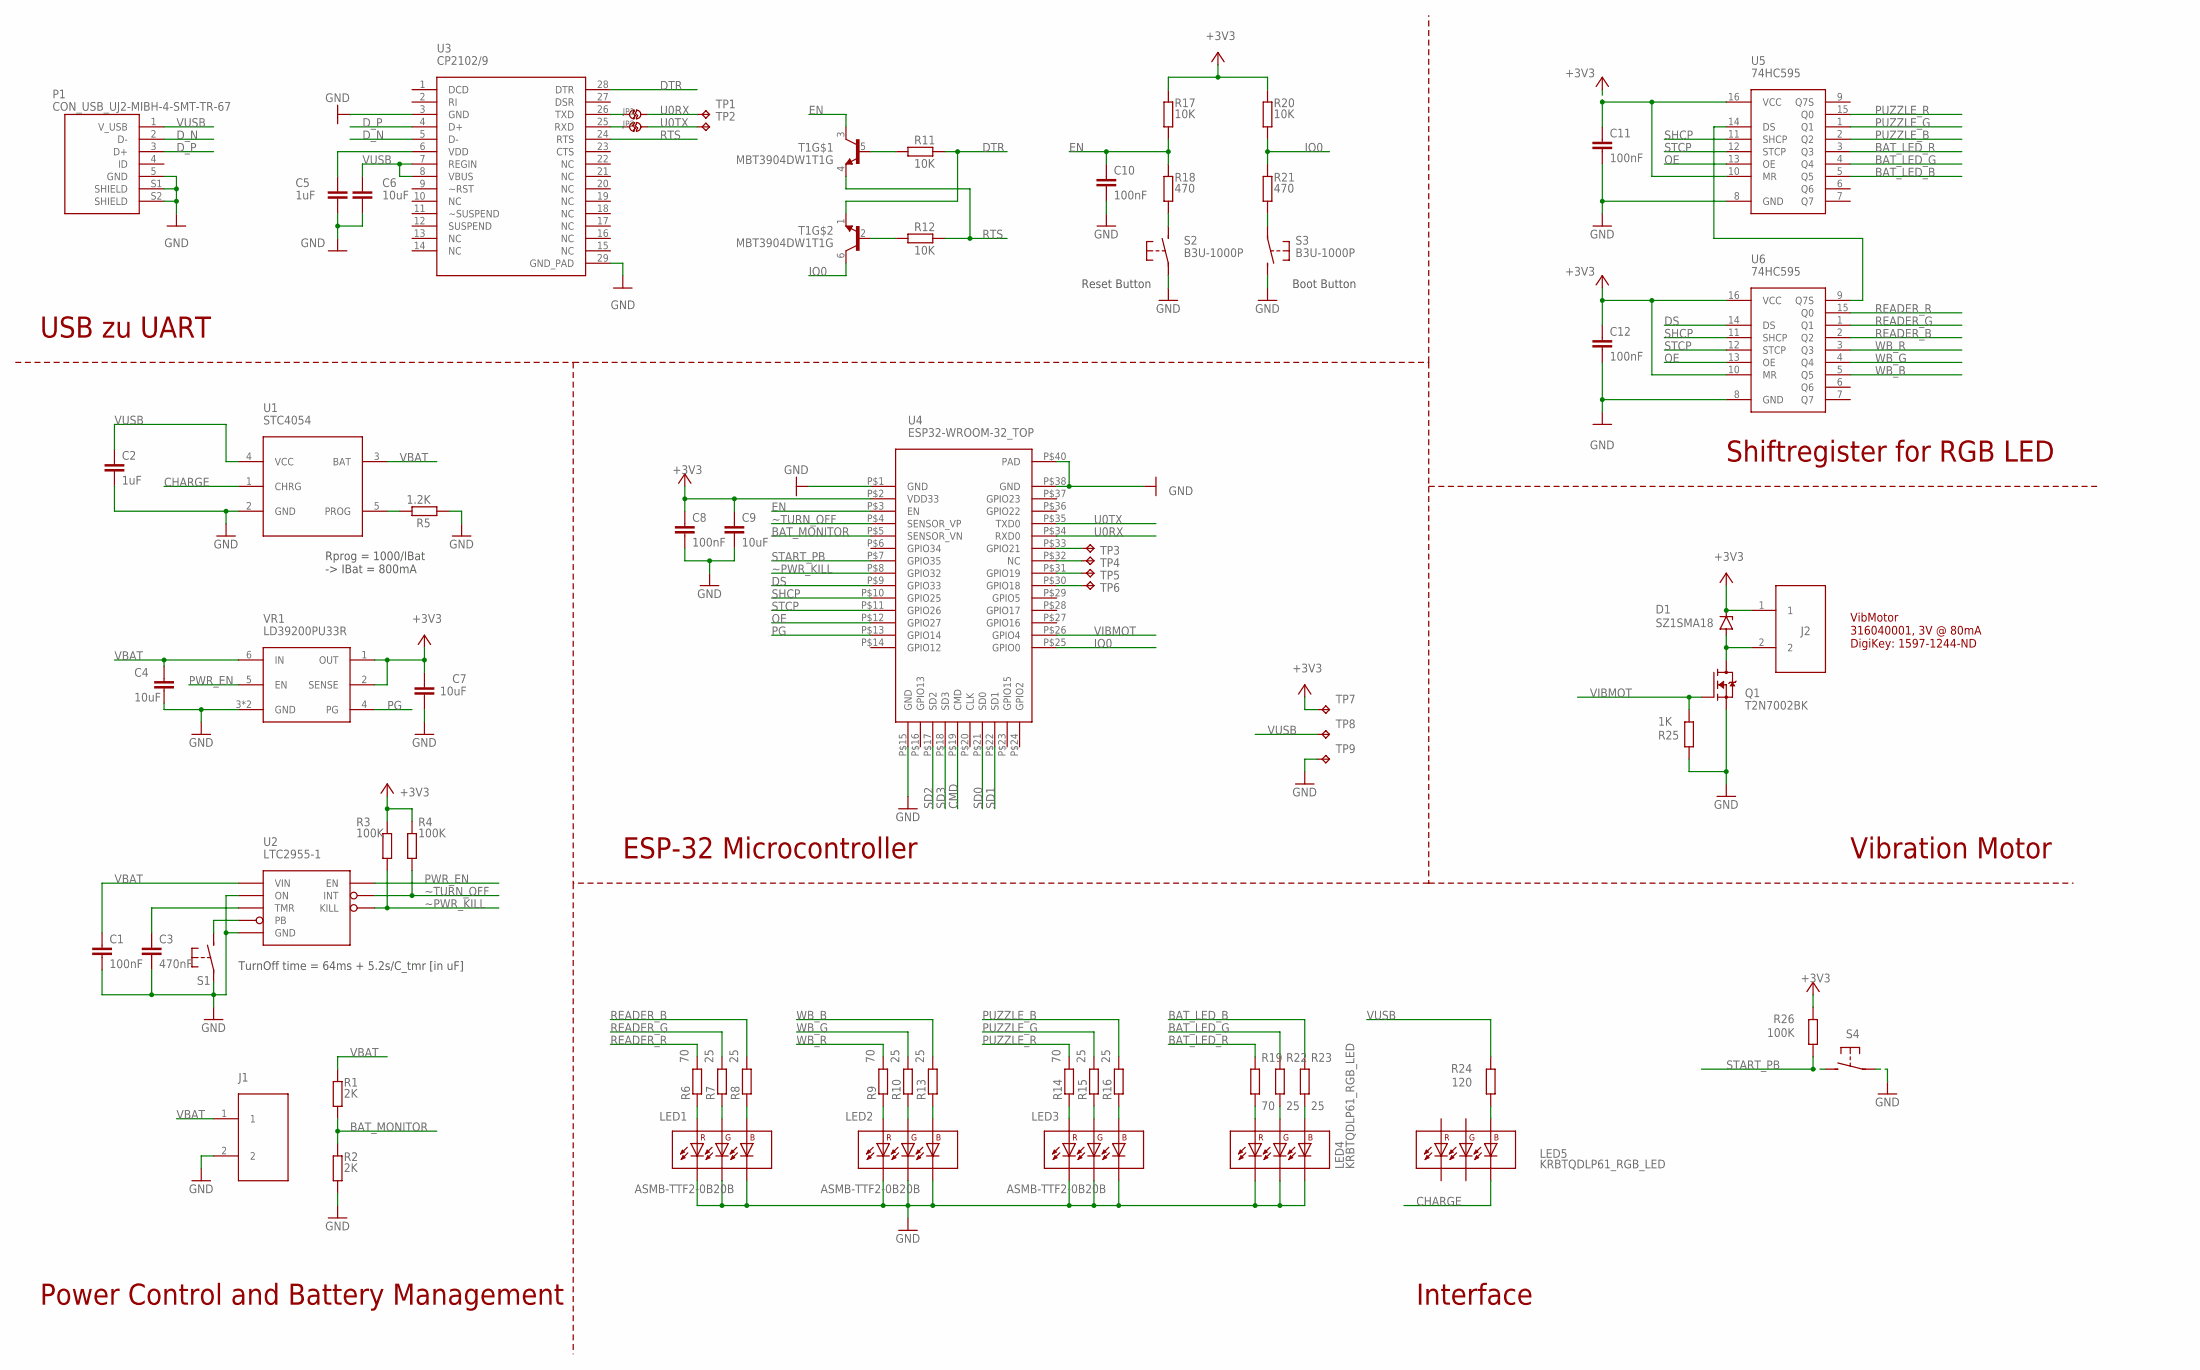
[picture p96: schematic RemoteControl.sch]

Parts:
C1, C8, C10, C11, C12: 100nF; 0603
C2, C5: 1uF; 0603
C3: 470nF; 0603
C4, C6, C7, C9: 10uF; 0603
D1: SZ1SMA18; SMA-2
J1, J2: CON_2
JP1, JP2: SOLDER_JUMPER
LED1, LED2, LED3: ASMB-TTF2-0B20B; ASMB-TTF2-0B20B_RGB_LED
LED4, LED5: KRBTQDLP61_RGB_LED
P1: CON_USB_UJ2-MIBH-4-SMT-TR-67
Q1: T2N7002BK; SOT23-3
R1, R2: 2K; 0603
R3, R4, R26: 100K; 0603
R5: 1.2K; 0603
R6, R9, R14, R19: 70; 0603
R7, R8, R10, R13, R15, R16, R22, R23: 25; 0603
R11, R12, R17, R20: 10K; 0603
R18, R21: 470; 0603
R24: 120; 0603
R25: 1K; 0603
S1: EG5358CT-ND_PB
S2, S3: B3U-1000P
S4: TL3313AF160QG_2
T1: MBT3904DW1T1G; SOT23-6
TP1, TP2, TP3, TP4, TP5, TP6, TP7, TP8, TP9: TP; TEST_PAD
U1: STC4054; TSOT23-5L
U2: LTC2955-1; SOT23-8
U3: CP2102/9; QFN-28
U4: ESP32-WROOM-32_TOP
U5, U6: 74HC595; SOIC-16
VR1: LD39200PU33R; DFN-6

Connections:
+3V3: C7.2, C8.1, C9.1, C11.1, C12.1, D1.1 (C), J2.1, R3.1, R4.1, R17.2, R20.2, R26.2, TP7.TP, U4.P$2 (VDD33), U5.10 (MR), U5.16 (VCC), U6.10 (MR), U6.16 (VCC), VR1.1 (OUT), VR1.2 (SENSE)
BAT_LED_B: R23.2, U5.5 (Q5)
BAT_LED_G: R22.2, U5.4 (Q4)
BAT_LED_R: R19.2, U5.3 (Q3)
BAT_MONITOR: R1.2, R2.1, U4.P$5 (SENSOR_VN)
CHARGE: LED5.P$4 (BC), U1.1 (CHRG)
CMD: U4.P$19 (CMD)
DS: U4.P$9 (GPIO33), U6.14 (DS)
DTR: R11.1, T1.1 (E), U3.28 (DTR)
D_N: P1.2 (D-), U3.5 (D-)
D_P: P1.3 (D+), U3.4 (D+)
EN: C10.1, R17.1, R18.2, T1.3 (C), U4.P$3 (EN)
GND: C1.2, C2.2, C3.2, C4.2, C5.2, C6.2, C7.1, C8.2, C9.2, C10.2, C11.2, C12.2, J1.2, LED1.BC, LED1.GC, LED1.RC, LED2.BC, LED2.GC, LED2.RC, LED3.BC, LED3.GC, LED3.RC, LED4.P$3 (GC), LED4.P$4 (BC), LED4.P$6 (RC), P1.5 (GND), P1.S1 (SHIELD), P1.S2 (SHIELD), Q1.2 (S), R2.2, R5.1, R25.1, S1.1, S1.S1, S1.S2, S2.P$1, S3.P$2 (S), S4.1, S4.2, TP9.TP, U1.2 (GND), U2.1 (ON), U2.4 (GND), U3.3 (GND), U3.29 (GND_PAD), U4.P$1 (GND), U4.P$15 (GND), U4.P$38 (GND), U4.P$40 (PAD), U5.8 (GND), U6.8 (GND), VR1.3 (GND), VR1.7 (GND)
IO0: R20.1, R21.2, T1.6 (C), U4.P$25 (GPIO0)
unnamed: U5.14 (DS), U6.9 (Q7S)
unnamed: D1.2 (A), J2.2, Q1.3 (D)
unnamed: R11.2, T1.5 (B)
unnamed: R12.2, T1.2 (B)
unnamed: C5.1, U3.6 (VDD)
unnamed: LED4.P$5 (RA), R19.1
unnamed: R18.1, S2.P$2 (S)
unnamed: R21.1, S3.P$1
unnamed: LED5.P$2 (BA), R24.1
unnamed: LED4.P$1 (GA), R22.1
unnamed: R5.2, U1.5 (PROG)
unnamed: JP1.P$1, U3.26 (TXD)
unnamed: LED4.P$2 (BA), R23.1
unnamed: JP2.P$1, U3.25 (RXD)
unnamed: S1.2 (S), U2.5 (PB)
unnamed: TP5.TP, U4.P$31 (GPIO19)
unnamed: C3.1, U2.3 (TMR)
unnamed: TP6.TP, U4.P$30 (GPIO18)
unnamed: TP3.TP, U4.P$33 (GPIO21)
unnamed: LED2.RA, R9.1
unnamed: TP4.TP, U4.P$32 (NC)
unnamed: LED2.GA, R10.1
unnamed: LED2.BA, R13.1
unnamed: LED3.RA, R14.1
unnamed: LED3.GA, R15.1
unnamed: LED3.BA, R16.1
unnamed: LED1.RA, R6.1
unnamed: LED1.GA, R7.1
unnamed: LED1.BA, R8.1
OE: U4.P$12 (GPIO27), U5.13 (OE), U6.13 (OE)
PG: U4.P$13 (GPIO14), VR1.4 (PG)
PUZZLE_B: R16.2, U5.2 (Q2)
PUZZLE_G: R15.2, U5.1 (Q1)
PUZZLE_R: R14.2, U5.15 (Q0)
PWR_EN: U2.7 (EN), VR1.5 (EN)
READER_B: R8.2, U6.2 (Q2)
READER_G: R7.2, U6.1 (Q1)
READER_R: R6.2, U6.15 (Q0)
RTS: R12.1, T1.4 (E), U3.24 (RTS)
SD0: U4.P$21 (SD0)
SD1: U4.P$22 (SD1)
SD2: U4.P$17 (SD2)
SD3: U4.P$18 (SD3)
SHCP: U4.P$10 (GPIO25), U5.11 (SHCP), U6.11 (SHCP)
START_PB: R26.1, S4.3 (S), S4.4 (S), U4.P$7 (GPIO35)
STCP: U4.P$11 (GPIO26), U5.12 (STCP), U6.12 (STCP)
U0RX: JP1.P$2, TP1.TP, U4.P$34 (RXD0)
U0TX: JP2.P$2, TP2.TP, U4.P$35 (TXD0)
VBAT: C1.1, C4.1, J1.1, R1.1, U1.3 (BAT), U2.6 (VIN), VR1.6 (IN)
VIBMOT: Q1.1 (G), R25.2, U4.P$26 (GPIO4)
VUSB: C2.1, C6.1, P1.1 (V_USB), R24.2, TP8.TP, U1.4 (VCC), U3.7 (REGIN), U3.8 (VBUS)
WB_B: R13.2, U6.5 (Q5)
WB_G: R10.2, U6.4 (Q4)
WB_R: R9.2, U6.3 (Q3)
~PWR_KILL: R3.2, U2.2 (KILL), U4.P$8 (GPIO32)
~TURN_OFF: R4.2, U2.8 (INT), U4.P$4 (SENSOR_VP)

Notes on the sheet:
Rprog = 1000/IBat -> IBat = 800mA
TurnOff time = 64ms + 5.2s/C_tmr [in uF]
Reset Button
Boot Button
Power Control and Battery Management
ESP-32 Microcontroller
USB zu UART
Shiftregister for RGB LED
VibMotor 316040001, 3V @ 80mA DigiKey: 1597-1244-ND
Interface
Vibration Motor
