lpm97/BA_MagicTrick/4_Fernbedienung/Eagle-Projekt/RemoteControl.brd

## EAGLE design 4_Fernbedienung/Eagle-Projekt/RemoteControl.brd (continued)

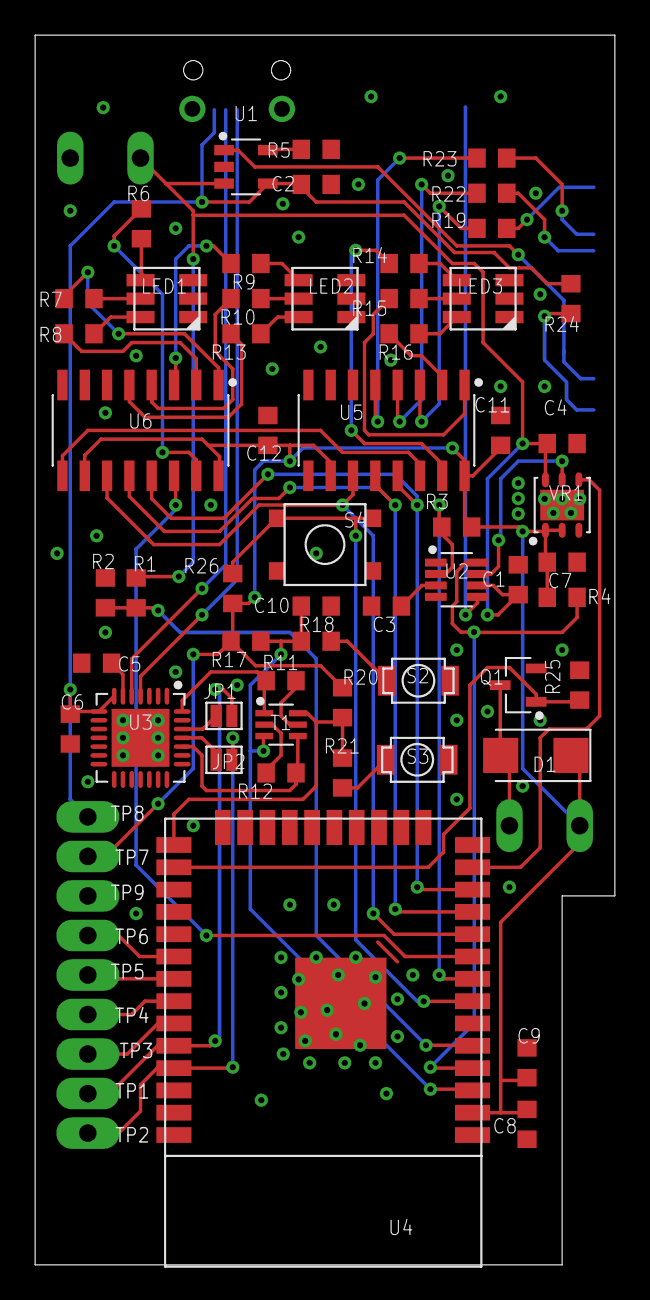
[picture p97: board RemoteControl.brd from above]

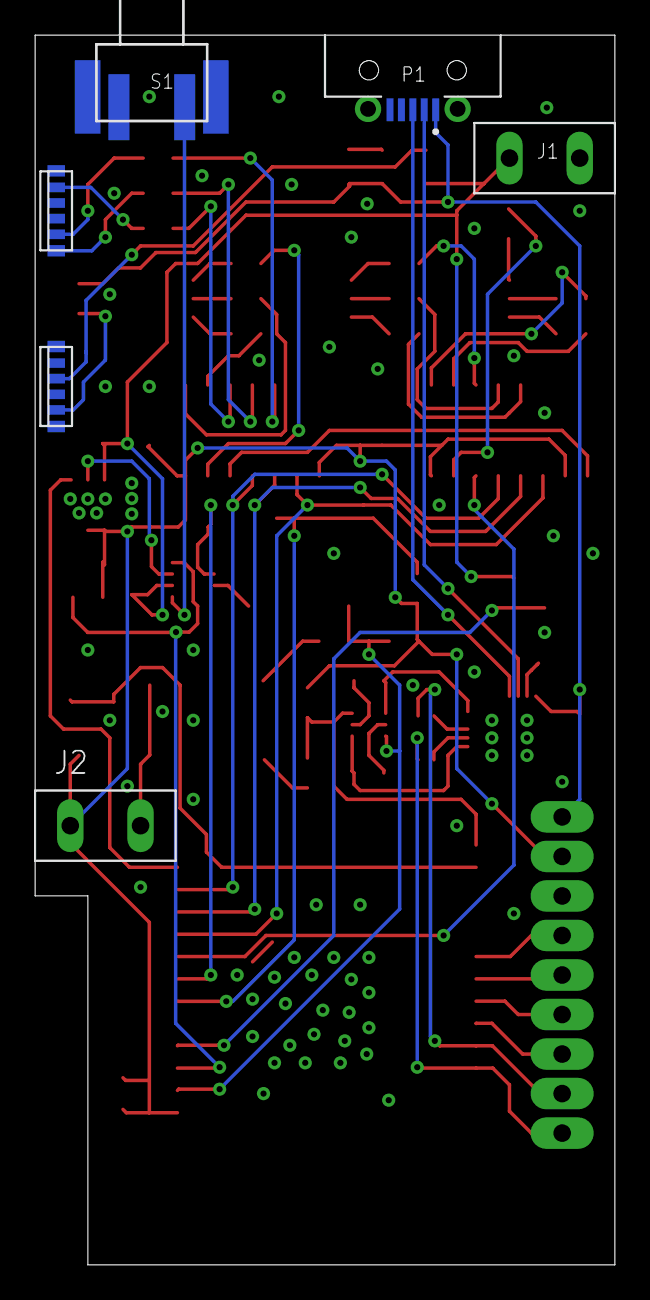
[picture p98: board RemoteControl.brd from below]

Board: 2 copper layers, 33.0 x 70.0 mm, 71 parts (6 on the bottom side), 65 nets.
