lpm97/BA_MagicTrick/2_Whiteboard/Eagle-Projekt/Whiteboardv2.brd

## EAGLE design 2_Whiteboard/Eagle-Projekt/Whiteboardv2.brd (2021-06-11)

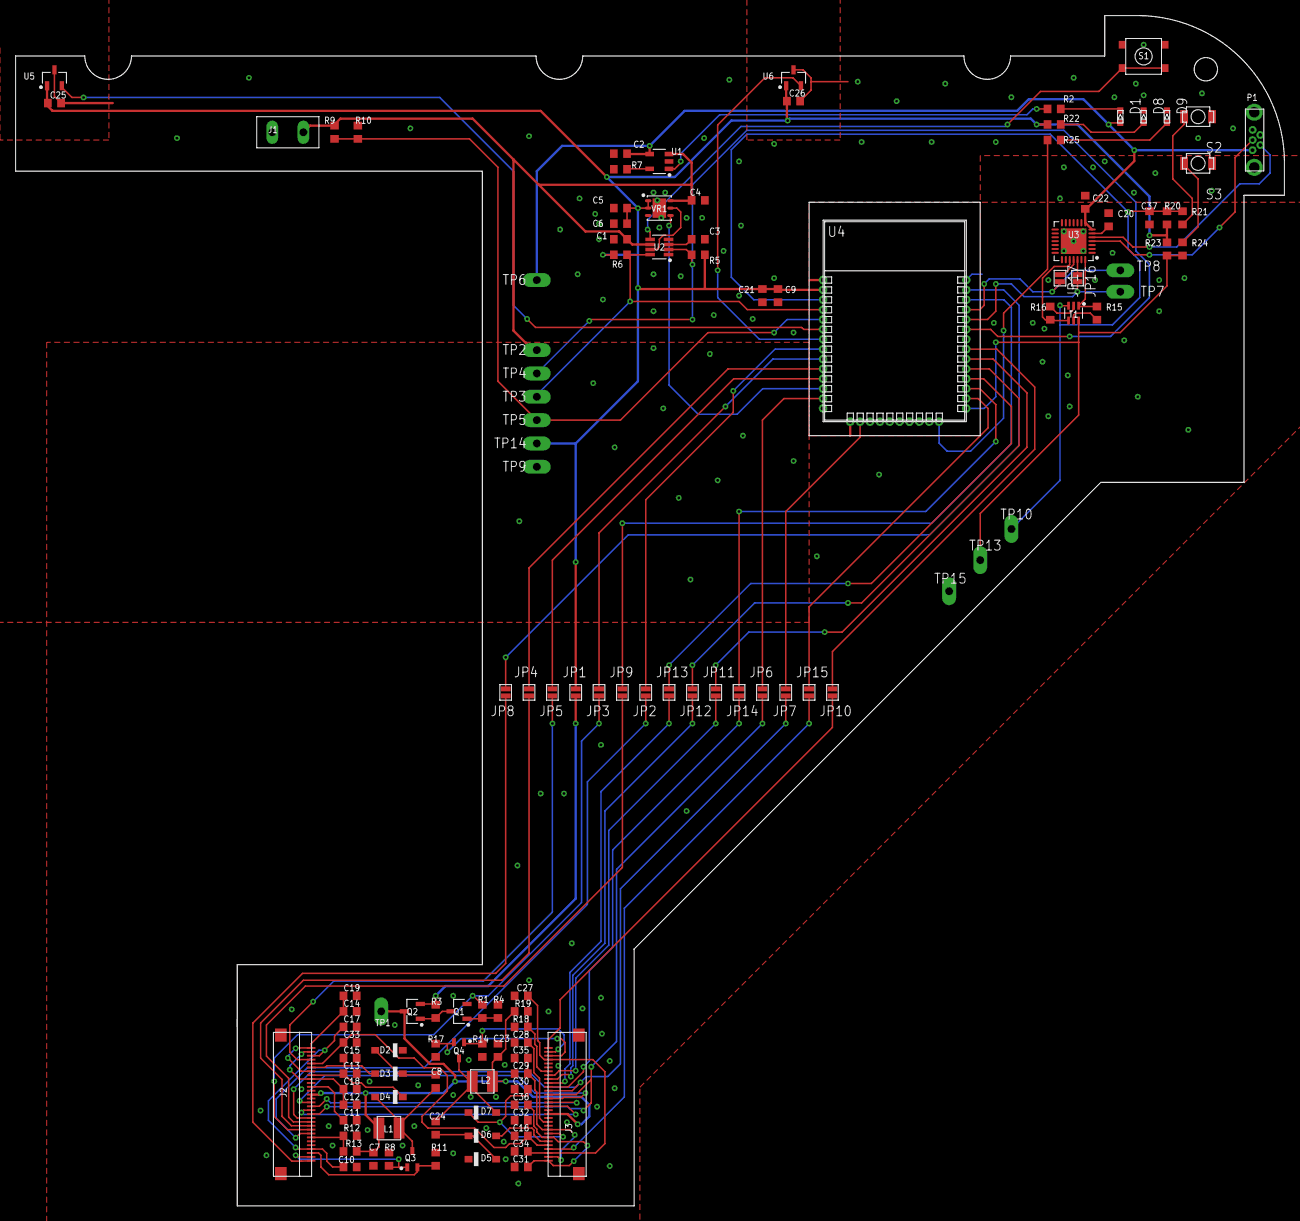
[picture p99: board Whiteboardv2.brd from above]

Board: 2 copper layers, 163.1 x 153.0 mm, 122 parts (0 on the bottom side), 92 nets.

Parts:
C1, C6, C9: 100nF; 0603
C2, C20: 1uF; 0603
C3, C25, C26: 470nF; 0603
C4, C5, C21, C22, C37: 10uF; 0603
C7, C8, C23, C24: 4.7uF/25V; 0603
C10, C11, C12, C13, C14, C15, C16, C17, C18, C19, C27, C28, C29, C30, C31, C32, C33, C34, C35, C36: 1uF/50V; 0603
D1, D8, D9: 0603_LED
D2, D3, D4, D5, D6, D7: MBR0530; SOD123
J1: CON_2
J2, J3: XF2M-30_CONN; XF2M-30
JP1, JP2, JP3, JP4, JP5, JP6, JP7, JP8, JP9, JP10, JP11, JP12, JP13, JP14, JP15, JP16, JP17: SOLDER_JUMPER
L1, L2: 10uH / 1A; SRN3015_IND
P1: USB_CON_VERTICAL; USB3131
Q1: SS8050-G; SOT23-3
Q2: AO3401A; SOT23-3
Q3, Q4: SI1308EDL; SOT-323
R1: 2.2K; 0603
R2, R22: 1K; 0603
R3, R8, R13, R14, R15, R16, R19, R20, R23: 10K; 0603
R4, R5, R6: 100K; 0603
R7: 1.2K; 0603
R9, R10: 2K; 0603
R11, R17: 1; 0603
R12, R18: 3; 0603
R21, R24, R25: 470; 0603
S1: BUTTON_TL3313AF160QG_2; TL3313AF160QG_2
S2, S3: BUTTON_B3U-1000P; B3U-1000P
T1: MBT3904DW1T1G; SOT23-6
TP1, TP2, TP3, TP4, TP5, TP6, TP7, TP8, TP9, TP10, TP13, TP14, TP15: TP; TEST_PAD
U1: STC4054_BAT_CHARGER; TSOT23-5L
U2: LTC2955-1_ON/OFF_CTLR; SOT23-8
U3: CP2102/9; QFN-28
U4: ESP32-WROOM-32_EMBEDDED
U5, U6: TCS40DPR; SOT23-3
VR1: LD39200PU33R_V-REG; DFN-6

Connections:
3V3_EPD: C7.2, C23.2, J2.P$17, J2.P$18, J3.P$17, J3.P$18, L1.P$1, L2.P$1, Q2.3, R13.2, R19.2, TP1.TP
+3V3: C5.2, C6.2, C9.1, C21.1, C25.1, C26.1, JP1.P$1, R5.1, R6.1, R20.2, R22.2, R23.2, TP14.TP, U4.P$2, U5.1, U6.1, VR1.1, VR1.2
BAT_MONITOR: R9.2, R10.1, TP5.TP, U4.P$5
BUSY_M1: J2.P$8, JP2.P$1
BUSY_M2: J3.P$8, JP11.P$1
BUSY_S1: J2.P$27, JP5.P$1
BUSY_S2: J3.P$27, JP15.P$1
CHRG: R2.1, U1.1
CLK: J2.P$12, J3.P$12, JP7.P$1
CS_M1: J2.P$1, JP8.P$1
CS_M2: J3.P$11, JP14.P$1
CS_S1: J2.P$11, JP9.P$1
CS_S2: J3.P$1, JP10.P$1
DC_1: J2.P$10, JP4.P$1
DC_2: J3.P$10, JP13.P$1
DIN: J2.P$13, J3.P$13, JP6.P$1
DTR: R15.1, T1.1, U3.28
D_N: P1.2, U3.5
D_P: P1.3, U3.4
EN: C37.1, R20.1, R21.2, T1.3, TP10.TP, U4.P$3
GDR1: J2.P$2, Q3.1, R8.2
GDR2: J3.P$2, Q4.1, R14.2
GND: C1.2, C2.2, C3.2, C4.2, C5.1, C6.1, C7.1, C9.2, C10.1, C11.1, C12.1, C13.1, C14.1, C15.1, C16.1, C17.1, C18.1, C19.1, C20.2, C21.2, C22.2, C23.1, C25.2, C26.2, C27.1, C28.1, C29.1, C30.1, C31.1, C32.1, C33.1, C34.1, C35.1, C36.1, C37.2, D2.1, D5.1, D8.K, D9.K, J1.2, J2.P$19, J3.P$19, P1.5, P1.P$6, P1.P$7, Q1.2, R4.1, R7.1, R8.1, R10.2, R11.1, R12.2, R14.1, R17.1, R18.2, S1.1, S1.2, S2.P$1, S3.P$1, TP9.TP, TP15.TP, U1.2, U2.1, U2.4, U3.3, U3.29, U4.P$1, U4.P$15, U4.P$38, U5.3, U6.3, VR1.3, VR1.7
IO0: R23.1, R24.2, T1.6, TP13.TP, U4.P$25
IO2: R25.2, U4.P$24
LSYNC: J2.P$14, J3.P$16
M1M2_SYNC: J2.P$15, J3.P$15
M2M1_SYNC: J2.P$16, J3.P$14
MAG_POS1: U4.P$6, U5.2
MAG_POS2: U4.P$7, U6.2
unnamed: R21.1, S2.P$2
unnamed: JP16.P$1, U3.26
unnamed: R24.1, S3.P$2
unnamed: R15.2, T1.5
unnamed: R16.2, T1.2
unnamed: C20.1, U3.6
unnamed: D8.A, R22.1
unnamed: D1.K, R2.2
unnamed: J3.P$7, R18.1, R19.1
unnamed: C28.2, J3.P$20
unnamed: D9.A, R25.1
unnamed: C8.2, D4.2, L1.P$2, Q3.3
unnamed: J2.P$7, R12.1, R13.1
unnamed: C8.1, D2.2, D3.1
unnamed: C24.2, D7.2, L2.P$2, Q4.3
unnamed: C24.1, D5.2, D6.1
unnamed: Q1.1, R1.2, R4.2
unnamed: Q1.3, Q2.1, R3.2
unnamed: R7.2, U1.5
unnamed: JP4.P$2, U4.P$10
unnamed: C11.2, J2.P$20
unnamed: JP3.P$2, U4.P$9
unnamed: S1.3, S1.4, U2.5
unnamed: JP2.P$2, U4.P$8
unnamed: C3.1, U2.3
unnamed: JP6.P$2, U4.P$13
unnamed: JP8.P$2, U4.P$37
unnamed: JP10.P$2, U4.P$31
unnamed: JP9.P$2, U4.P$36
unnamed: JP5.P$2, U4.P$11
unnamed: JP15.P$2, U4.P$26
unnamed: JP11.P$2, U4.P$30
unnamed: JP12.P$2, U4.P$29
unnamed: JP13.P$2, U4.P$28
unnamed: JP14.P$2, U4.P$27
unnamed: JP7.P$2, U4.P$16
unnamed: JP1.P$2, Q2.2, R3.1
unnamed: JP17.P$1, U3.25
PG: U4.P$12, VR1.4
PWR_EN: U2.7, VR1.5
RESE1: J2.P$3, Q3.2, R11.2
RESE2: J3.P$3, Q4.2, R17.2
RST_1: J2.P$9, JP3.P$1, R1.1
RST_2: J3.P$9, JP12.P$1
RTS: R16.1, T1.4, U3.24
U0RX: JP16.P$2, TP7.TP, U4.P$34
U0TX: JP17.P$2, TP8.TP, U4.P$35
VBAT: C1.1, C4.1, J1.1, R9.1, TP2.TP, U1.3, U2.6, VR1.6
VCOM_M1M2: C16.2, C33.2, J2.P$26, J3.P$26
VGH_M1: C13.2, D4.1, J2.P$23
VGH_M2: C30.2, D7.1, J3.P$23
VGL_M1: C15.2, D3.2, J2.P$25
VGL_M2: C32.2, D6.2, J3.P$25
VSHR_M1S1: C10.2, C17.2, J2.P$4, J2.P$28
VSHR_M2S2: C27.2, C34.2, J3.P$4, J3.P$28
VSH_M1S1: C12.2, C18.2, J2.P$22, J2.P$29
VSH_M2S2: C29.2, C35.2, J3.P$22, J3.P$29
VSL_M1S1: C14.2, C19.2, J2.P$24, J2.P$30
VSL_M2S2: C31.2, C36.2, J3.P$24, J3.P$30
VUSB: C2.1, C22.1, D1.A, P1.1, TP6.TP, U1.4, U3.7, U3.8
~PWR_KILL: R5.2, TP4.TP, U2.2, U4.P$33
~TURN_OFF: R6.2, TP3.TP, U2.8, U4.P$4
