lpm97/BA_MagicTrick/4_Fernbedienung/Remote_Code/Work.h

/*****************************************************************************
* | File        :   Work.h
* | Author      :   MM LM
* | Function    :   Drive Vibration Motor         
*----------------
* | This version:   V1.0
* | Date        :   2021_06_03
/*****************************************************************************/


/* Includes ------------------------------------------------------------------*/
#ifndef _WOKR_H_
#define _WOKR_H_

#include <Arduino.h>
#include <stdint.h>
#include <stdio.h>


/* define Functions--------------------------------------------------------------*/
void vib_Number(uint8_t, uint8_t);
void vib_Pattern(uint8_t);
#endif
