lpm97/BA_MagicTrick/(notices)

Notices in the files:
5_Eagle_Library/Step-Files/USB3131-30-0230-A_USB_Con.stp:
FILE_NAME( 'p:/temp/worker_2/temp/exporttempdir_3940_79_HvqPd/format_0/USB3131-30-0230-A.stp', '2021-02-10T14:41:08', ( 'License CC BY-ND 4.0' ), ( 'CADENAS' ), ' ', 'PARTsolutions', ' ' );
