lpm97/BA_MagicTrick/6_Fotos/20210323_165809.jpg

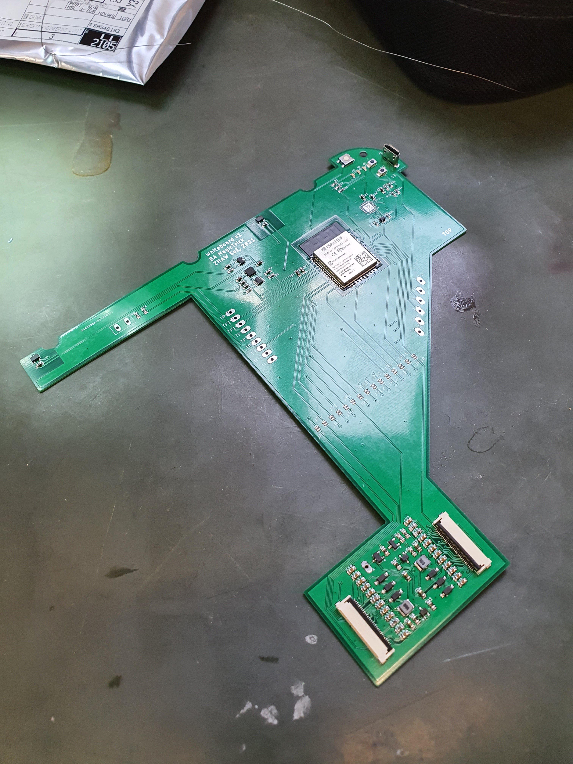
6_Fotos/20210323_165809.jpg
