lpm97/BA_MagicTrick/6_Fotos/20210323_165815.jpg

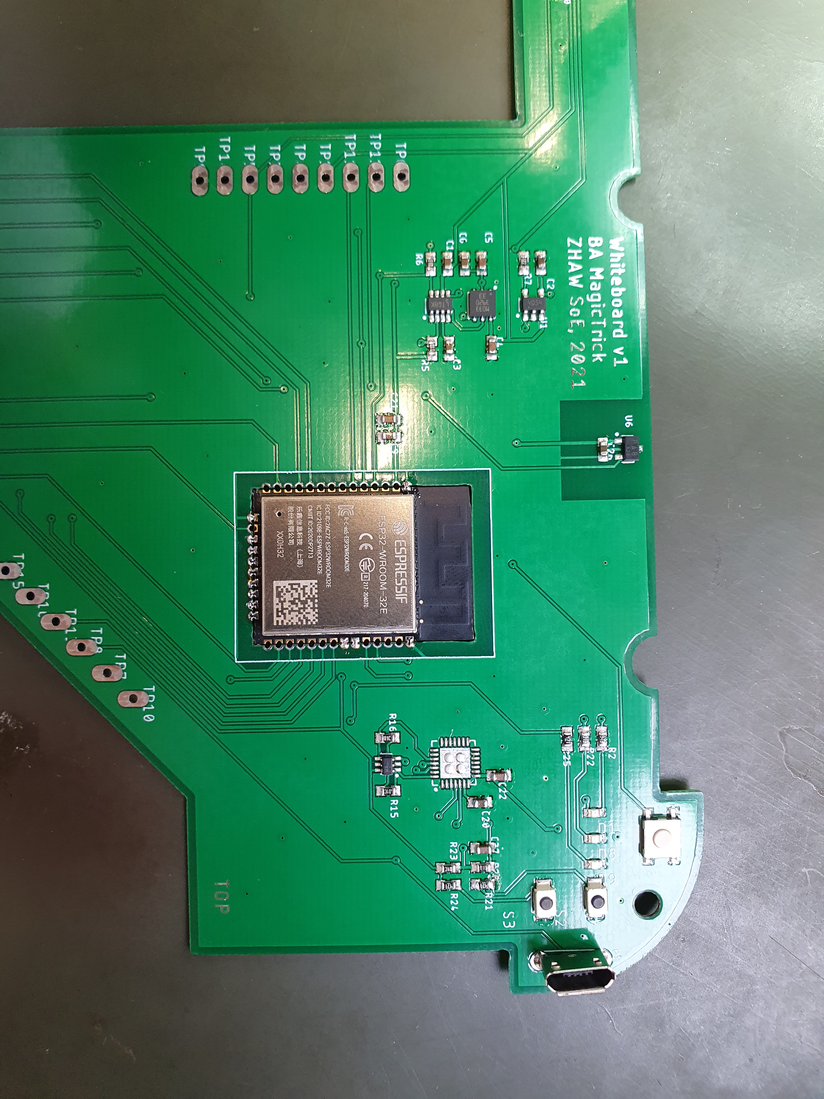
6_Fotos/20210323_165815.jpg
