lpm97/BA_MagicTrick/6_Fotos/20210506_190625.jpg

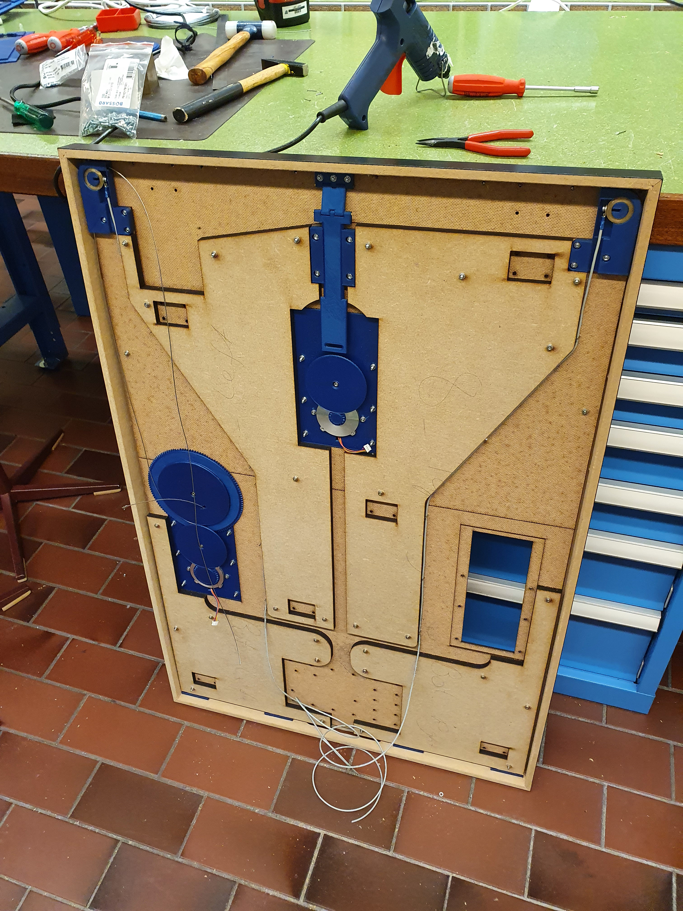
6_Fotos/20210506_190625.jpg
