lpm97/BA_MagicTrick/6_Fotos/20210506_192827.jpg

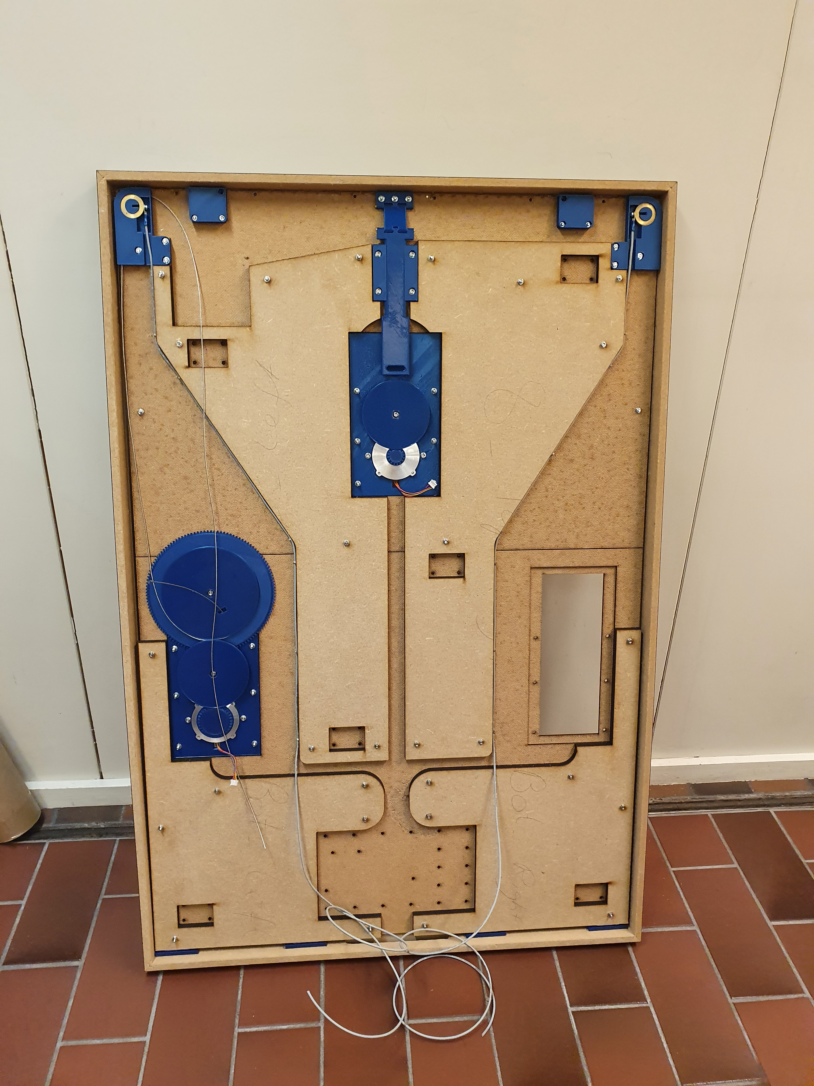
6_Fotos/20210506_192827.jpg
