lpm97/BA_MagicTrick/6_Fotos/20210601_145824.jpg

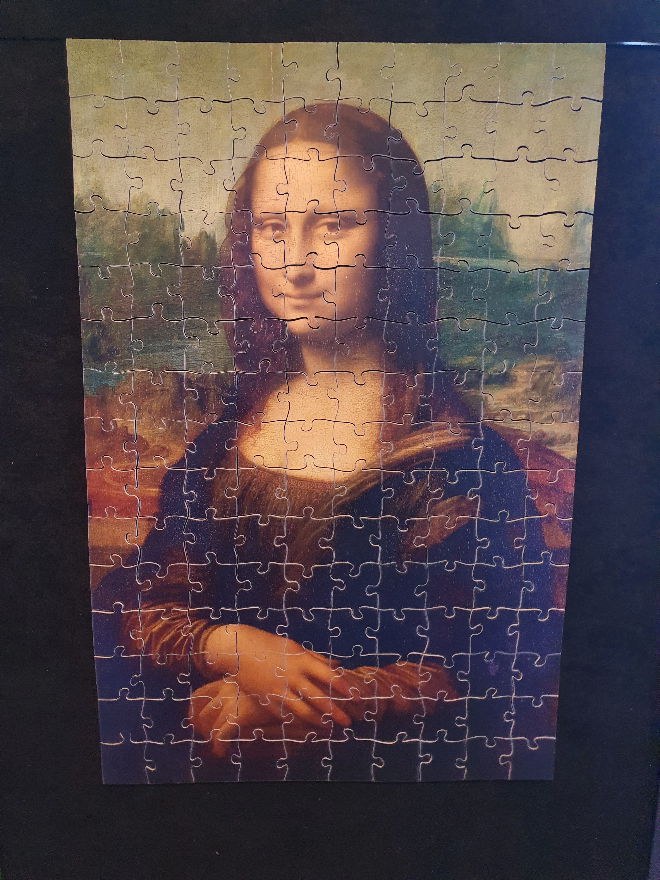
6_Fotos/20210601_145824.jpg
