lpm97/BA_MagicTrick/6_Fotos/20210608_213943.jpg

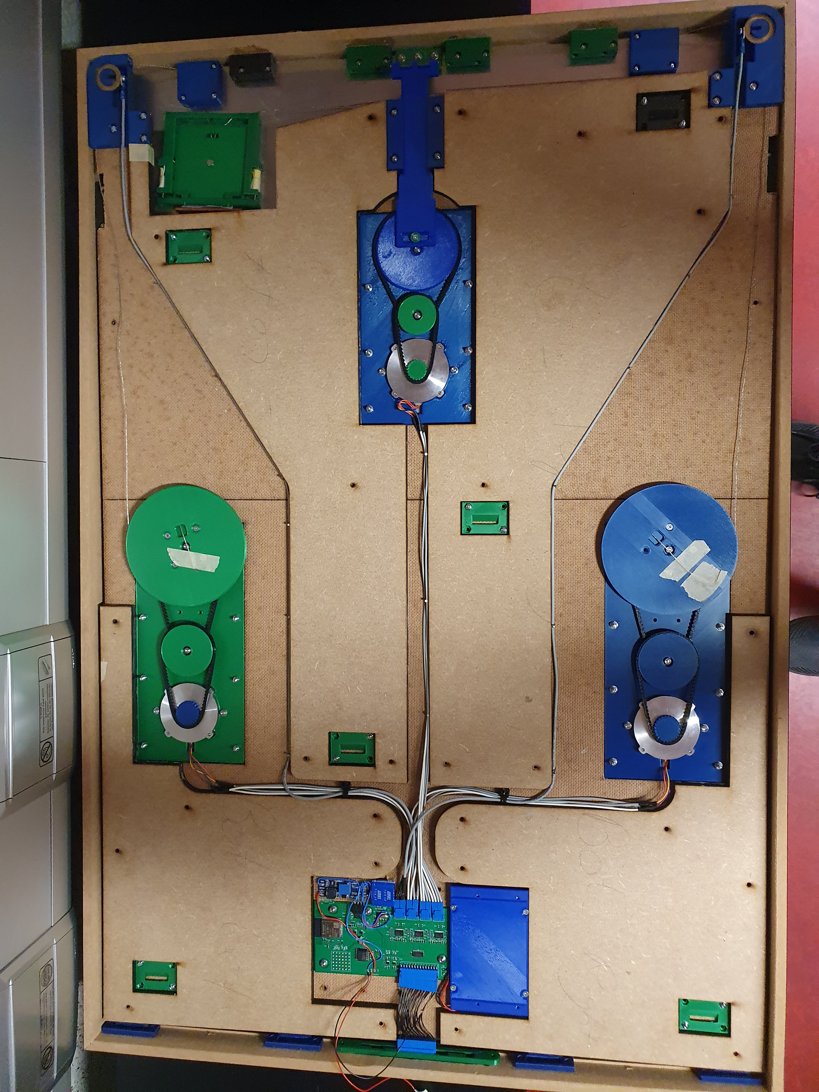
6_Fotos/20210608_213943.jpg
