lpm97/BA_MagicTrick/6_Fotos/PXL_20210506_170301834.jpg

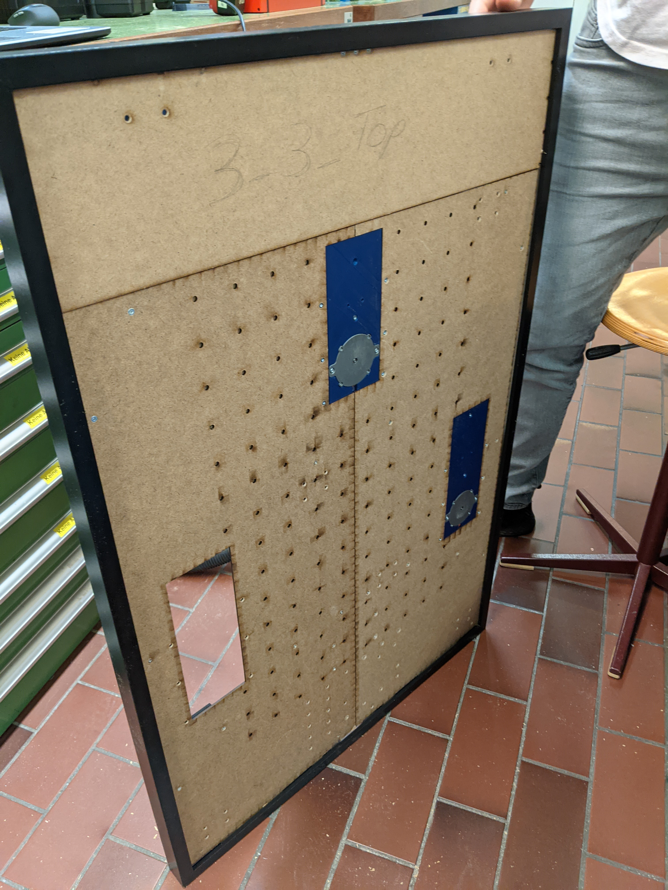
6_Fotos/PXL_20210506_170301834.jpg
