lpm97/BA_MagicTrick/6_Fotos/PXL_20210513_122111128.jpg

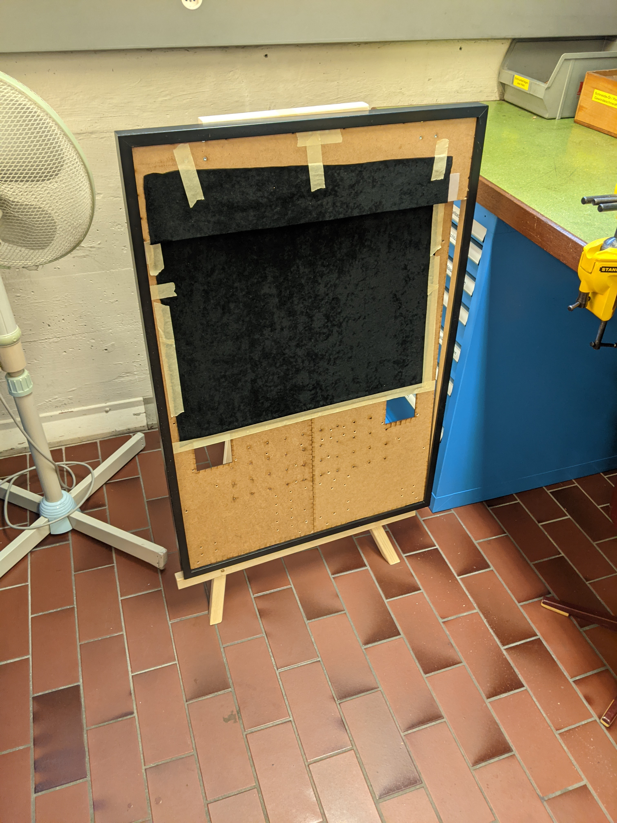
6_Fotos/PXL_20210513_122111128.jpg
