lpm97/BA_MagicTrick/6_Fotos/PXL_20210513_122357948.jpg

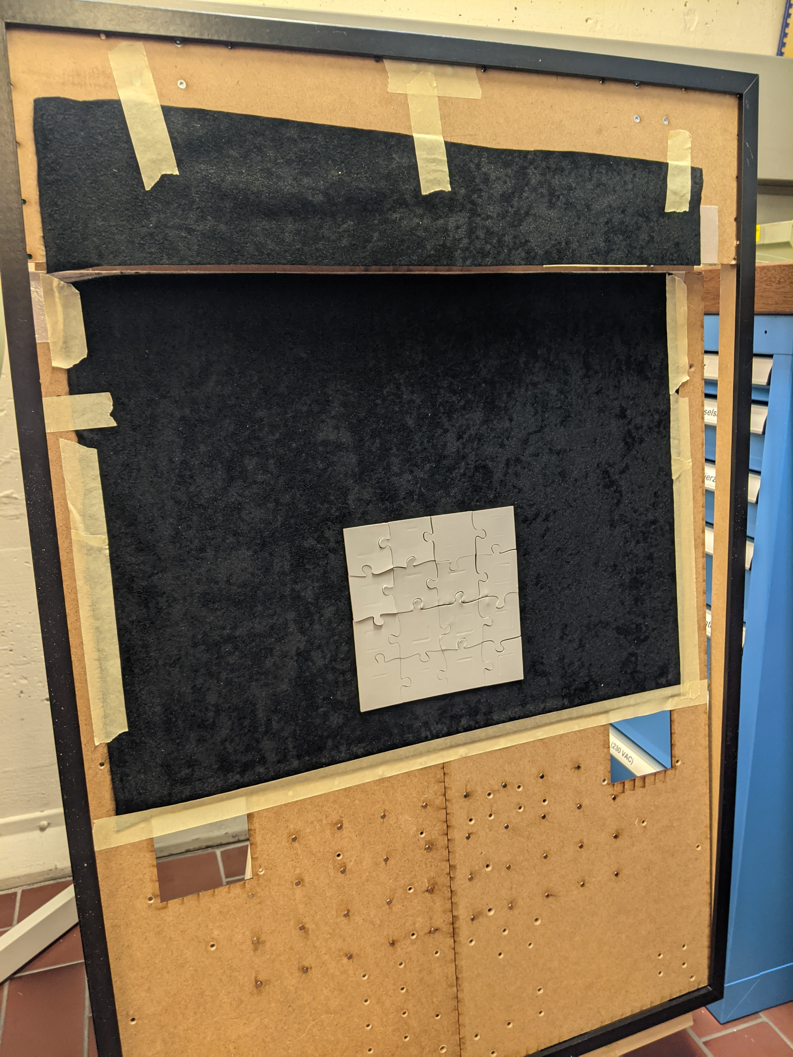
6_Fotos/PXL_20210513_122357948.jpg
