lpm97/BA_MagicTrick/6_Fotos/PXL_20210520_151910940.jpg

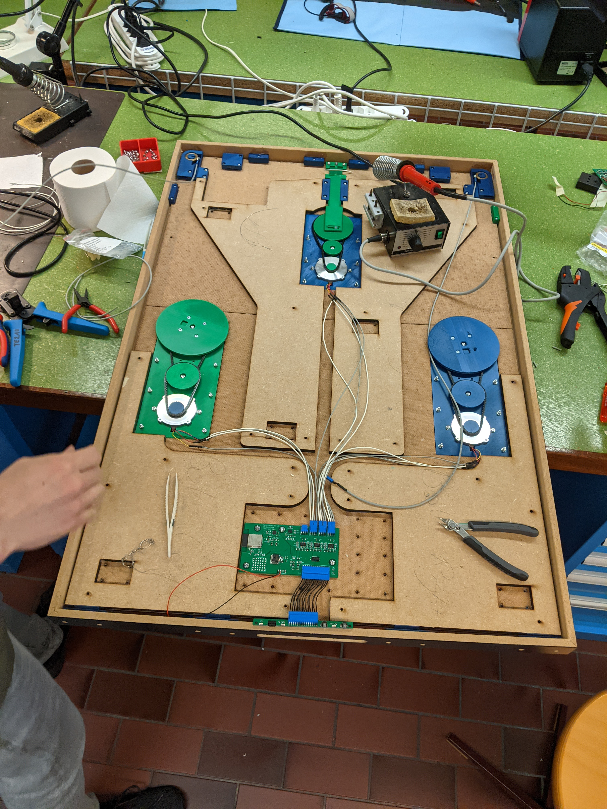
6_Fotos/PXL_20210520_151910940.jpg
