lpm97/BA_MagicTrick/6_Fotos/PXL_20210520_155436586.jpg

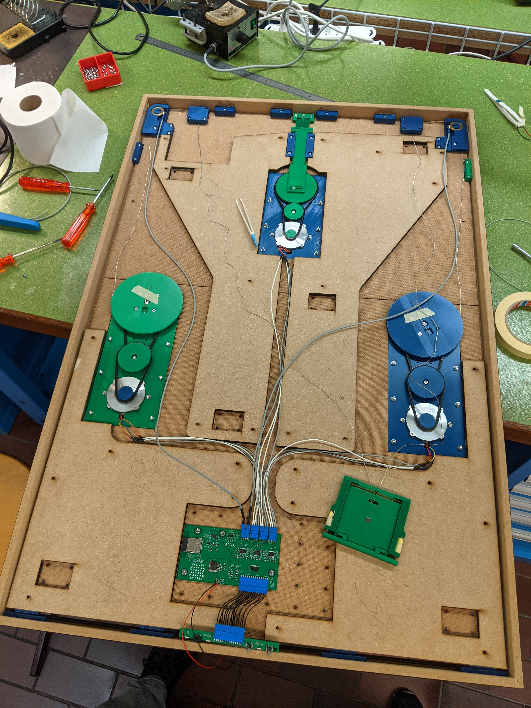
6_Fotos/PXL_20210520_155436586.jpg
