lpm97/BA_MagicTrick/6_Fotos/PXL_20210525_132730391.jpg

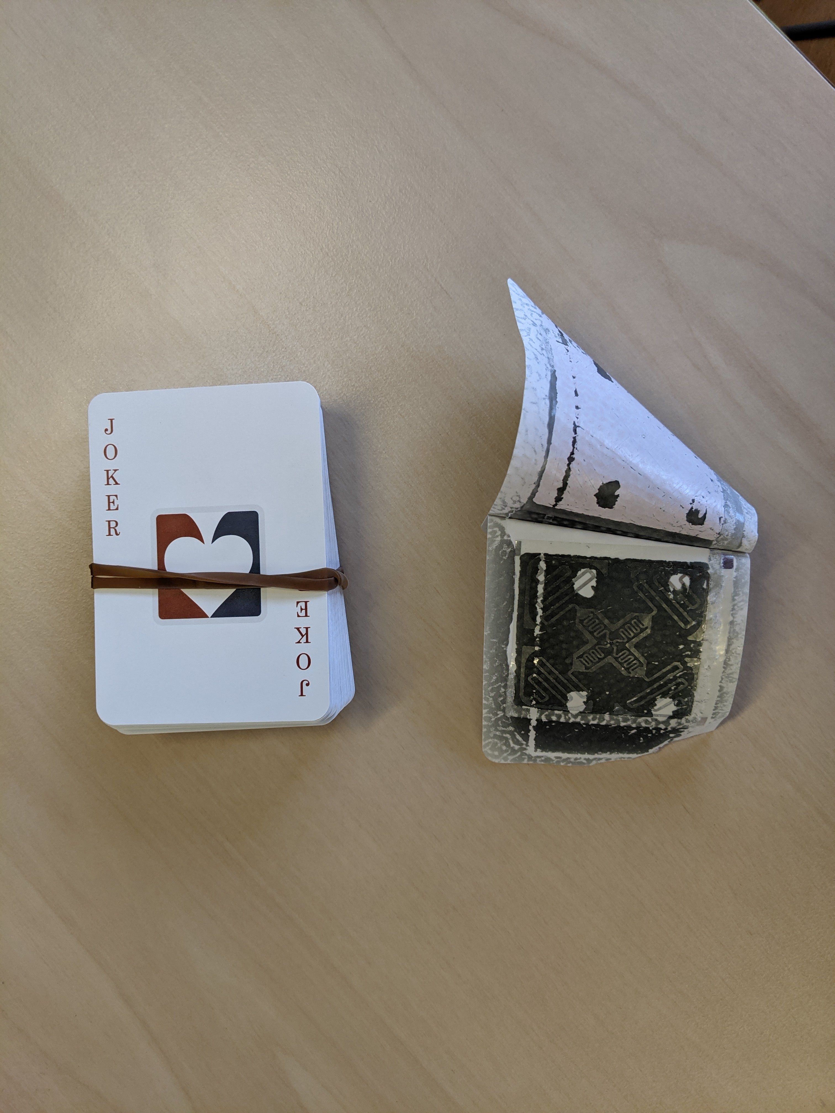
6_Fotos/PXL_20210525_132730391.jpg
